stephan-stansfield/cam-mech/CAD/benchtop-prototype/_3d-prints/print 2025-10-21/asm-cams.STEP

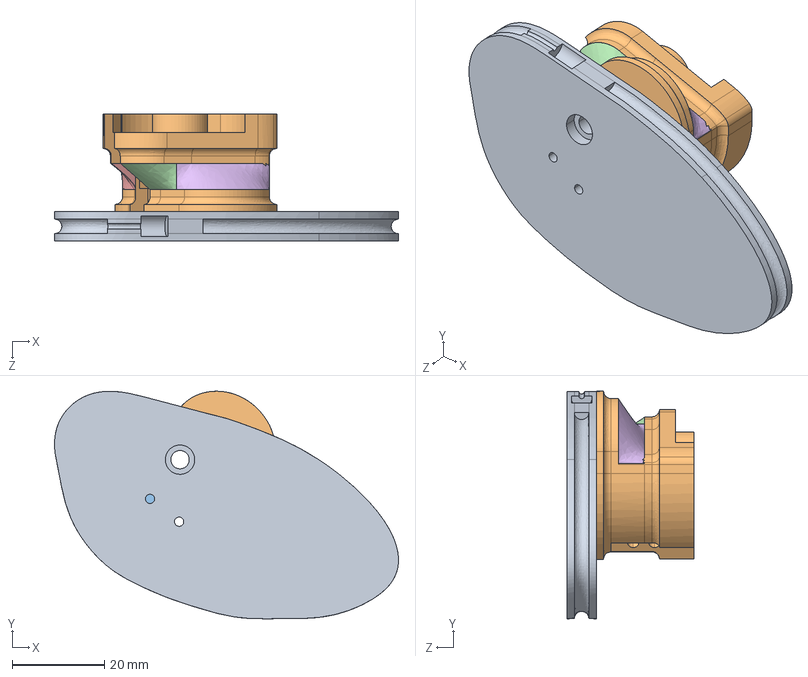
[picture p2: CAD file, 2025-12-18]
CAD/benchtop-prototype/_3d-prints/print 2025-10-21/asm-cams.STEP
74.5 x 49.3 x 27.5 mm
cam-storage
cams-joined^asm-cams
