stephan-stansfield/cam-mech/CAD/benchtop-prototype/_3d-prints/print 2025-10-26/9/cams-joined^asm-cams.STEP

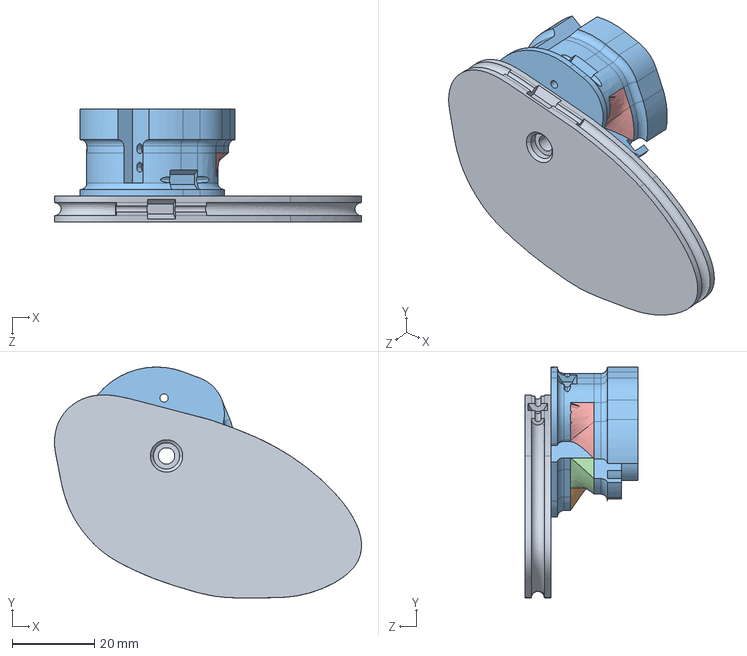
[picture p3: CAD file, 2025-12-18]
CAD/benchtop-prototype/_3d-prints/print 2025-10-26/9/cams-joined^asm-cams.STEP
74.5 x 56.0 x 27.5 mm
