stephan-stansfield/cam-mech/CAD/expanding-pulley/asm_expanding-pulley-asymmetric.SLDASM

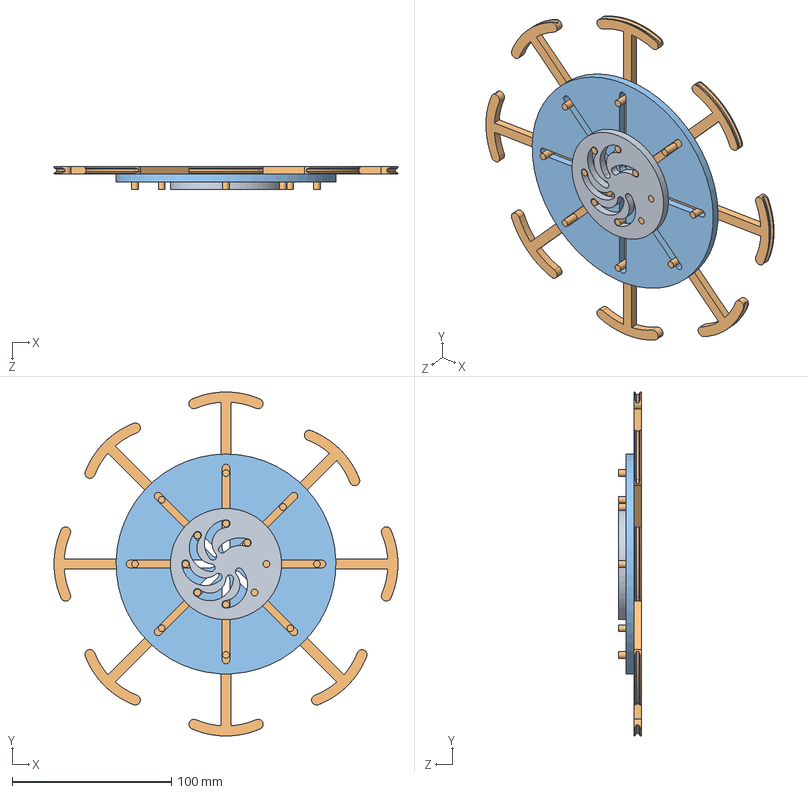
[picture p5: CAD file, 2023-11-07]
CAD/expanding-pulley/asm_expanding-pulley-asymmetric.SLDASM
216.1 x 216.1 x 14.3 mm
pulley-disc-asymmetric
pulley-slider x 8
pulley-slot
