stephan-stansfield/cam-mech/CAD/benchtop-prototype/_3d-prints/print 2024-10-28/NewPart^asm_benchtop_device.STEP

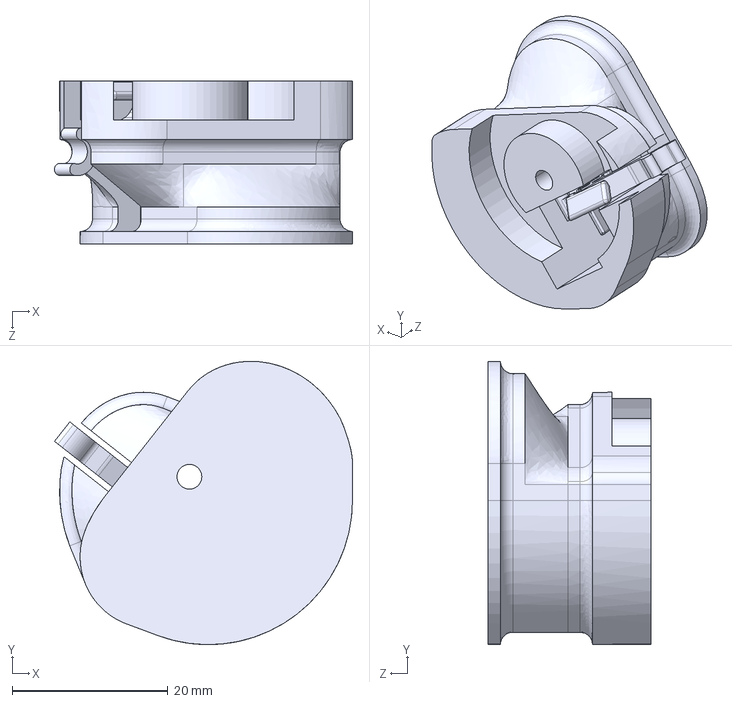
[picture p6: CAD file, 2024-10-28]
CAD/benchtop-prototype/_3d-prints/print 2024-10-28/NewPart^asm_benchtop_device.STEP
38.3 x 36.4 x 20.9 mm
