stephan-stansfield/cam-mech/CAD/benchtop-prototype/_3d-prints/print 2024-11-07/NewPart^asm_benchtop_device.STEP

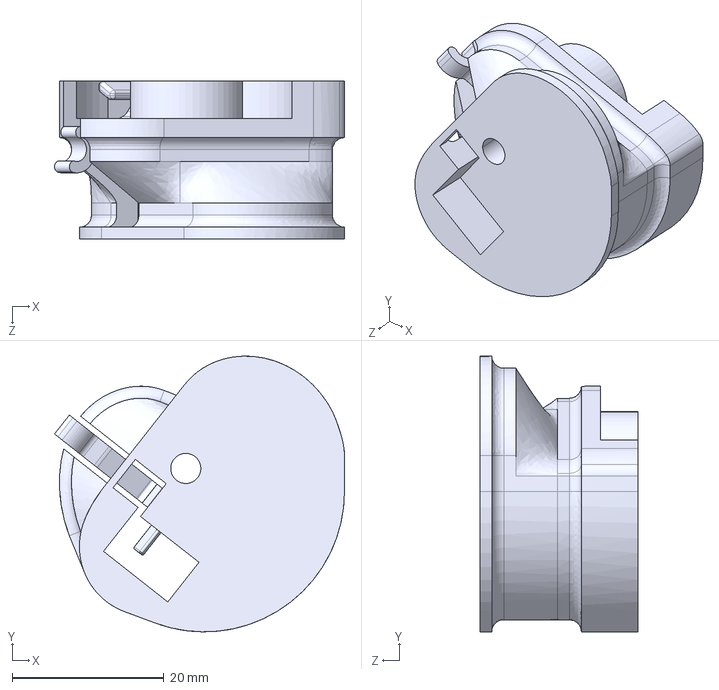
[picture p7: CAD file, 2024-11-07]
CAD/benchtop-prototype/_3d-prints/print 2024-11-07/NewPart^asm_benchtop_device.STEP
38.3 x 36.4 x 20.9 mm
