stephan-stansfield/cam-mech/CAD/benchtop-prototype/_3d-prints/print 2025-10-18/cams-joined^asm-cams.STEP

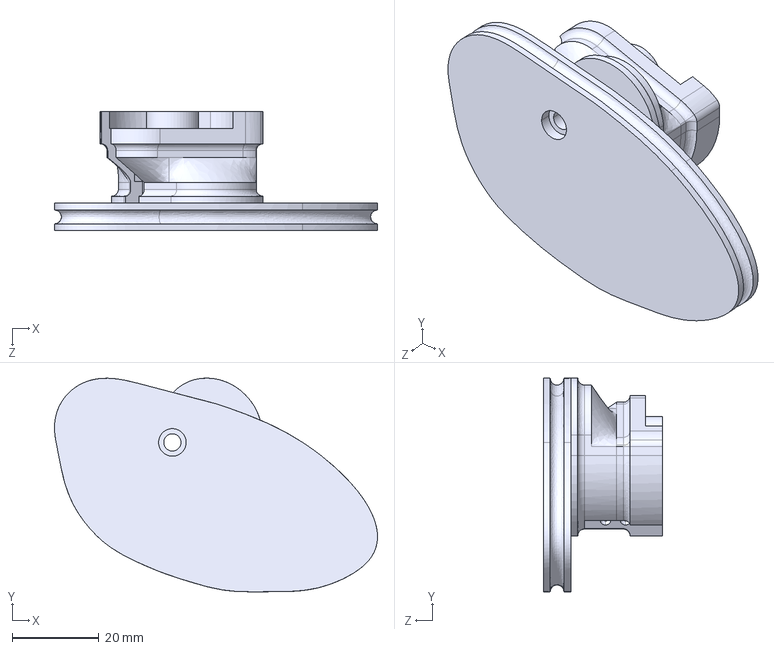
[picture p9: CAD file, 2025-12-18]
CAD/benchtop-prototype/_3d-prints/print 2025-10-18/cams-joined^asm-cams.STEP
74.5 x 49.3 x 27.5 mm
