stephan-stansfield/cam-mech/CAD/benchtop-prototype/_3d-prints/print 2025-11-18/asm-cams.STEP

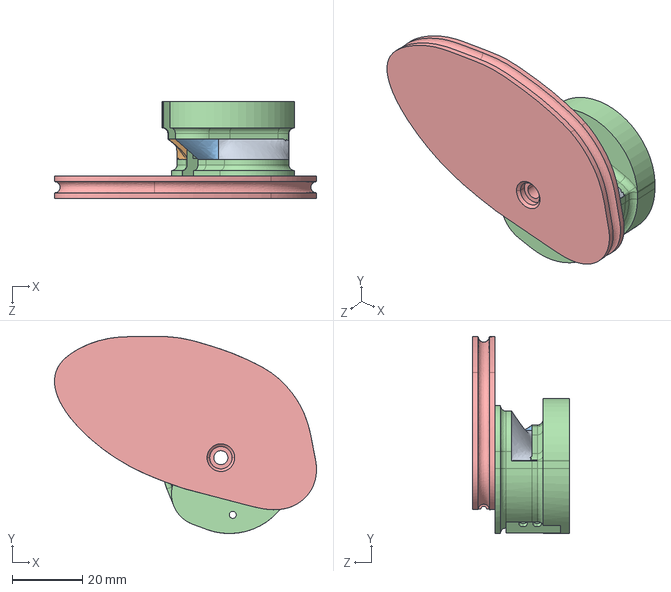
[picture p11: CAD file, 2025-12-18]
CAD/benchtop-prototype/_3d-prints/print 2025-11-18/asm-cams.STEP
74.5 x 56.0 x 27.5 mm
cam-transmission
cam-storage
