stephan-stansfield/cam-mech/CAD/benchtop-prototype/_3d-prints/print 2026-05-18/Part1^asm-cams-no-switching.STEP

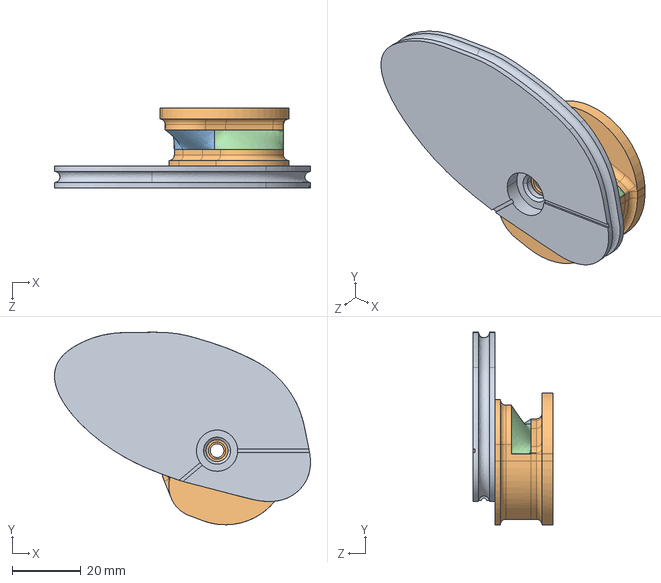
[picture p12: CAD file, 2026-06-06]
CAD/benchtop-prototype/_3d-prints/print 2026-05-18/Part1^asm-cams-no-switching.STEP
74.4 x 56.0 x 23.2 mm
