stephan-stansfield/cam-mech/CAD/benchtop-prototype/_3d-prints/print 2026-07-26/Part1^asm-cams-manual-switching.STEP

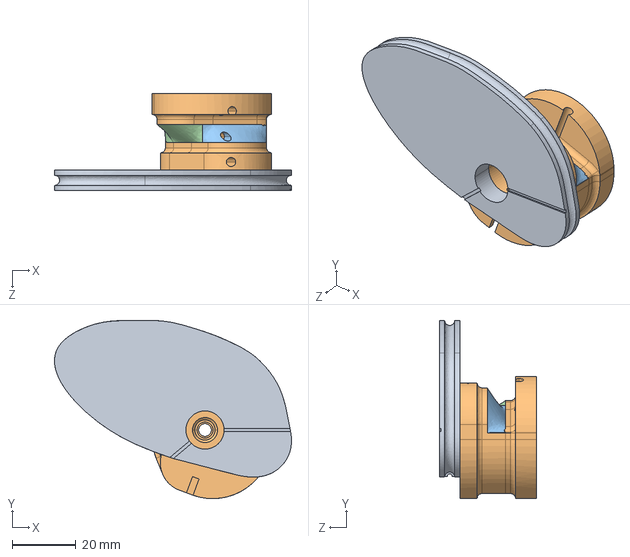
[picture p13: CAD file, 2026-07-26]
CAD/benchtop-prototype/_3d-prints/print 2026-07-26/Part1^asm-cams-manual-switching.STEP
74.5 x 56.0 x 30.4 mm
