stephan-stansfield/cam-mech/CAD/Cam Mechanism CAD 12-2022/prototyping/assembly-check-2023-08-09.SLDASM

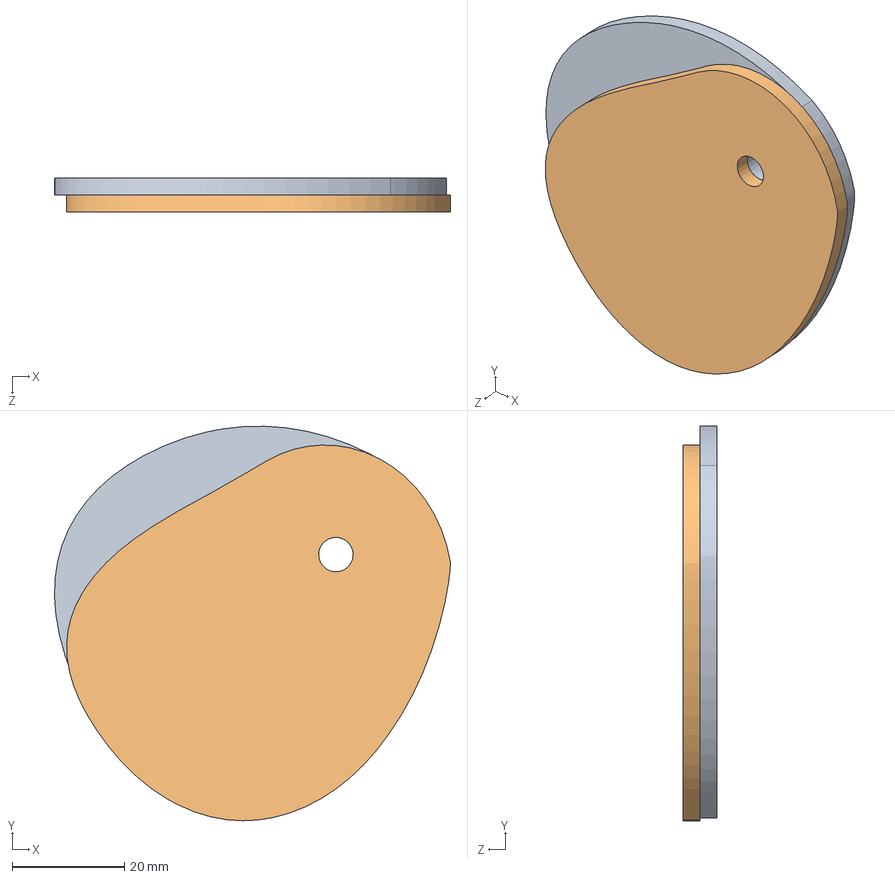
[picture p14: CAD file, 2023-11-07]
CAD/Cam Mechanism CAD 12-2022/prototyping/assembly-check-2023-08-09.SLDASM
70.5 x 70.3 x 6.00 mm
inner_cam_profile_2023-08-09
inner_cam_profile
