stephan-stansfield/cam-mech/CAD/expanding-pulley/asm_expanding-pulley.SLDASM

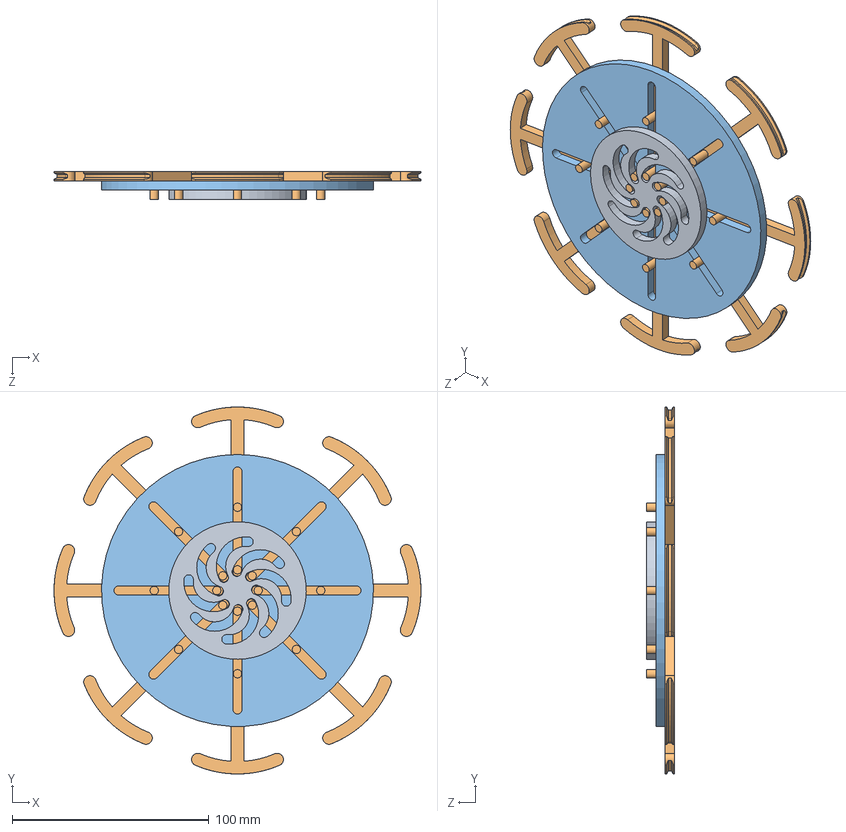
[picture p17: CAD file, 2023-08-03]
CAD/expanding-pulley/asm_expanding-pulley.SLDASM
186.4 x 186.4 x 14.3 mm
pulley-disc
pulley-slider x 8
pulley-slot
