stephan-stansfield/cam-mech/CAD/bistable-switch/asm_2023-11-13/asm_cam_switch.SLDASM

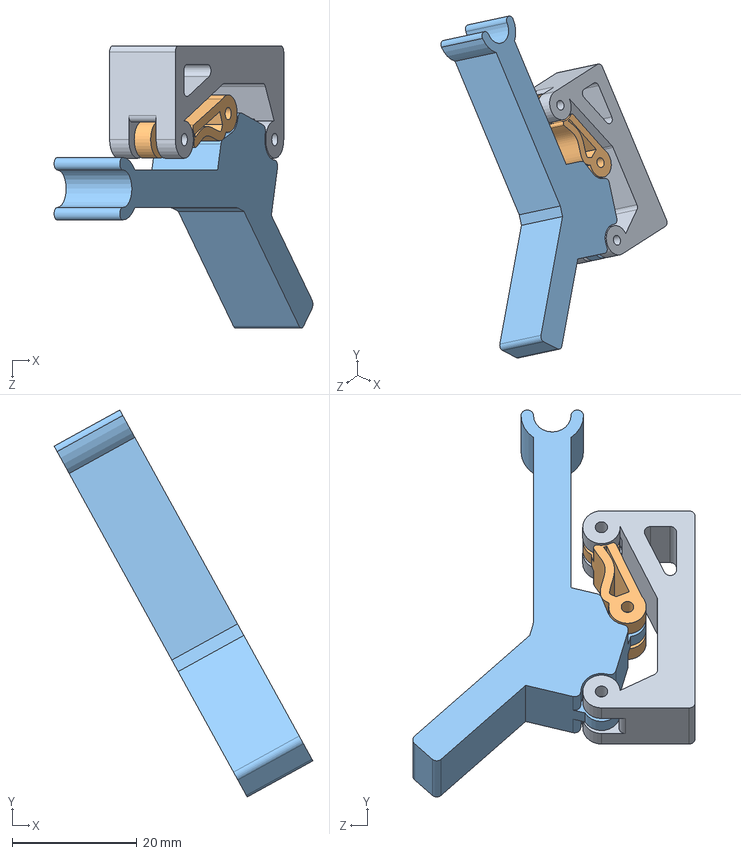
[picture p18: CAD file, 2023-11-07]
CAD/bistable-switch/asm_2023-11-13/asm_cam_switch.SLDASM
41.4 x 61.9 x 45.2 mm
switch-base
switch-hinge
switch-toggle
