stephan-stansfield/cam-mech/CAD/Cam Mechanism CAD 12-2022/cam_assembly_sandbox.SLDASM

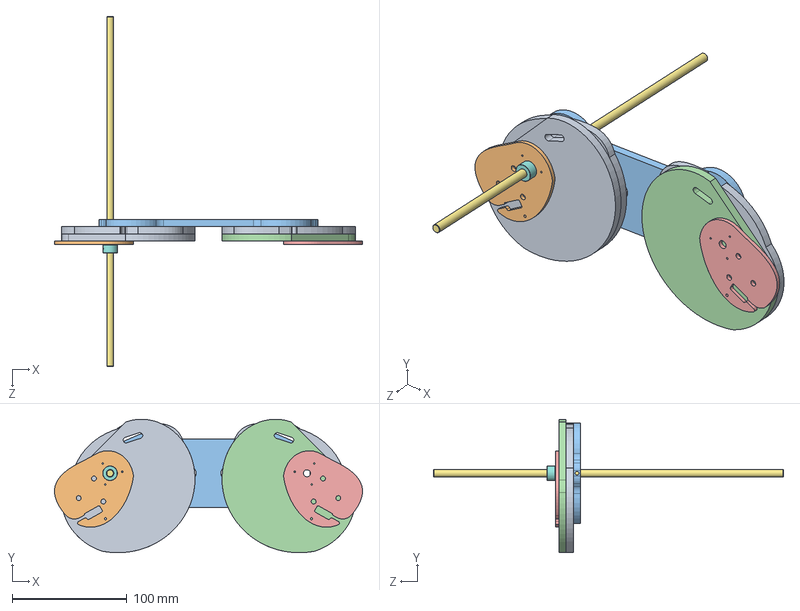
[picture p19: CAD file, 2023-08-03]
CAD/Cam Mechanism CAD 12-2022/cam_assembly_sandbox.SLDASM
268.2 x 116.2 x 304.8 mm
outer_cam_sandbox
inner_cam
cam_backing
Mirrorouter_cam
Mirrorinner_cam
57155K323_Stainless Steel Ball Bearing
8632T139_D-Profile Rotary Shaft
9414T6_Set Screw Shaft Collar
outer_cam_sandbox_profile_2 x 2
