stephan-stansfield/cam-mech/CAD/Cam Mechanism CAD 12-2022/first_prototype/cam_assembly_STS.SLDASM

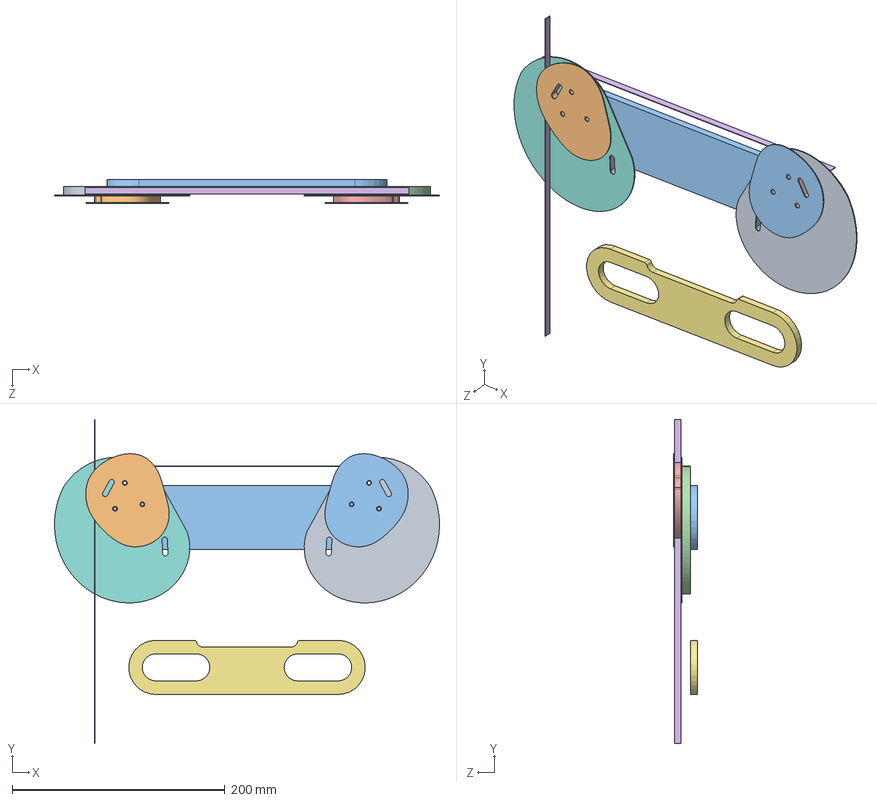
[picture p20: CAD file, 2023-07-26]
CAD/Cam Mechanism CAD 12-2022/first_prototype/cam_assembly_STS.SLDASM
361.7 x 304.8 x 22.3 mm
outer_cam
inner_cam
cam_backing
Mirrorouter_cam
Mirrorinner_cam
elastic_band_between x 2
pull_handle
outer_cam_cover
Mirrorouter_cam_cover
inner_cam_cover
Mirrorinner_cam_cover
