stephan-stansfield/cam-mech/CAD/Cam Mechanism CAD 12-2022/first_prototype/cam_assembly.SLDASM

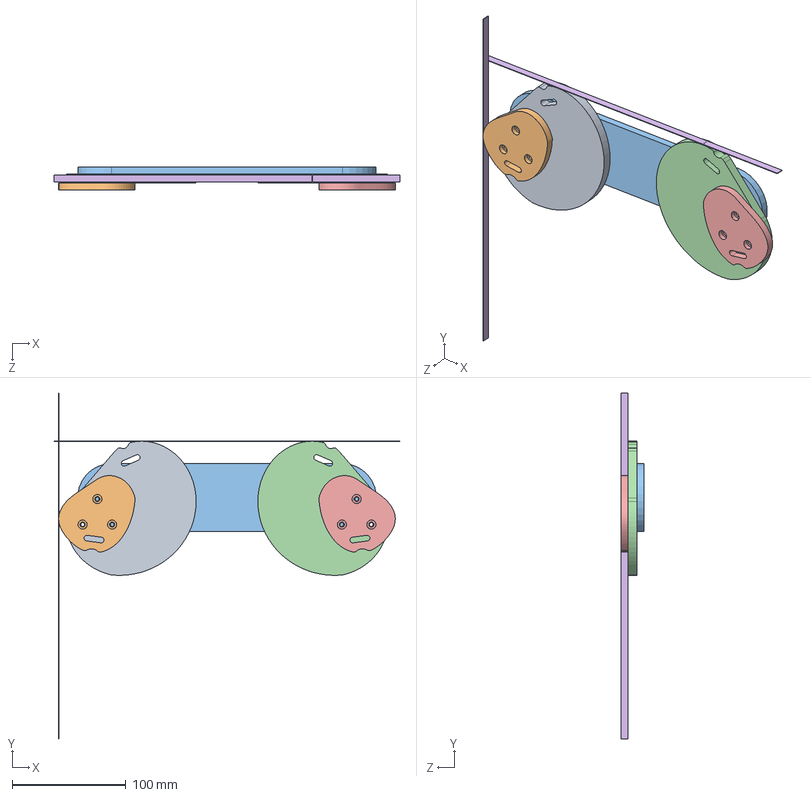
[picture p21: CAD file, 2023-07-26]
CAD/Cam Mechanism CAD 12-2022/first_prototype/cam_assembly.SLDASM
304.8 x 304.8 x 20.7 mm
outer_cam
inner_cam
cam_backing
Mirrorouter_cam
Mirrorinner_cam
elastic_band_between x 2
