stephan-stansfield/cam-mech/CAD/benchtop-prototype/_3d-prints/print 2024-07-30/cam_transmission.STEP

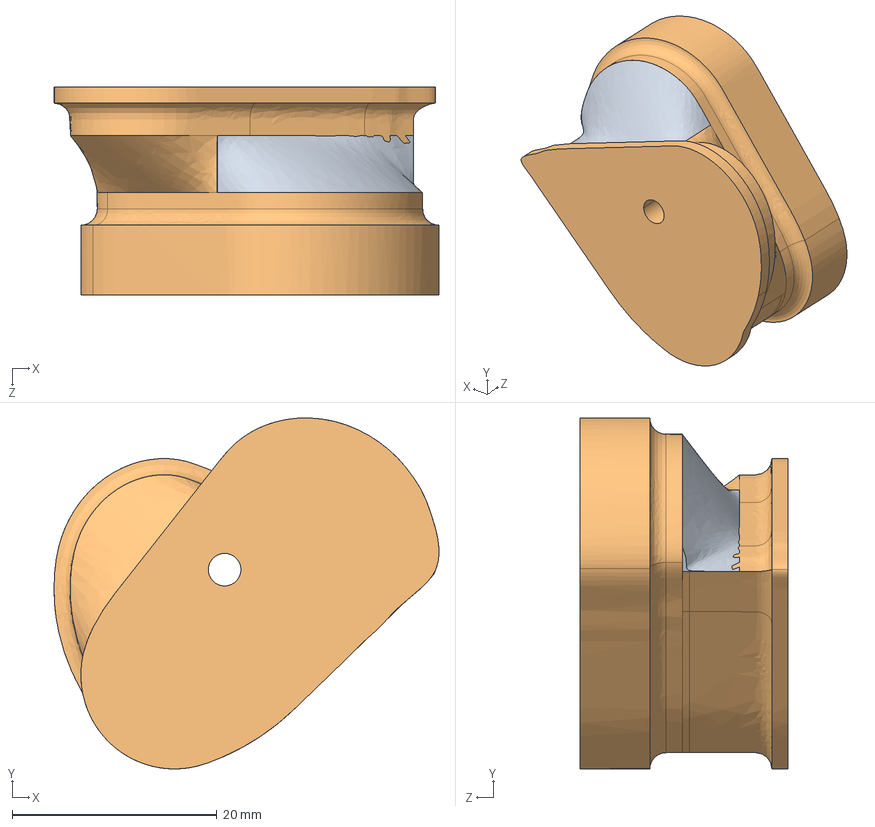
[picture p22: CAD file, 2024-07-30]
CAD/benchtop-prototype/_3d-prints/print 2024-07-30/cam_transmission.STEP
37.6 x 34.3 x 20.3 mm
