stephan-stansfield/cam-mech/CAD/benchtop-prototype/_3d-prints/print 2024-08-01/switch-flexures_rev1.STEP

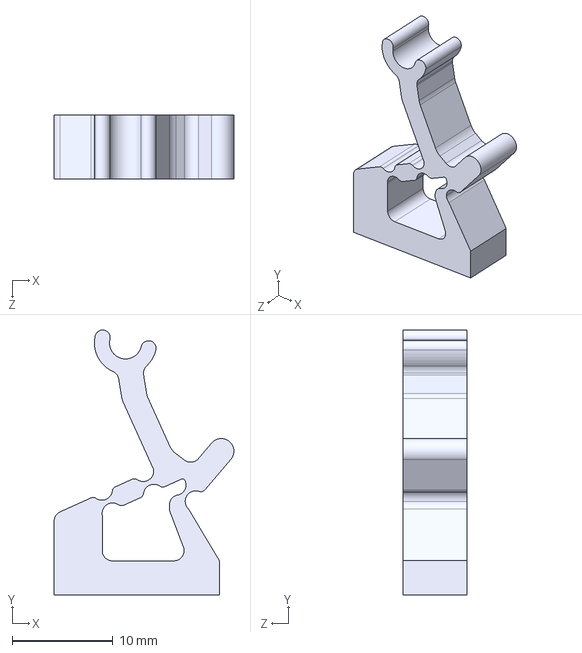
[picture p23: CAD file, 2024-08-21]
CAD/benchtop-prototype/_3d-prints/print 2024-08-01/switch-flexures_rev1.STEP
17.8 x 26.2 x 6.35 mm
