stephan-stansfield/cam-mech/CAD/benchtop-prototype/_3d-prints/print 2024-10-28/derailleur.STEP

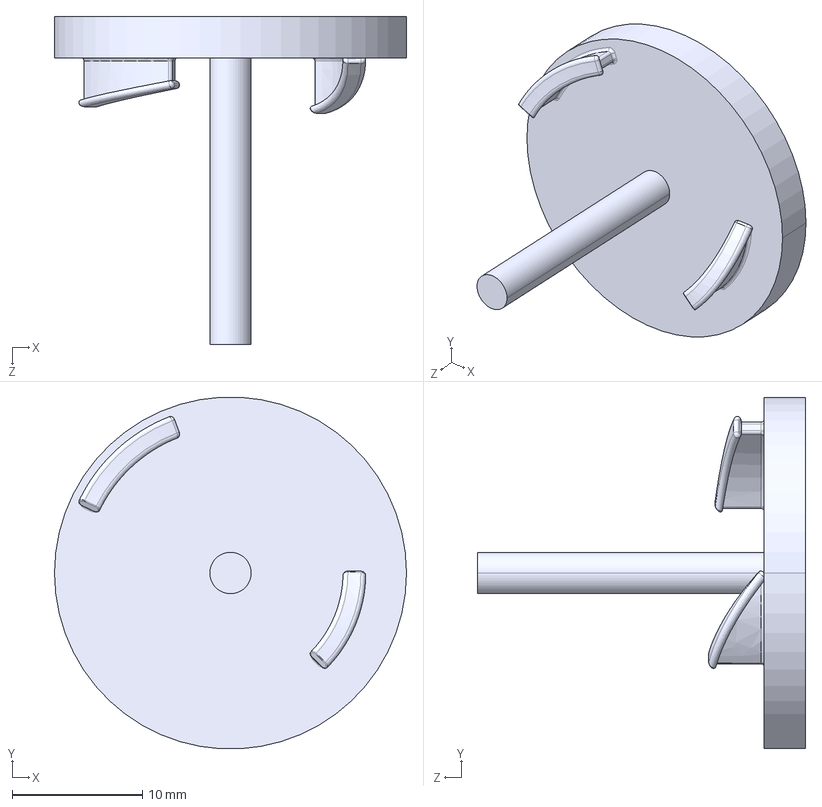
[picture p24: CAD file, 2024-11-01]
CAD/benchtop-prototype/_3d-prints/print 2024-10-28/derailleur.STEP
27.0 x 27.0 x 25.2 mm
