stephan-stansfield/cam-mech/CAD/benchtop-prototype/_3d-prints/print 2024-11-07/derailleur.STEP

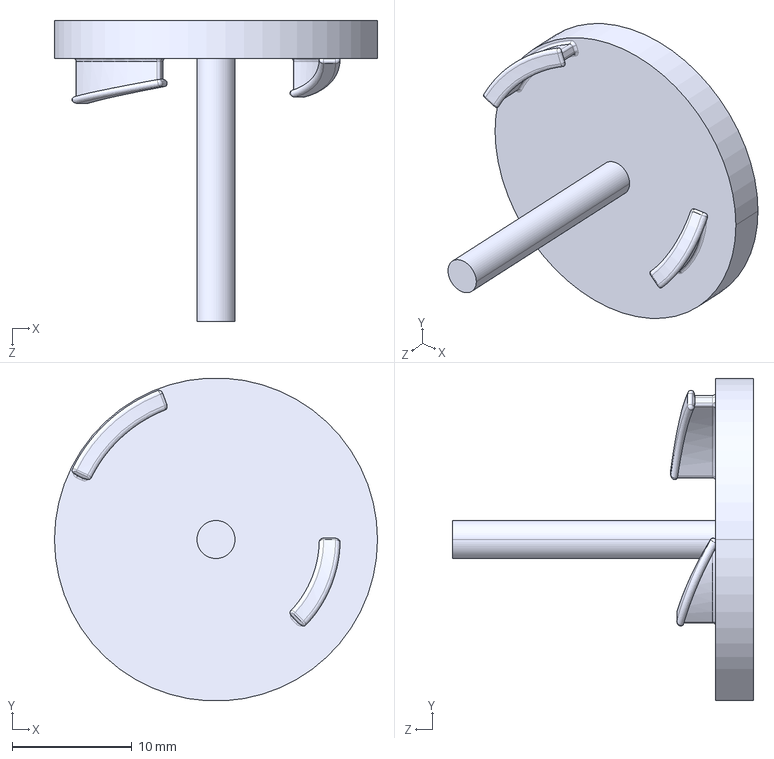
[picture p25: CAD file, 2024-11-07]
CAD/benchtop-prototype/_3d-prints/print 2024-11-07/derailleur.STEP
27.0 x 27.0 x 25.2 mm
