stephan-stansfield/cam-mech/CAD/benchtop-prototype/_3d-prints/print 2024-11-12/switch-flexures.STEP

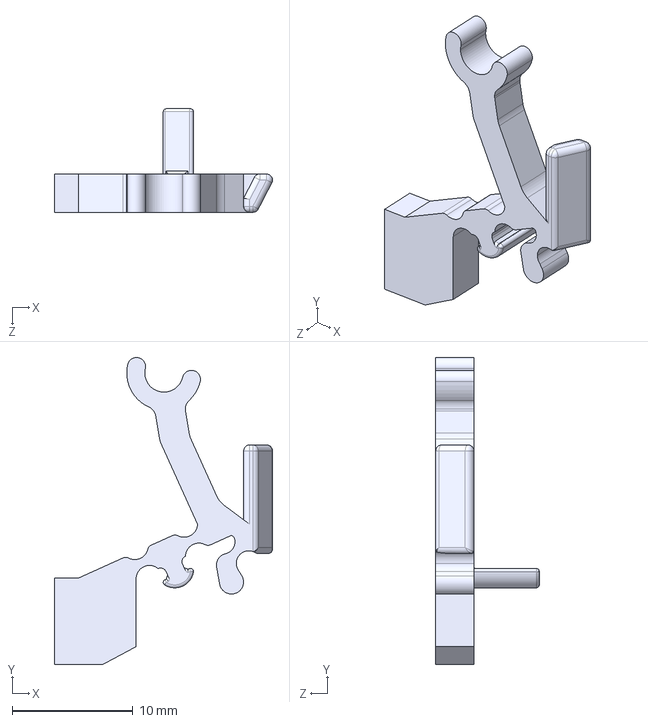
[picture p26: CAD file, 2024-11-12]
CAD/benchtop-prototype/_3d-prints/print 2024-11-12/switch-flexures.STEP
18.1 x 25.5 x 8.59 mm
