stephan-stansfield/cam-mech/CAD/benchtop-prototype/_3d-prints/print 2024-11-15/switch-flexures_0-125in-thick_0-65mm-flex.STEP

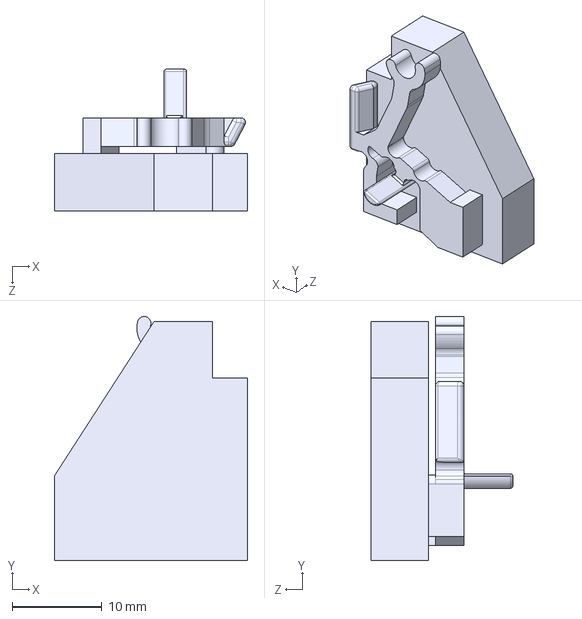
[picture p27: CAD file, 2024-11-15]
CAD/benchtop-prototype/_3d-prints/print 2024-11-15/switch-flexures_0-125in-thick_0-65mm-flex.STEP
21.5 x 27.1 x 15.7 mm
