stephan-stansfield/cam-mech/CAD/benchtop-prototype/_3d-prints/print 2024-11-22/batch 1/switch-flexures_0-1875in-thick_0-65mm-flex.STEP

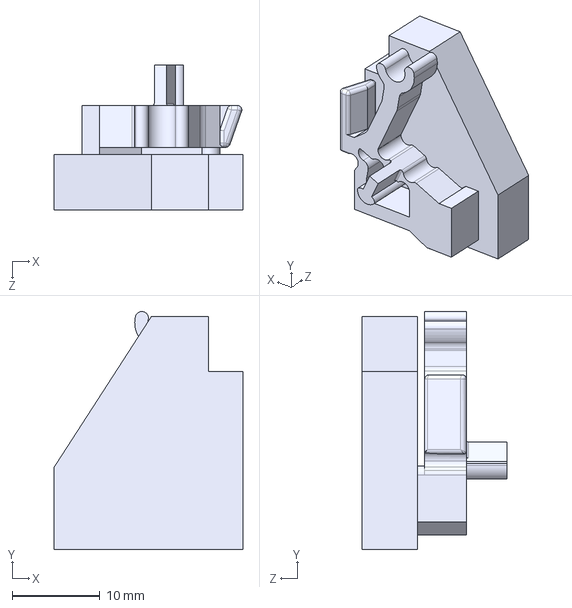
[picture p28: CAD file, 2025-10-06]
CAD/benchtop-prototype/_3d-prints/print 2024-11-22/batch 1/switch-flexures_0-1875in-thick_0-65mm-flex.STEP
21.5 x 27.1 x 16.5 mm
