stephan-stansfield/cam-mech/CAD/benchtop-prototype/_3d-prints/print 2025-09-25/switch-flexures_standalone.STEP

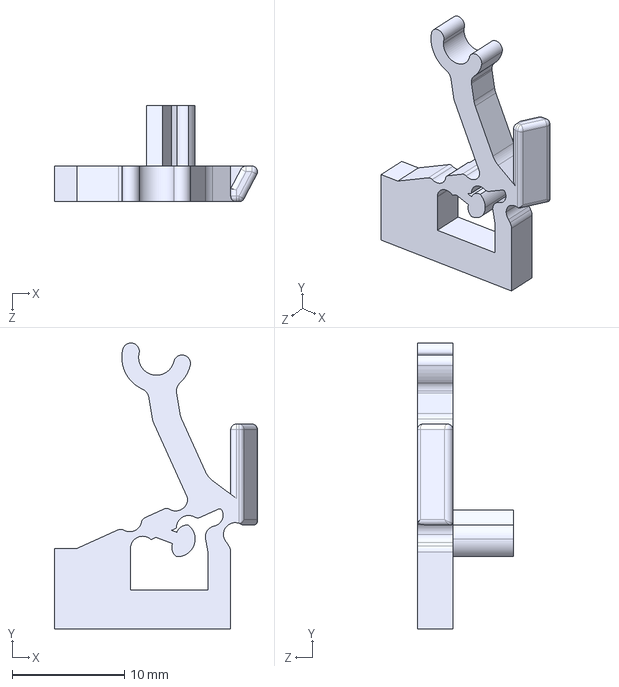
[picture p29: CAD file, 2025-10-06]
CAD/benchtop-prototype/_3d-prints/print 2025-09-25/switch-flexures_standalone.STEP
18.1 x 25.5 x 8.59 mm
