stephan-stansfield/cam-mech/CAD/benchtop-prototype/_3d-prints/print 2025-10-01/switch-flexures-separate.STEP

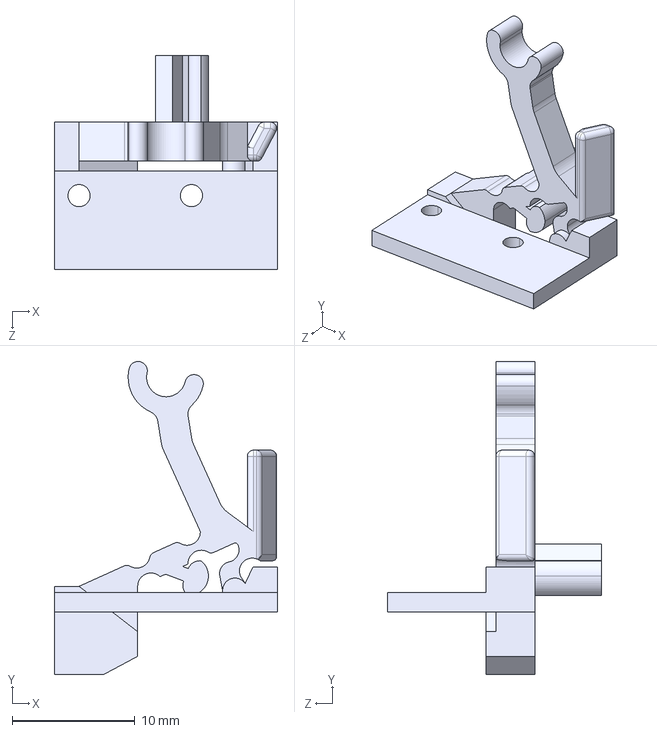
[picture p30: CAD file, 2025-10-06]
CAD/benchtop-prototype/_3d-prints/print 2025-10-01/switch-flexures-separate.STEP
18.1 x 25.5 x 17.4 mm
