stephan-stansfield/cam-mech/CAD/benchtop-prototype/_3d-prints/print 2025-10-07/switch-flexures-separate_v2.STEP

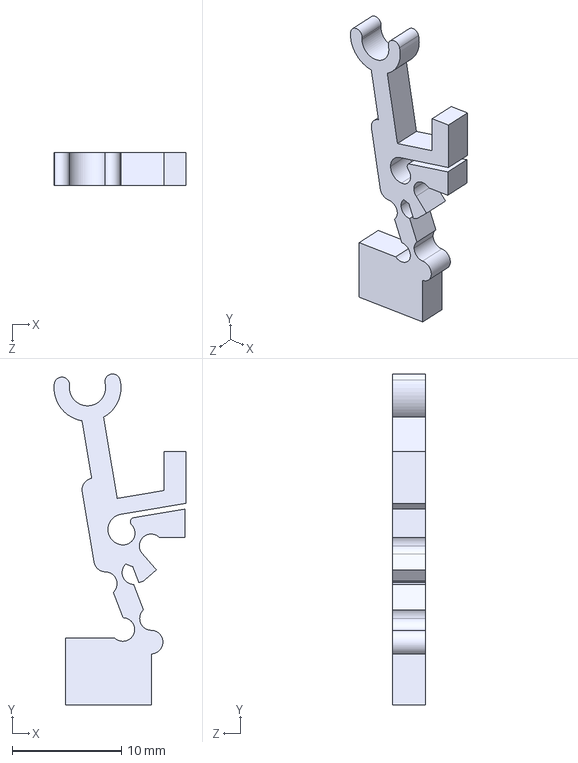
[picture p31: CAD file, 2025-10-17]
CAD/benchtop-prototype/_3d-prints/print 2025-10-07/switch-flexures-separate_v2.STEP
12.1 x 30.3 x 3.00 mm
