stephan-stansfield/cam-mech/CAD/benchtop-prototype/_3d-prints/print 2025-10-08/switch-flexures-separate_v2.STEP

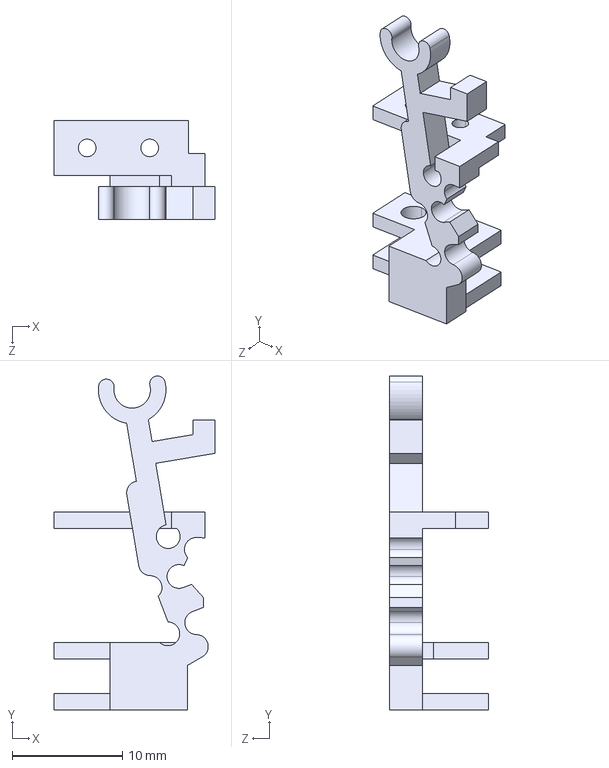
[picture p32: CAD file, 2025-10-17]
CAD/benchtop-prototype/_3d-prints/print 2025-10-08/switch-flexures-separate_v2.STEP
14.6 x 30.3 x 9.00 mm
