stephan-stansfield/cam-mech/CAD/benchtop-prototype/_3d-prints/print 2025-10-10/cam-transmission_v2.STEP

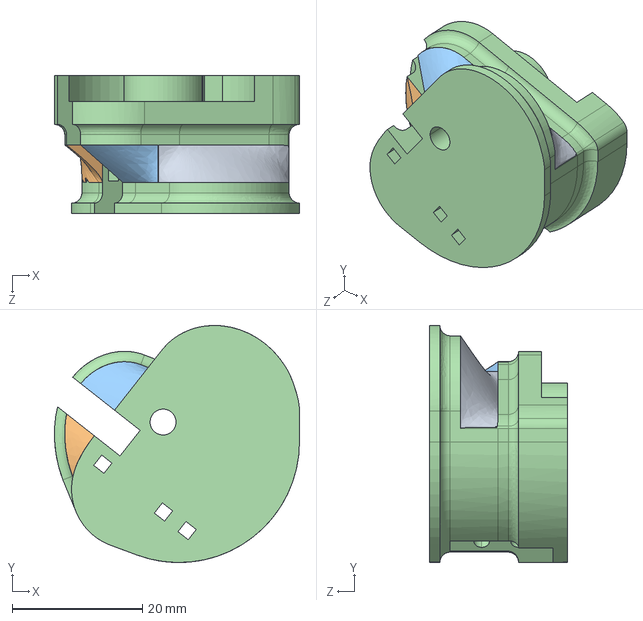
[picture p33: CAD file, 2025-10-17]
CAD/benchtop-prototype/_3d-prints/print 2025-10-10/cam-transmission_v2.STEP
37.6 x 36.4 x 21.2 mm
