stephan-stansfield/cam-mech/CAD/benchtop-prototype/_3d-prints/print 2025-10-13/switch-flexures-separate_v2_one-piece.STEP

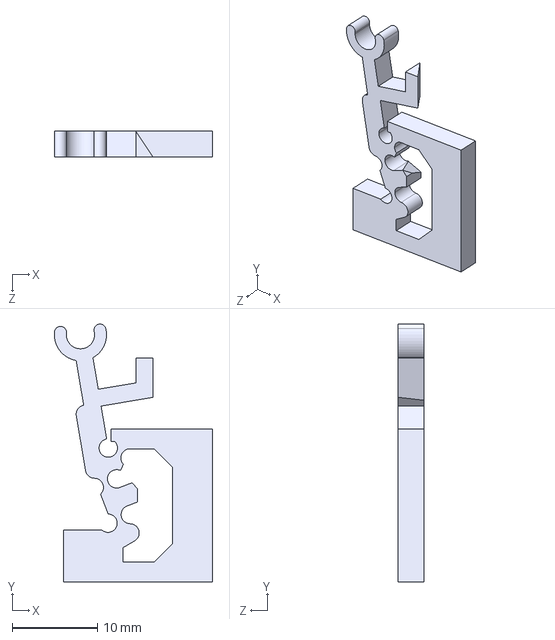
[picture p34: CAD file, 2025-10-17]
CAD/benchtop-prototype/_3d-prints/print 2025-10-13/switch-flexures-separate_v2_one-piece.STEP
18.6 x 30.3 x 3.00 mm
