stephan-stansfield/cam-mech/CAD/benchtop-prototype/_3d-prints/print 2025-10-14/switch-flexures-separate_v2_one-piece-spring-link.STEP

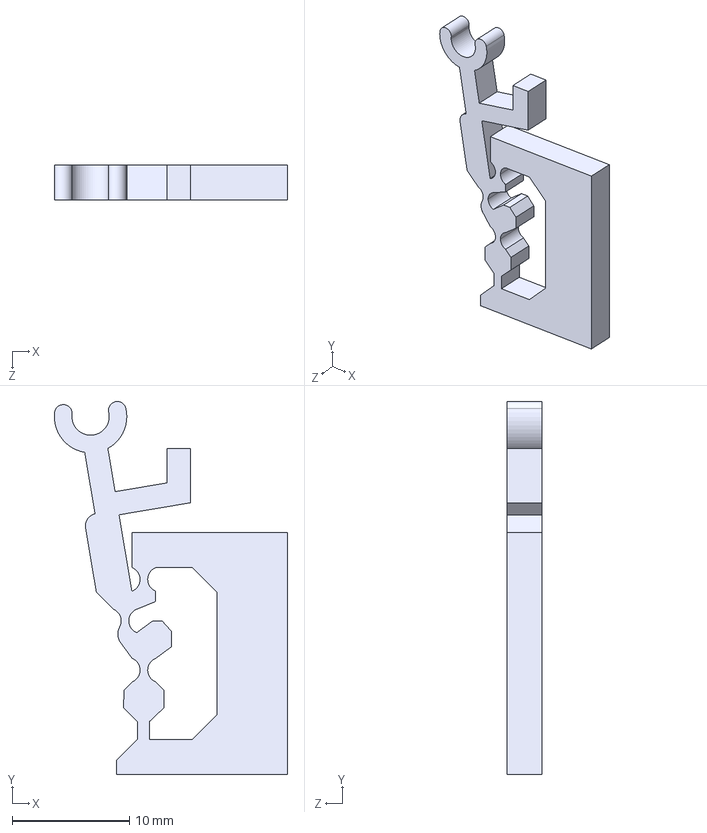
[picture p35: CAD file, 2025-10-17]
CAD/benchtop-prototype/_3d-prints/print 2025-10-14/switch-flexures-separate_v2_one-piece-spring-link.STEP
19.9 x 31.8 x 3.00 mm
