stephan-stansfield/cam-mech/CAD/benchtop-prototype/_3d-prints/print 2025-10-15/2/switch-flexures-separate_v2_one-piece-spring-link.STEP

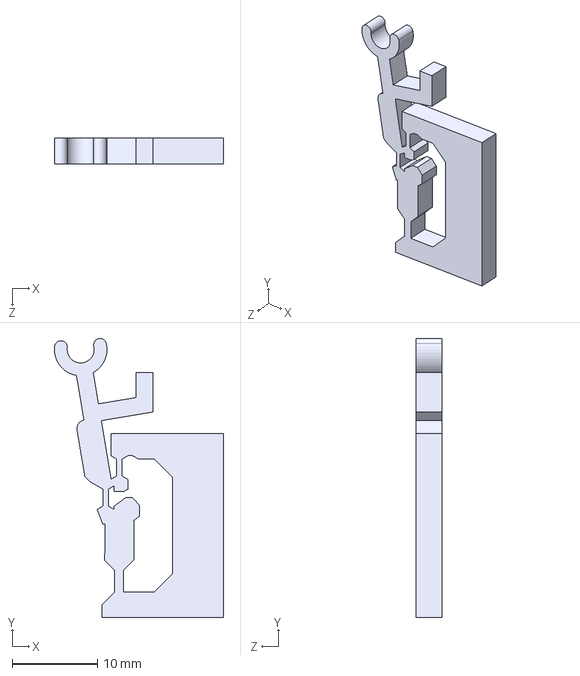
[picture p36: CAD file, 2025-10-17]
CAD/benchtop-prototype/_3d-prints/print 2025-10-15/2/switch-flexures-separate_v2_one-piece-spring-link.STEP
19.9 x 32.8 x 3.00 mm
