stephan-stansfield/cam-mech/CAD/benchtop-prototype/_3d-prints/print 2025-10-17/switch-flexures-separate_v2_one-piece-spring-link.STEP

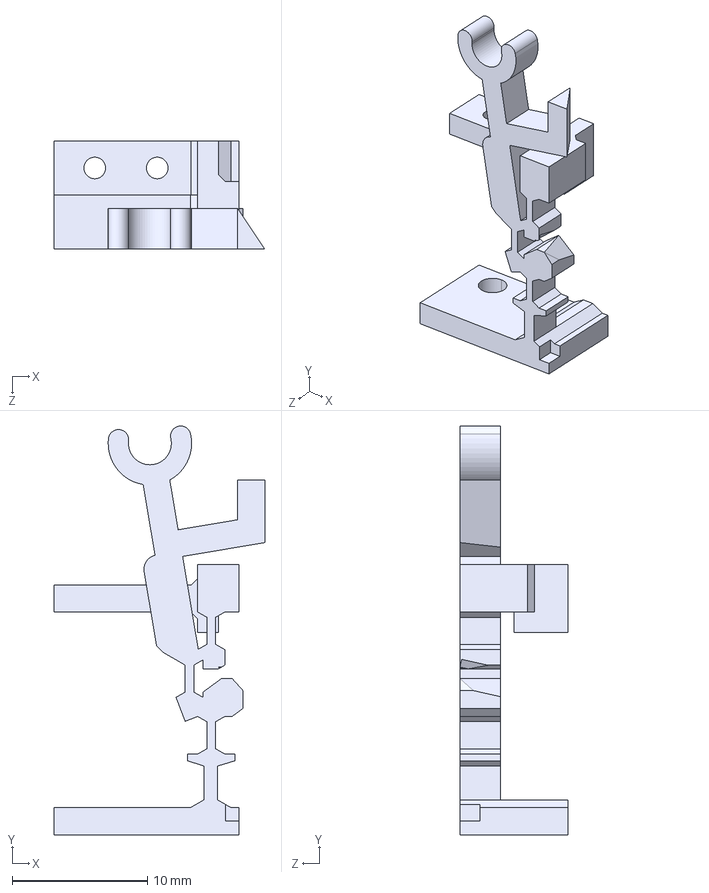
[picture p37: CAD file, 2025-12-18]
CAD/benchtop-prototype/_3d-prints/print 2025-10-17/switch-flexures-separate_v2_one-piece-spring-link.STEP
15.6 x 30.3 x 8.00 mm
