stephan-stansfield/cam-mech/CAD/benchtop-prototype/_3d-prints/print 2025-10-22/switch.STEP

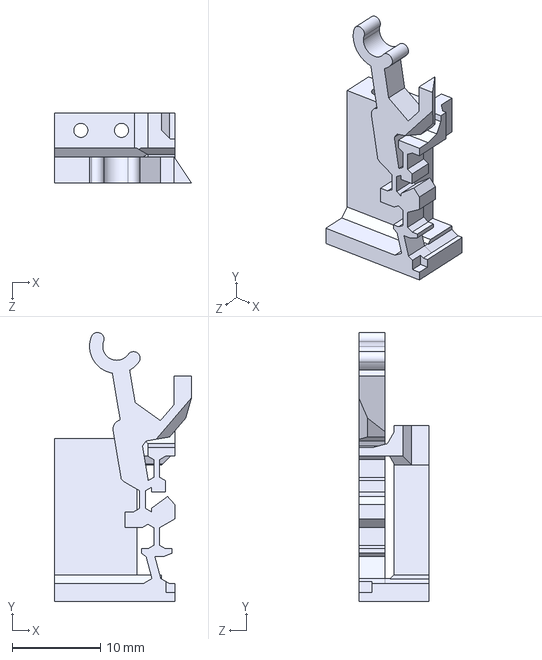
[picture p39: CAD file, 2025-12-18]
CAD/benchtop-prototype/_3d-prints/print 2025-10-22/switch.STEP
15.6 x 30.6 x 8.00 mm
