stephan-stansfield/cam-mech/CAD/benchtop-prototype/_3d-prints/print 2025-10-24/2/cable-sleeve-test.STEP

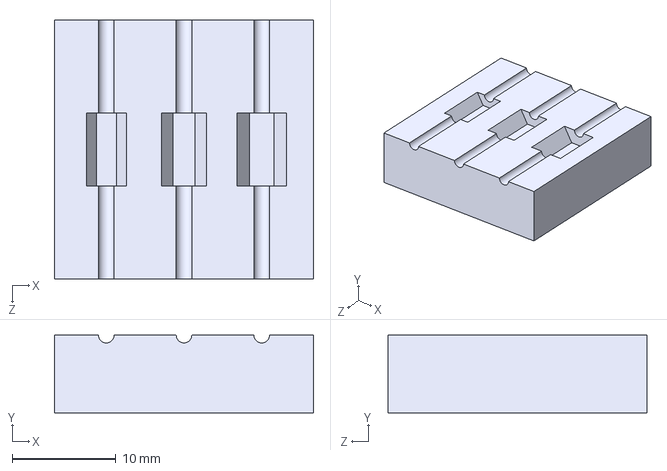
[picture p40: CAD file, 2025-12-18]
CAD/benchtop-prototype/_3d-prints/print 2025-10-24/2/cable-sleeve-test.STEP
25.0 x 7.50 x 25.0 mm
