stephan-stansfield/cam-mech/CAD/benchtop-prototype/_3d-prints/print 2025-10-24/3/storage-cable-jig.STEP

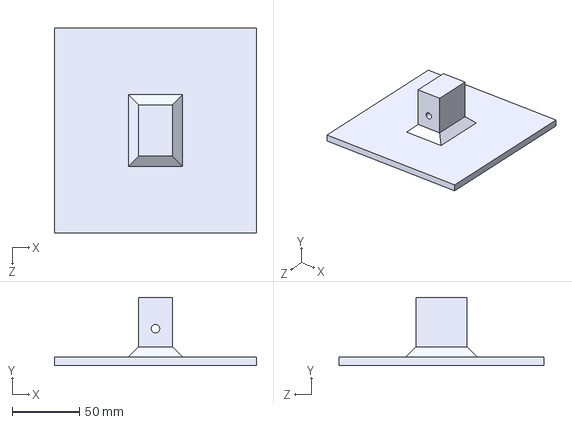
[picture p41: CAD file, 2025-12-18]
CAD/benchtop-prototype/_3d-prints/print 2025-10-24/3/storage-cable-jig.STEP
150.0 x 50.8 x 152.4 mm
