stephan-stansfield/cam-mech/CAD/benchtop-prototype/_3d-prints/print 2025-10-24/kuka-end-effector.STEP

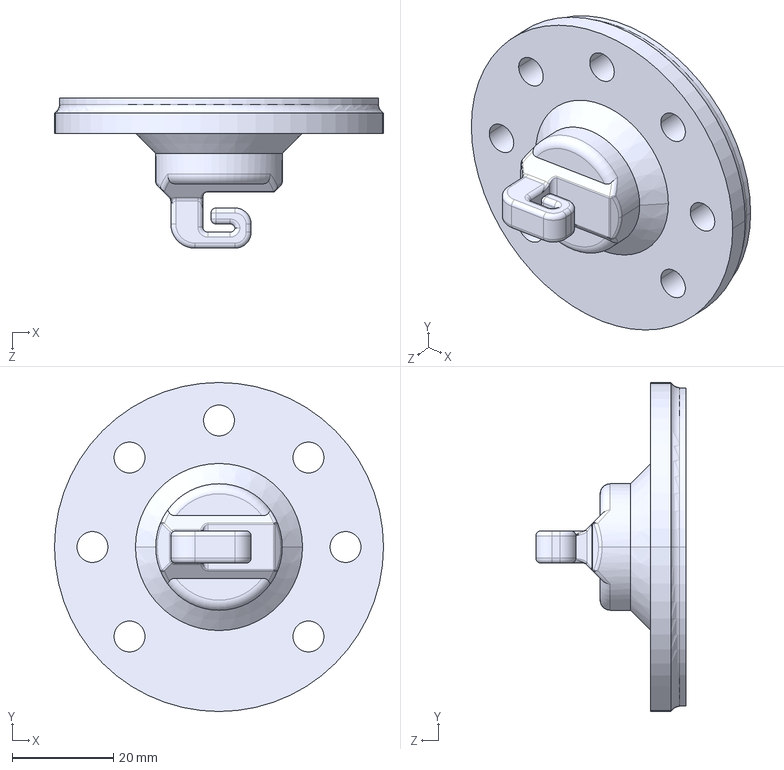
[picture p42: CAD file, 2025-12-18]
CAD/benchtop-prototype/_3d-prints/print 2025-10-24/kuka-end-effector.STEP
65.0 x 65.0 x 29.7 mm
