stephan-stansfield/cam-mech/CAD/benchtop-prototype/_3d-prints/print 2025-10-25/1/derailleur.STEP

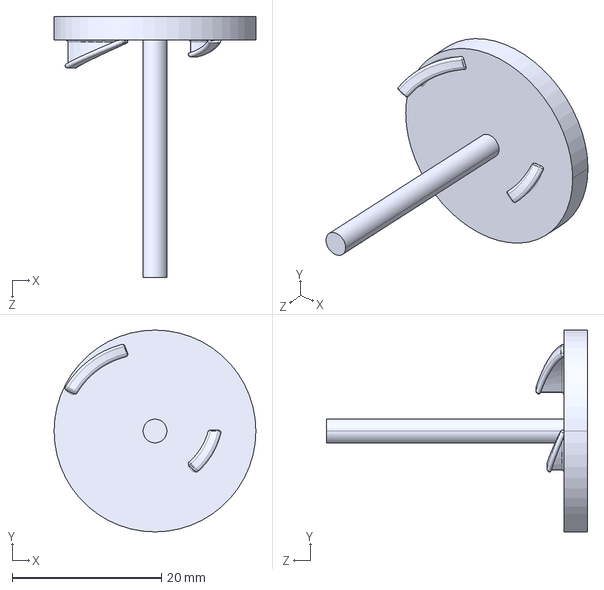
[picture p43: CAD file, 2025-12-18]
CAD/benchtop-prototype/_3d-prints/print 2025-10-25/1/derailleur.STEP
27.0 x 27.0 x 34.9 mm
