stephan-stansfield/cam-mech/CAD/benchtop-prototype/_3d-prints/print 2025-10-26/4/switch-thin-hinges.STEP

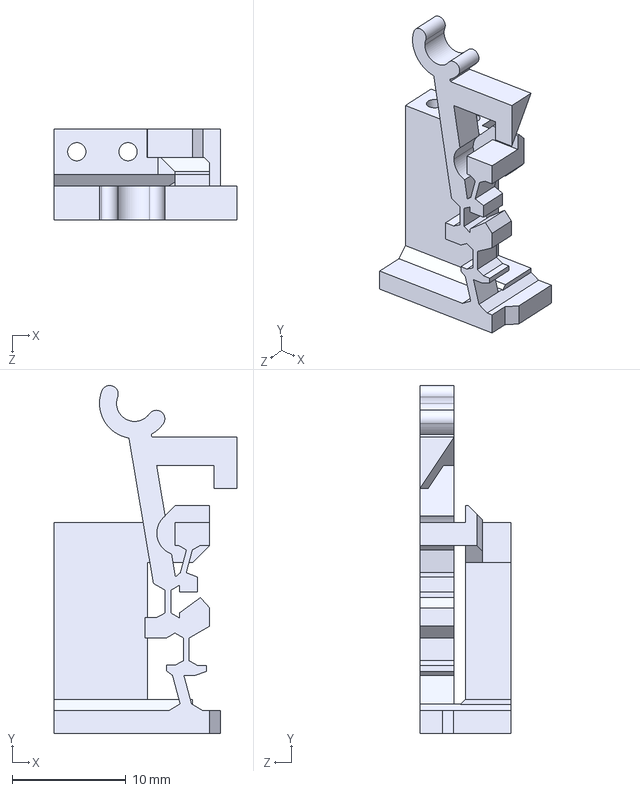
[picture p45: CAD file, 2025-12-18]
CAD/benchtop-prototype/_3d-prints/print 2025-10-26/4/switch-thin-hinges.STEP
16.1 x 30.6 x 8.00 mm
