stephan-stansfield/cam-mech/CAD/benchtop-prototype/_3d-prints/print 2025-10-26/6/switch-low-thin-compliant-link-thin-hinges.STEP

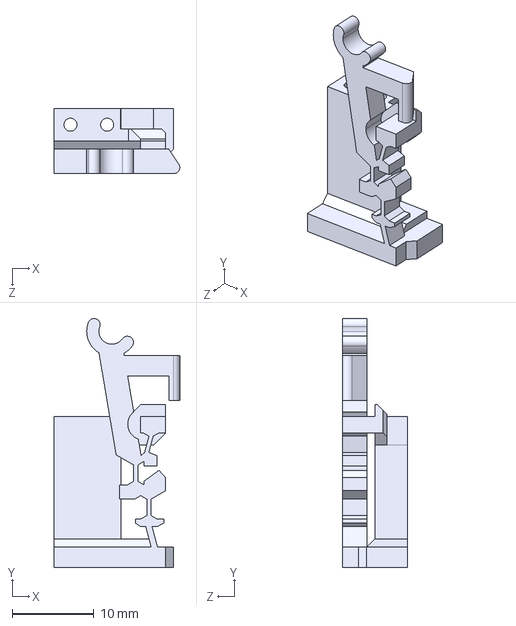
[picture p46: CAD file, 2025-12-18]
CAD/benchtop-prototype/_3d-prints/print 2025-10-26/6/switch-low-thin-compliant-link-thin-hinges.STEP
15.4 x 30.6 x 8.00 mm
