stephan-stansfield/cam-mech/CAD/benchtop-prototype/_3d-prints/print 2025-10-26/8/derailleur-wide.STEP

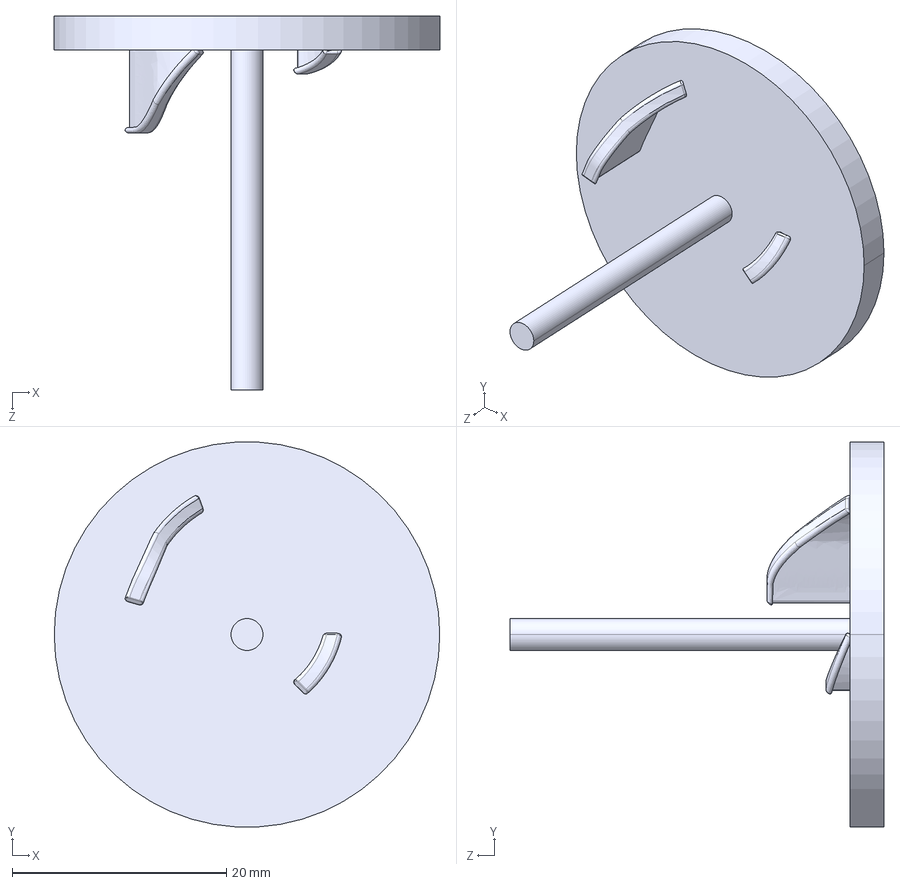
[picture p47: CAD file, 2025-12-18]
CAD/benchtop-prototype/_3d-prints/print 2025-10-26/8/derailleur-wide.STEP
36.0 x 35.9 x 34.9 mm
