stephan-stansfield/cam-mech/CAD/benchtop-prototype/_3d-prints/print 2025-10-28/derailleur-jig-up-to-down-only.STEP

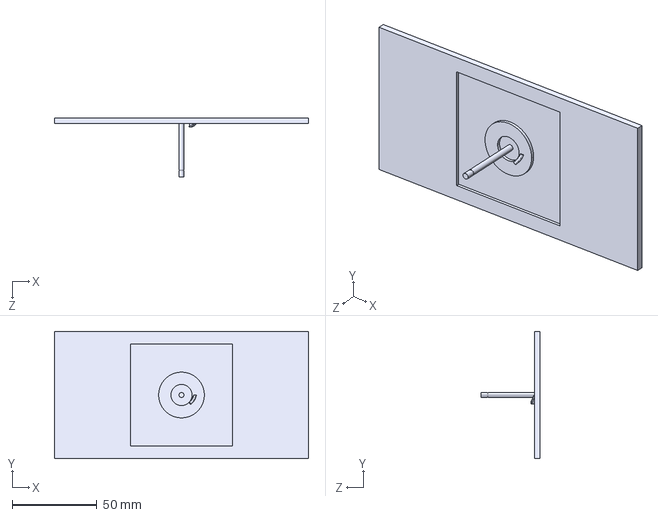
[picture p49: CAD file, 2025-12-18]
CAD/benchtop-prototype/_3d-prints/print 2025-10-28/derailleur-jig-up-to-down-only.STEP
150.0 x 75.0 x 34.9 mm
