stephan-stansfield/cam-mech/CAD/benchtop-prototype/_3d-prints/print 2025-11-05/1/sleeve-hole.STEP

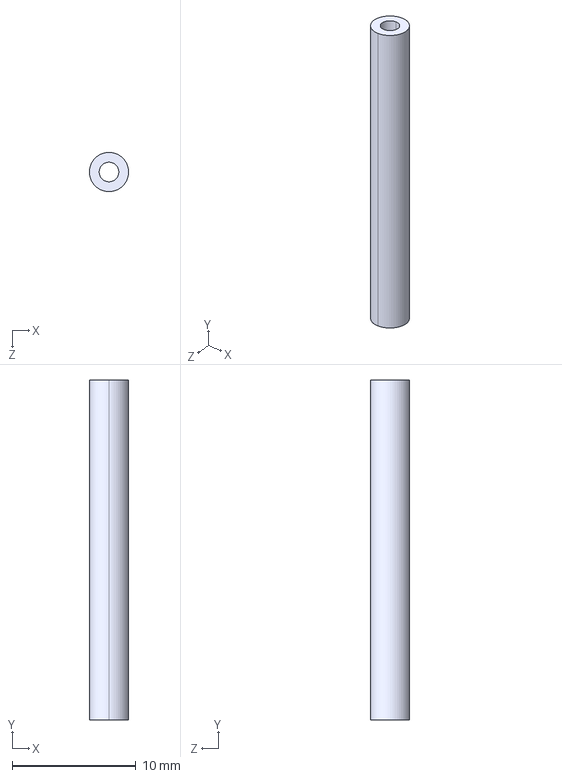
[picture p50: CAD file, 2025-12-18]
CAD/benchtop-prototype/_3d-prints/print 2025-11-05/1/sleeve-hole.STEP
3.17 x 27.5 x 3.17 mm
