stephan-stansfield/cam-mech/CAD/benchtop-prototype/_3d-prints/print 2025-11-10/1/switch-one-hinge-angled-increase-angle.STEP

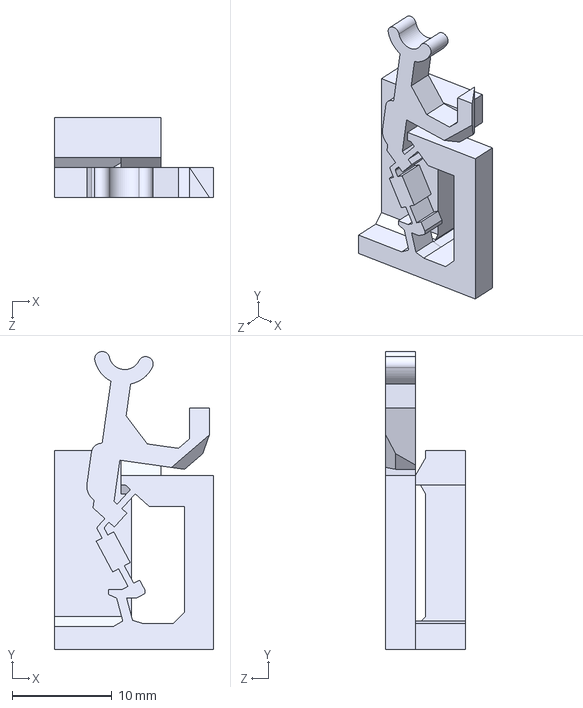
[picture p51: CAD file, 2025-12-18]
CAD/benchtop-prototype/_3d-prints/print 2025-11-10/1/switch-one-hinge-angled-increase-angle.STEP
16.0 x 29.9 x 8.00 mm
