stephan-stansfield/cam-mech/CAD/benchtop-prototype/_3d-prints/print 2025-11-11/2/switch-one-hinge-angled-increase-angle.STEP

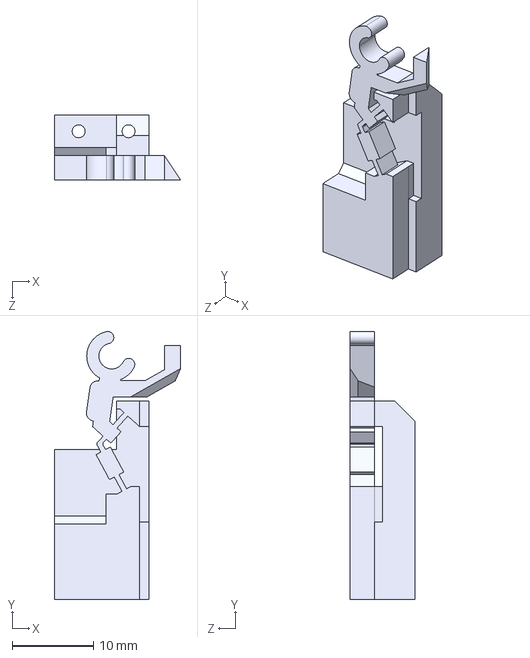
[picture p54: CAD file, 2025-12-18]
CAD/benchtop-prototype/_3d-prints/print 2025-11-11/2/switch-one-hinge-angled-increase-angle.STEP
15.6 x 33.1 x 8.00 mm
