stephan-stansfield/cam-mech/CAD/benchtop-prototype/_3d-prints/print 2025-11-12/switch-one-hinge-angled-increase-angle-support-test.STEP

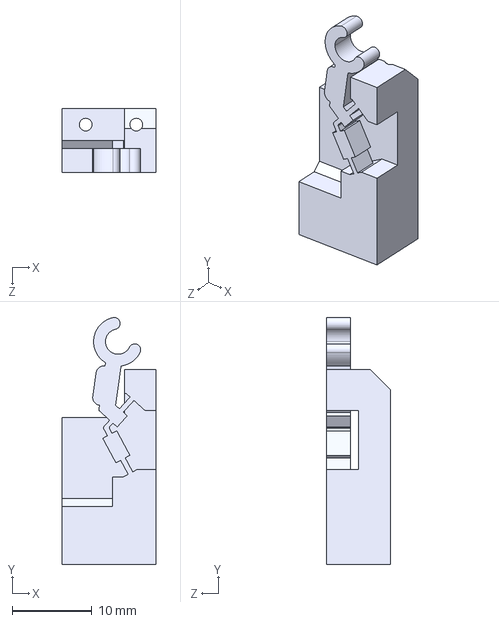
[picture p55: CAD file, 2025-12-18]
CAD/benchtop-prototype/_3d-prints/print 2025-11-12/switch-one-hinge-angled-increase-angle-support-test.STEP
11.9 x 31.1 x 8.00 mm
