stephan-stansfield/cam-mech/CAD/benchtop-prototype/_3d-prints/print 2025-11-14/1/switch-extended-mechanism.STEP

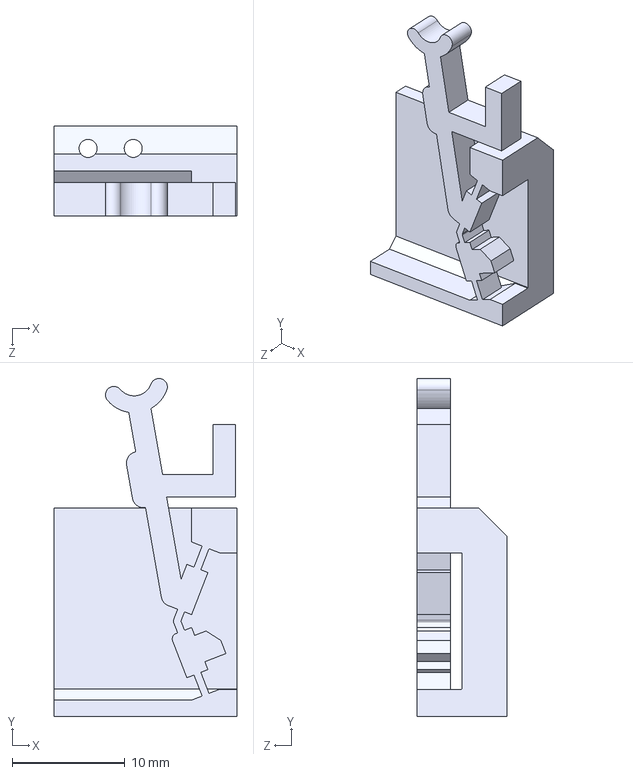
[picture p56: CAD file, 2025-12-18]
CAD/benchtop-prototype/_3d-prints/print 2025-11-14/1/switch-extended-mechanism.STEP
16.2 x 30.0 x 8.00 mm
