stephan-stansfield/cam-mech/CAD/benchtop-prototype/_3d-prints/print 2025-11-17/1/cam-transmission.STEP

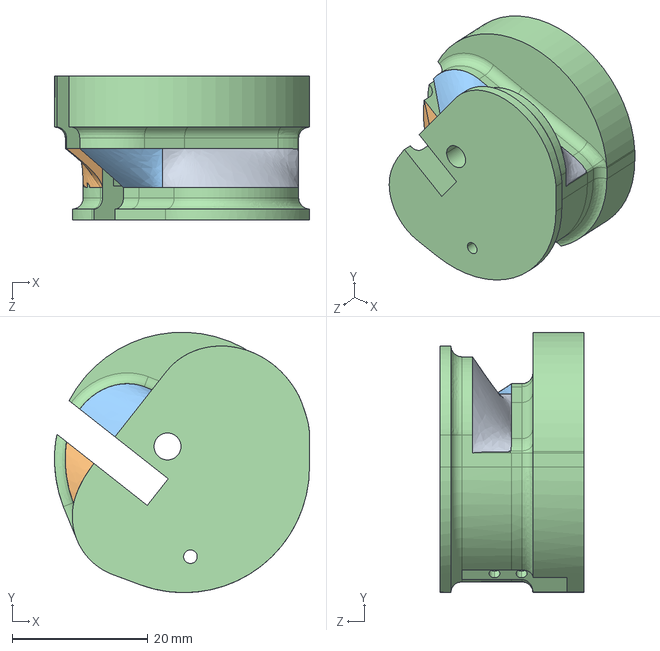
[picture p57: CAD file, 2025-12-18]
CAD/benchtop-prototype/_3d-prints/print 2025-11-17/1/cam-transmission.STEP
37.6 x 38.4 x 21.2 mm
