stephan-stansfield/cam-mech/CAD/benchtop-prototype/_3d-prints/print 2025-11-18/switch-extended-mechanism-1_0mm.STEP

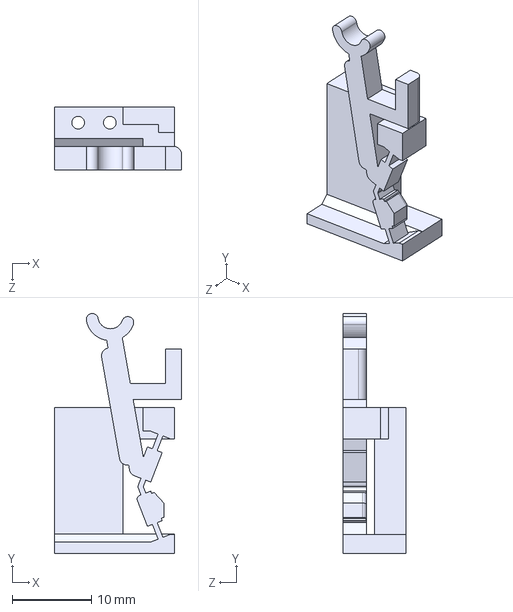
[picture p58: CAD file, 2025-12-18]
CAD/benchtop-prototype/_3d-prints/print 2025-11-18/switch-extended-mechanism-1_0mm.STEP
16.1 x 30.3 x 8.00 mm
