stephan-stansfield/cam-mech/CAD/benchtop-prototype/_3d-prints/print 2025-11-20/derailleur-jig-no-axle.STEP

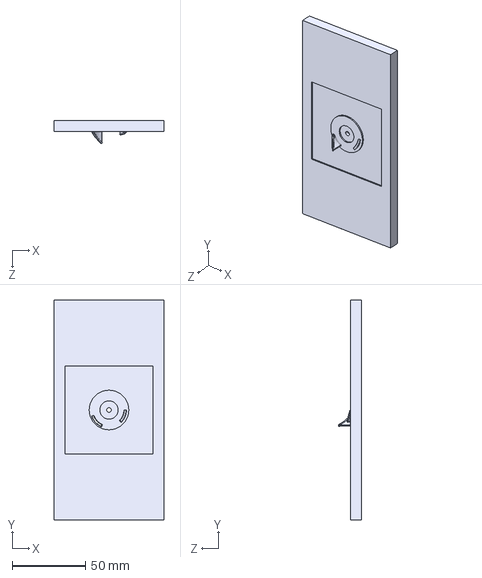
[picture p59: CAD file, 2025-12-18]
CAD/benchtop-prototype/_3d-prints/print 2025-11-20/derailleur-jig-no-axle.STEP
75.0 x 150.0 x 15.7 mm
