stephan-stansfield/cam-mech/CAD/benchtop-prototype/_3d-prints/print 2025-12-04/derailleur-separate.STEP

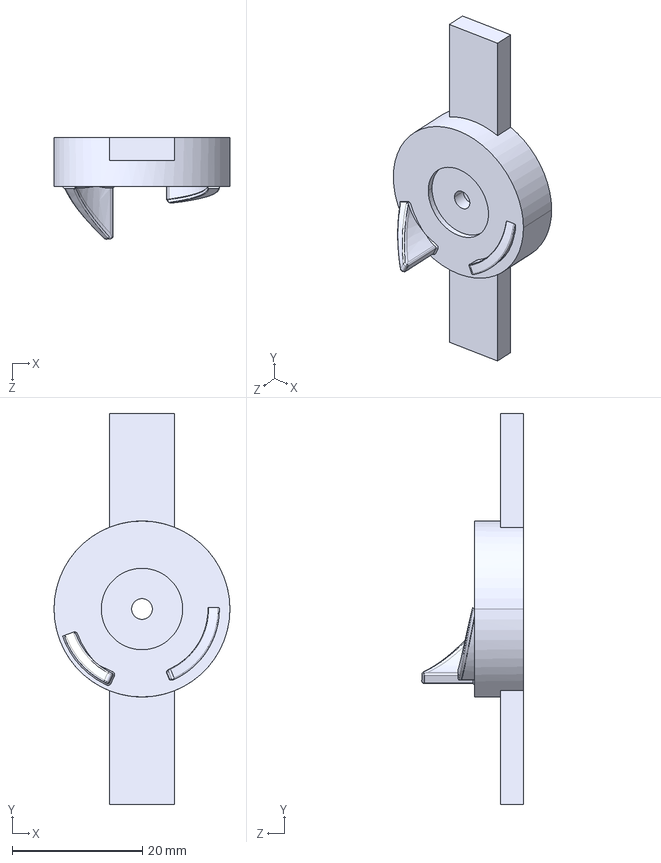
[picture p60: CAD file, 2025-12-18]
CAD/benchtop-prototype/_3d-prints/print 2025-12-04/derailleur-separate.STEP
27.0 x 60.0 x 15.6 mm
