stephan-stansfield/cam-mech/CAD/benchtop-prototype/_3d-prints/print 2025-12-11/derailleur-separate.STEP

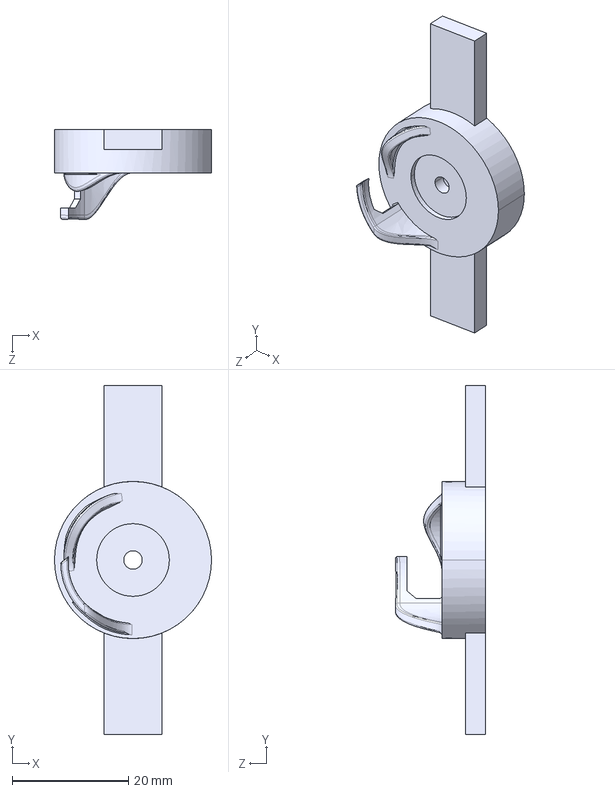
[picture p61: CAD file, 2025-12-18]
CAD/benchtop-prototype/_3d-prints/print 2025-12-11/derailleur-separate.STEP
27.0 x 60.0 x 15.5 mm
