stephan-stansfield/cam-mech/CAD/benchtop-prototype/_3d-prints/print 2025-12-13/2/derailleur-separate.STEP

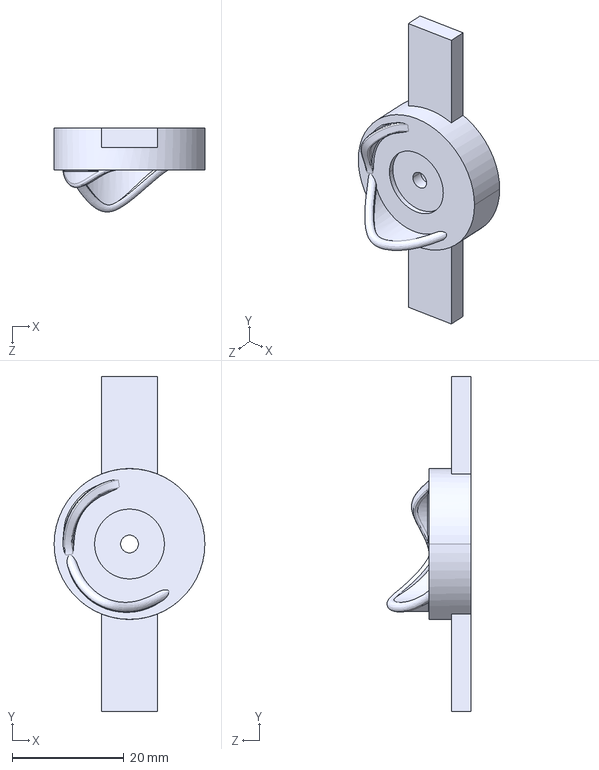
[picture p62: CAD file, 2025-12-18]
CAD/benchtop-prototype/_3d-prints/print 2025-12-13/2/derailleur-separate.STEP
27.0 x 60.0 x 15.0 mm
