stephan-stansfield/cam-mech/CAD/benchtop-prototype/_3d-prints/print 2026-01-08/derailleur-separate-no-ramps.STEP

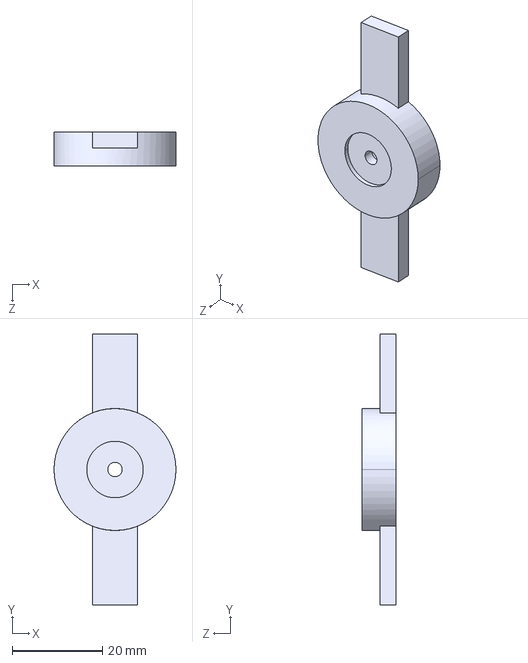
[picture p63: CAD file, 2026-01-13]
CAD/benchtop-prototype/_3d-prints/print 2026-01-08/derailleur-separate-no-ramps.STEP
27.0 x 60.0 x 7.50 mm
