stephan-stansfield/cam-mech/CAD/benchtop-prototype/_3d-prints/print 2026-05-18/derailleur-jig-no-switching.STEP

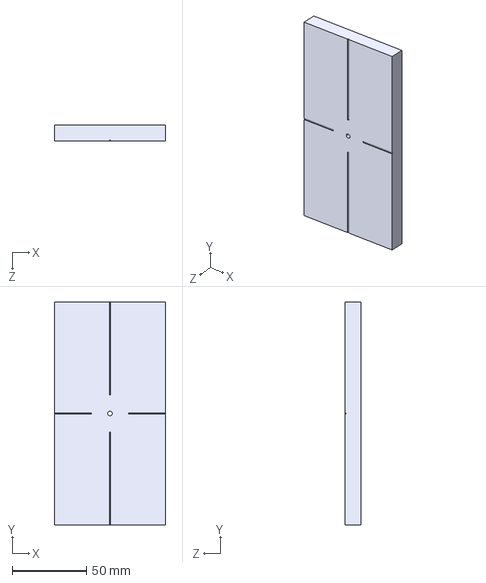
[picture p64: CAD file, 2026-06-06]
CAD/benchtop-prototype/_3d-prints/print 2026-05-18/derailleur-jig-no-switching.STEP
75.0 x 150.0 x 10.5 mm
