stephan-stansfield/cam-mech/CAD/benchtop-prototype/_3d-prints/print 2026-07-26/carriage-cable-adapter.STL

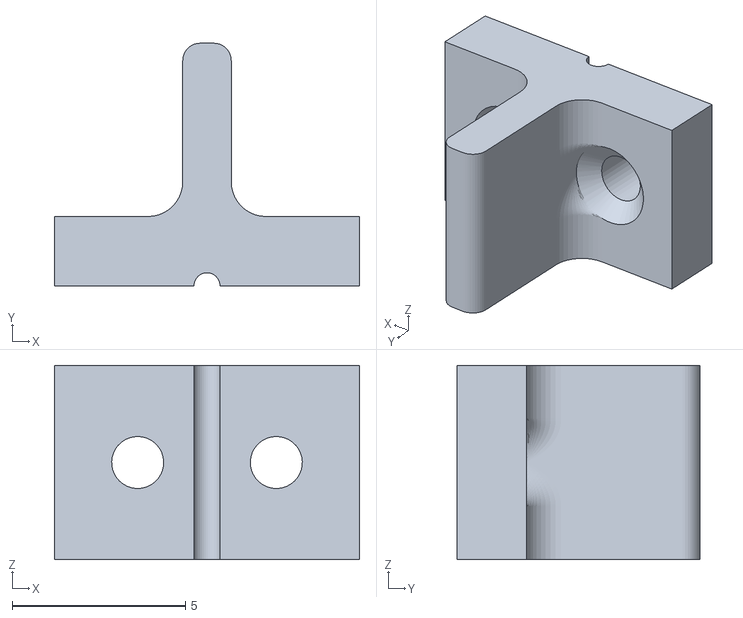
[picture p65: CAD file, 2026-07-26]
CAD/benchtop-prototype/_3d-prints/print 2026-07-26/carriage-cable-adapter.STL
8.80 x 7.00 x 5.60
