stephan-stansfield/cam-mech/CAD/benchtop-prototype/_3d-prints/print 2026-07-27/2/carriage-cable-adapter.STEP

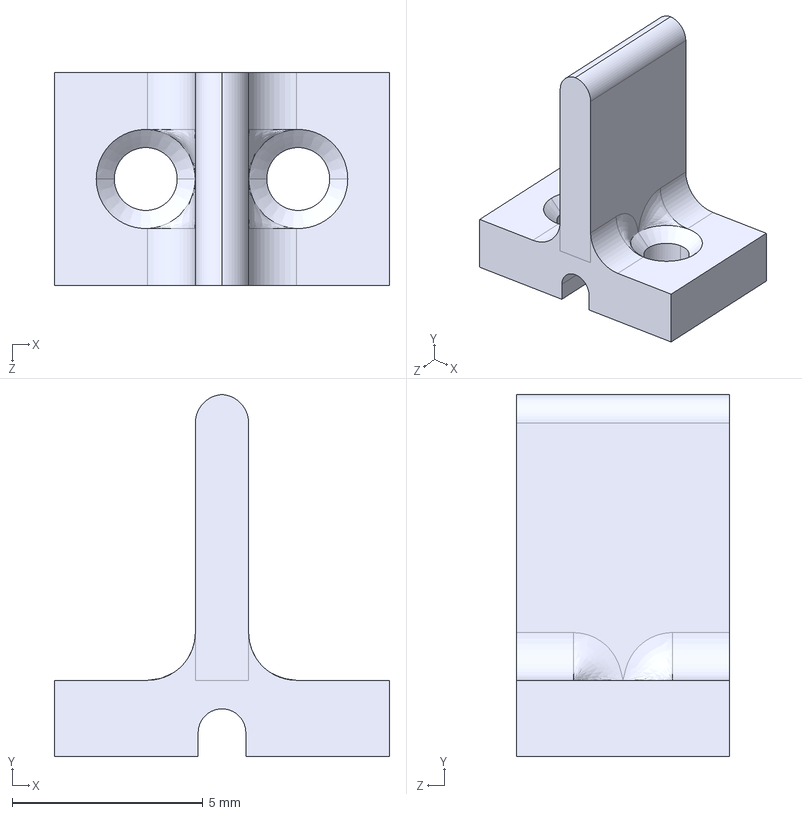
[picture p66: CAD file, 2026-07-27]
CAD/benchtop-prototype/_3d-prints/print 2026-07-27/2/carriage-cable-adapter.STEP
8.80 x 9.50 x 5.60 mm
