stephan-stansfield/cam-mech/CAD/benchtop-prototype/_3d-prints/print 2026-07-28/linear-rail-attachment-block.STEP

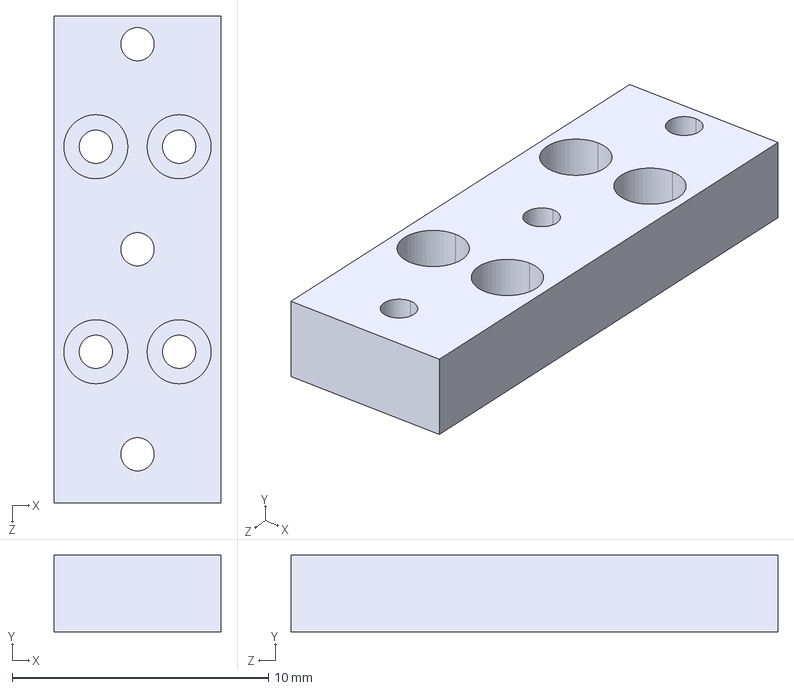
[picture p67: CAD file, 2026-09-21]
CAD/benchtop-prototype/_3d-prints/print 2026-07-28/linear-rail-attachment-block.STEP
6.50 x 3.00 x 19.0 mm
