stephan-stansfield/cam-mech/CAD/benchtop-prototype/_3d-prints/print 2026-10-13/detent-test-jig.STEP

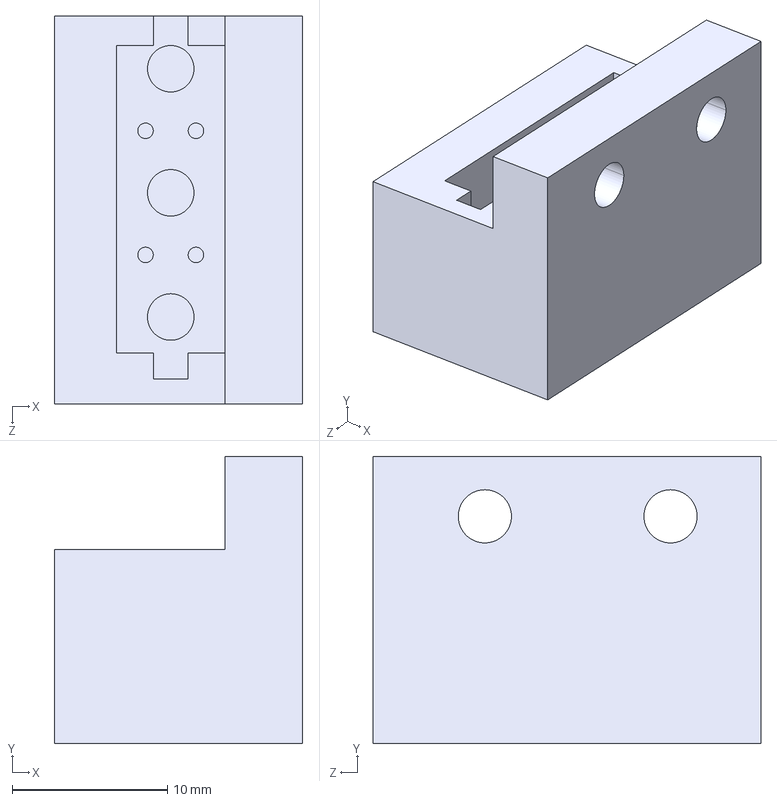
[picture p68: CAD file, 2026-10-13]
CAD/benchtop-prototype/_3d-prints/print 2026-10-13/detent-test-jig.STEP
16.0 x 18.5 x 25.0 mm
