stephan-stansfield/cam-mech/CAD/benchtop-prototype/_3d-prints/print 2026-10-19/detent-test-jig-8-32.STEP

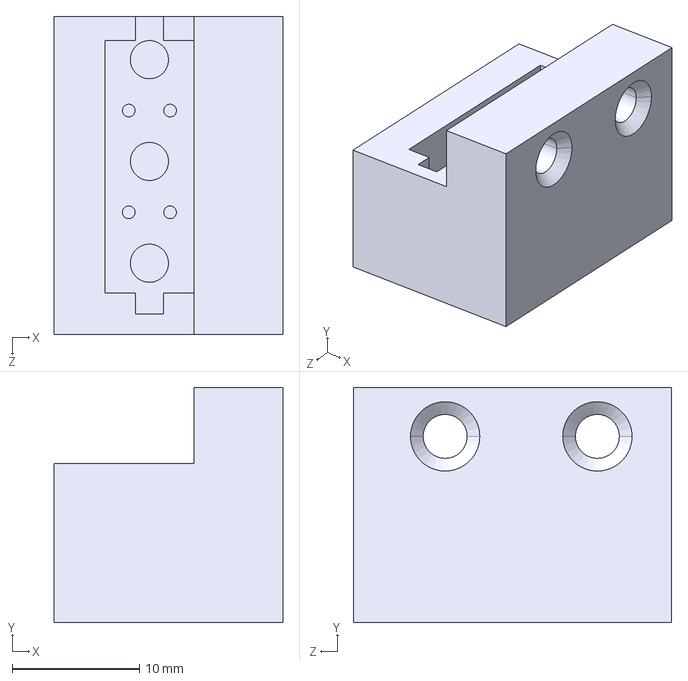
[picture p69: CAD file, 2026-10-19]
CAD/benchtop-prototype/_3d-prints/print 2026-10-19/detent-test-jig-8-32.STEP
18.0 x 18.5 x 25.0 mm
