stephan-stansfield/cam-mech/CAD/bistable-switch-scaled/_3d prints/print 2023-09-07/switch-toggle.STL

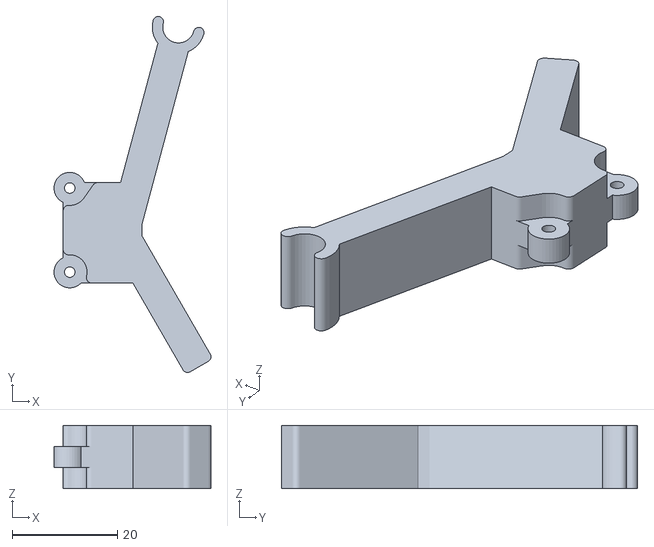
[picture p70: CAD file, 2023-11-07]
CAD/bistable-switch-scaled/_3d prints/print 2023-09-07/switch-toggle.STL
29.9 x 67.8 x 12.0
