stephan-stansfield/cam-mech/CAD/bistable-switch-scaled/_3d prints/print 2023-09-12/switch-base.STL

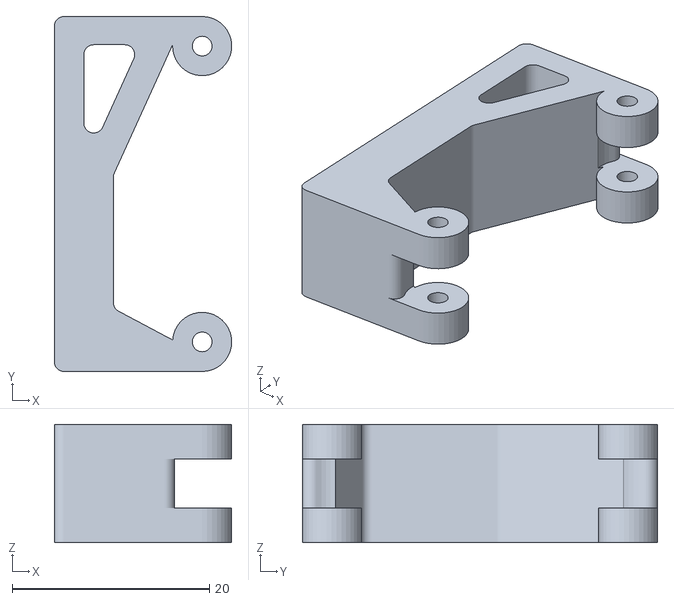
[picture p71: CAD file, 2023-11-07]
CAD/bistable-switch-scaled/_3d prints/print 2023-09-12/switch-base.STL
18.0 x 36.0 x 12.0
