stephan-stansfield/cam-mech/CAD/bistable-switch-scaled/_3d prints/print 2023-11-13/switch-base.STL

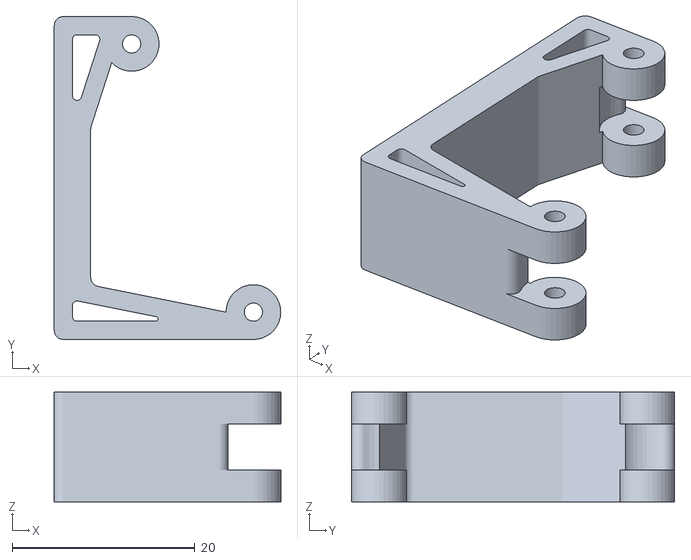
[picture p72: CAD file, 2023-11-13]
CAD/bistable-switch-scaled/_3d prints/print 2023-11-13/switch-base.STL
24.8 x 35.4 x 12.0
