stephan-stansfield/cam-mech/CAD/bistable-switch-scaled/_3d prints/print 2023-11-16/switch-hinge_1.STL

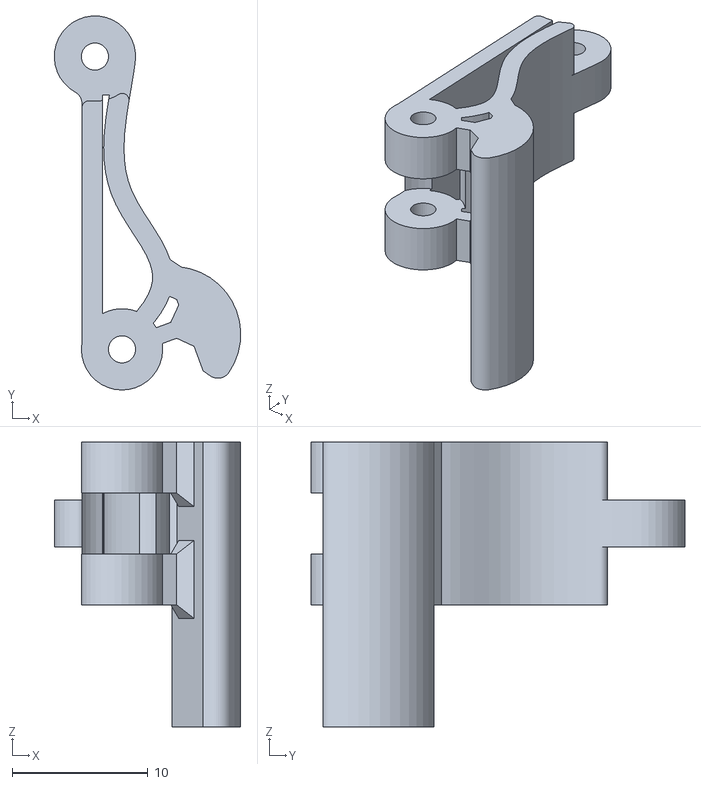
[picture p73: CAD file, 2023-12-01]
CAD/bistable-switch-scaled/_3d prints/print 2023-11-16/switch-hinge_1.STL
13.8 x 27.6 x 21.0
