stephan-stansfield/cam-mech/CAD/bistable-switch-scaled/_3d prints/print 2023-12-05/switch-base.STL

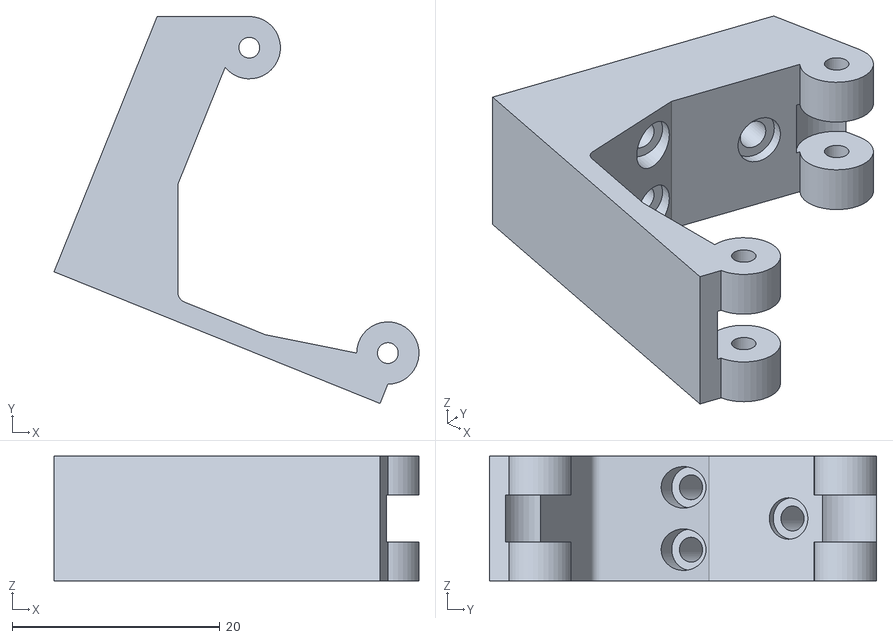
[picture p74: CAD file, 2023-12-05]
CAD/bistable-switch-scaled/_3d prints/print 2023-12-05/switch-base.STL
35.1 x 37.2 x 12.0
