stephan-stansfield/cam-mech/CAD/bistable-switch-scaled/_3d prints/print 2024-01-18/cam_bistable_proto.STL

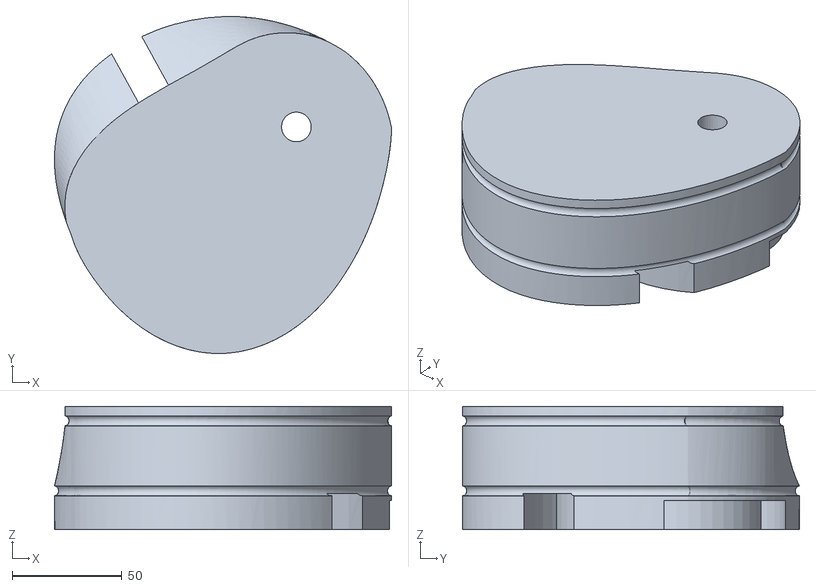
[picture p75: CAD file, 2024-01-18]
CAD/bistable-switch-scaled/_3d prints/print 2024-01-18/cam_bistable_proto.STL
153.7 x 153.6 x 56.1
