stephan-stansfield/cam-mech/CAD/bistable-switch-scaled/_3d prints/print 2024-01-30/derailleur.STL

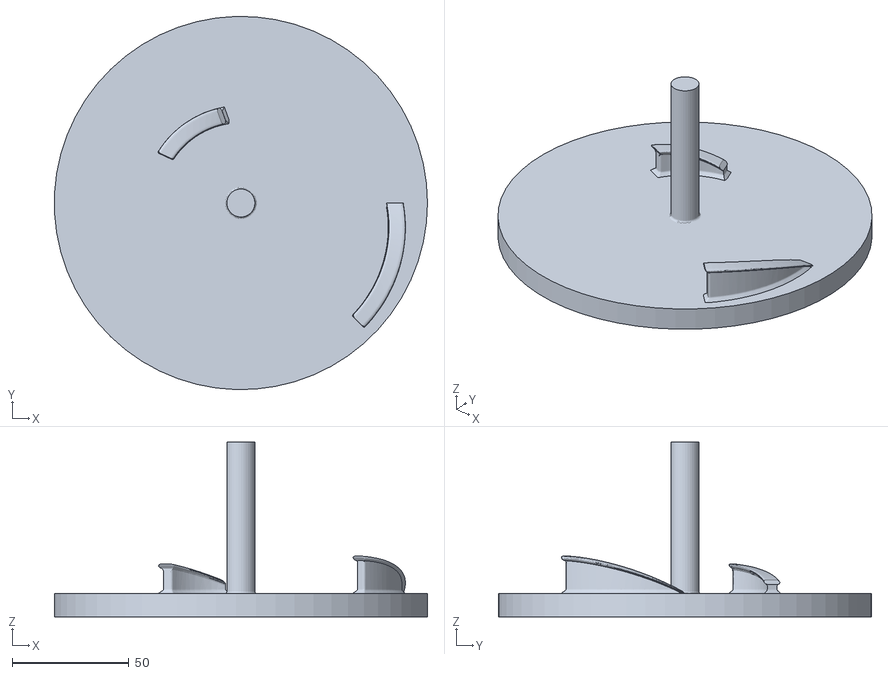
[picture p76: CAD file, 2024-01-31]
CAD/bistable-switch-scaled/_3d prints/print 2024-01-30/derailleur.STL
159.9 x 159.9 x 75.0
