stephan-stansfield/cam-mech/CAD/bistable-switch/_3d prints/print 2024-02-28/switch-flexures.SLDPRT

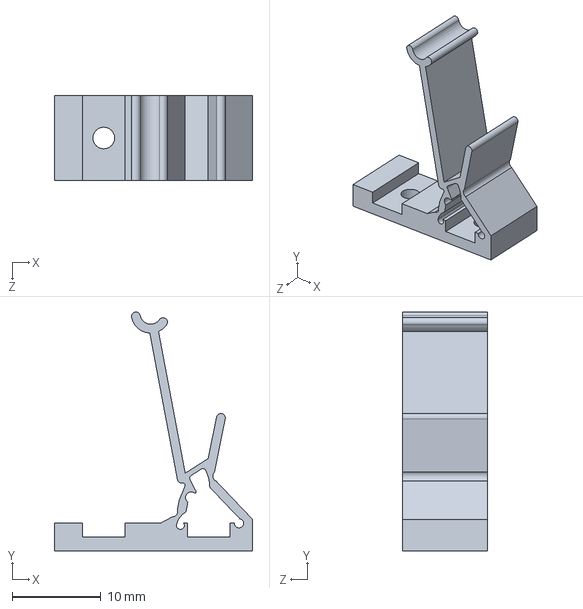
[picture p77: CAD file, 2024-02-29]
CAD/bistable-switch/_3d prints/print 2024-02-28/switch-flexures.SLDPRT
22.3 x 26.9 x 9.53 mm
