stephan-stansfield/cam-mech/CAD/bistable-switch/_3d prints/print 2024-03-01/switch-flexures.STL

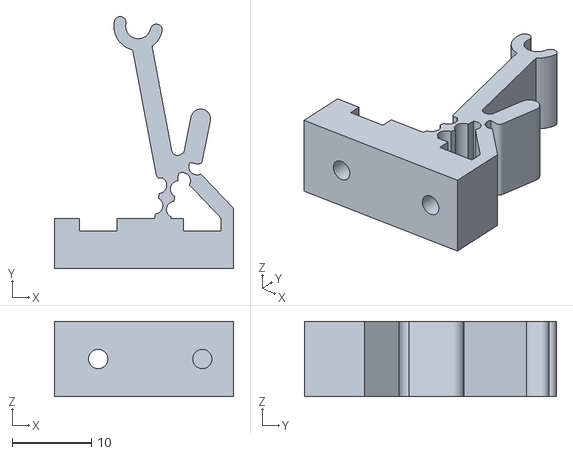
[picture p78: CAD file, 2024-03-01]
CAD/bistable-switch/_3d prints/print 2024-03-01/switch-flexures.STL
22.7 x 31.9 x 9.53
