stephan-stansfield/cam-mech/CAD/Cam Mechanism CAD 12-2022/first_prototype/pull_handle.SLDPRT

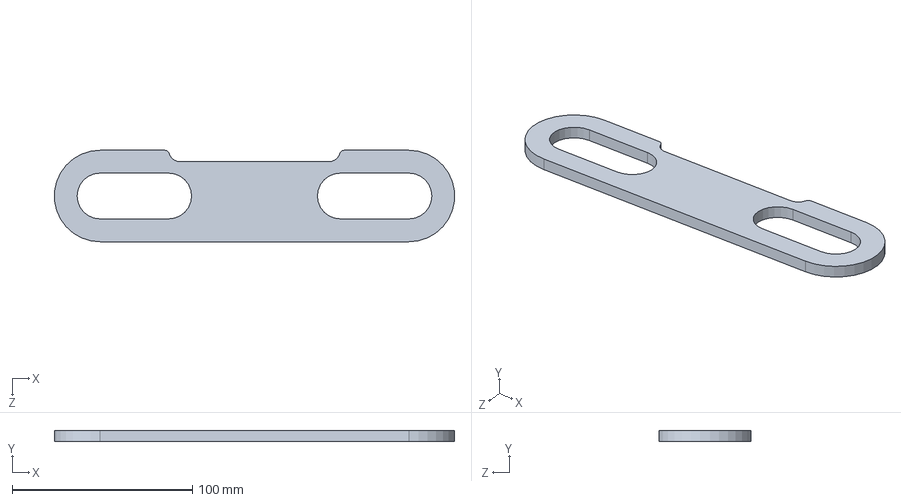
[picture p79: CAD file, 2023-07-26]
CAD/Cam Mechanism CAD 12-2022/first_prototype/pull_handle.SLDPRT
222.0 x 6.35 x 50.8 mm
