stephan-stansfield/cam-mech/CAD/Cam Mechanism CAD 12-2022/inner_cam.SLDPRT

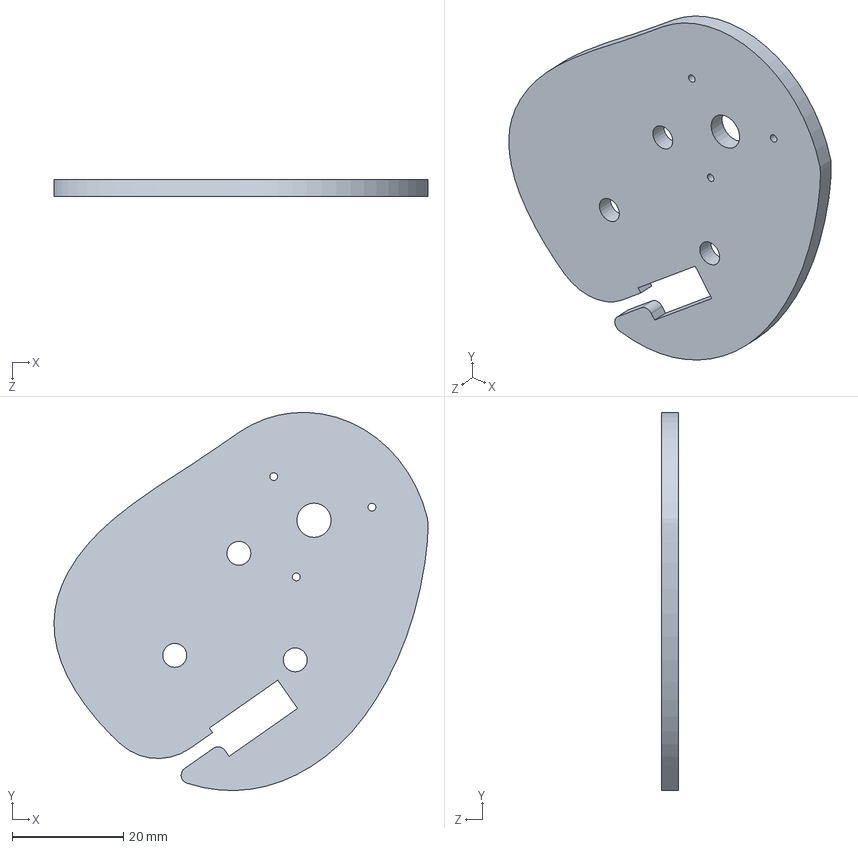
[picture p80: CAD file, 2023-08-03]
CAD/Cam Mechanism CAD 12-2022/inner_cam.SLDPRT
67.2 x 67.9 x 3.00 mm
