stephan-stansfield/cam-mech/CAD/Cam Mechanism CAD 12-2022/prototyping/idler_pulley_blank.SLDPRT

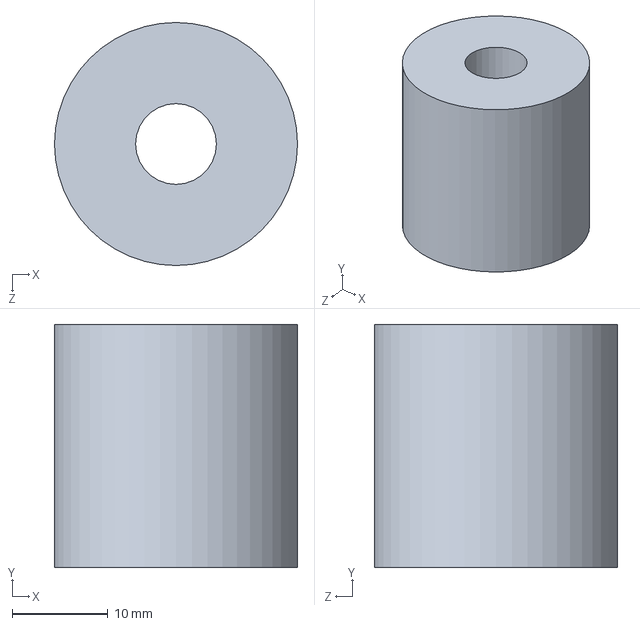
[picture p81: CAD file, 2023-11-07]
CAD/Cam Mechanism CAD 12-2022/prototyping/idler_pulley_blank.SLDPRT
25.4 x 25.4 x 25.4 mm
