stephan-stansfield/cam-mech/CAD/reference CAD/hinged-bistable-axles-instructables/stepv2.stl

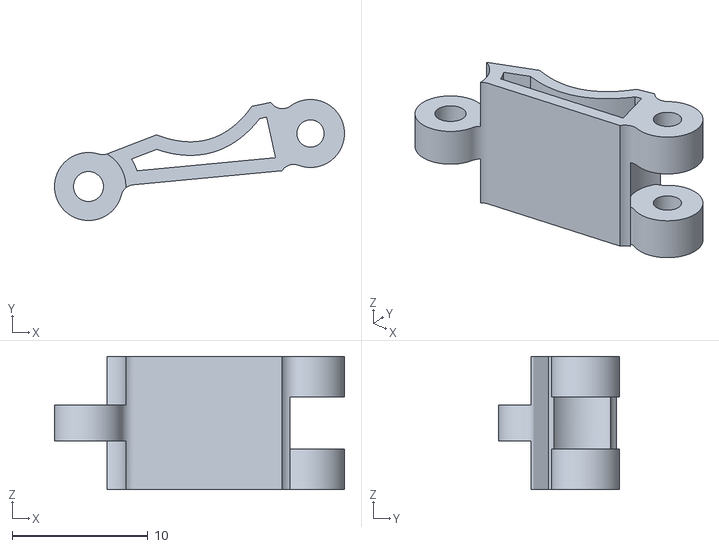
[picture p82: CAD file, 2023-11-07]
CAD/reference CAD/hinged-bistable-axles-instructables/stepv2.stl
21.3 x 8.90 x 9.80
