stephan-stansfield/cam-mech/CAD/reference CAD/hinged-bistable-flexures-instructables/Bistable_Switch.STL

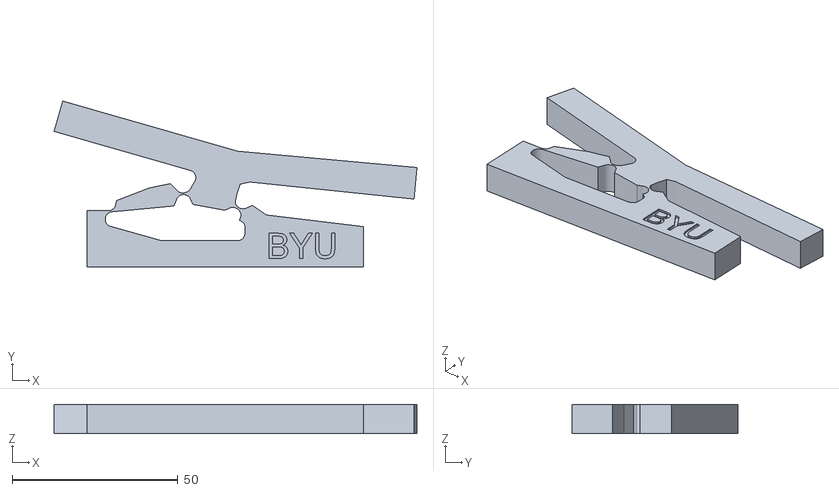
[picture p83: CAD file, 2024-02-22]
CAD/reference CAD/hinged-bistable-flexures-instructables/Bistable_Switch.STL
109.5 x 50.0 x 8.89
