stephan-stansfield/cam-mech/CAD/benchtop-prototype/_3d-prints/print 2024-08-01/switch-flexures.STEP

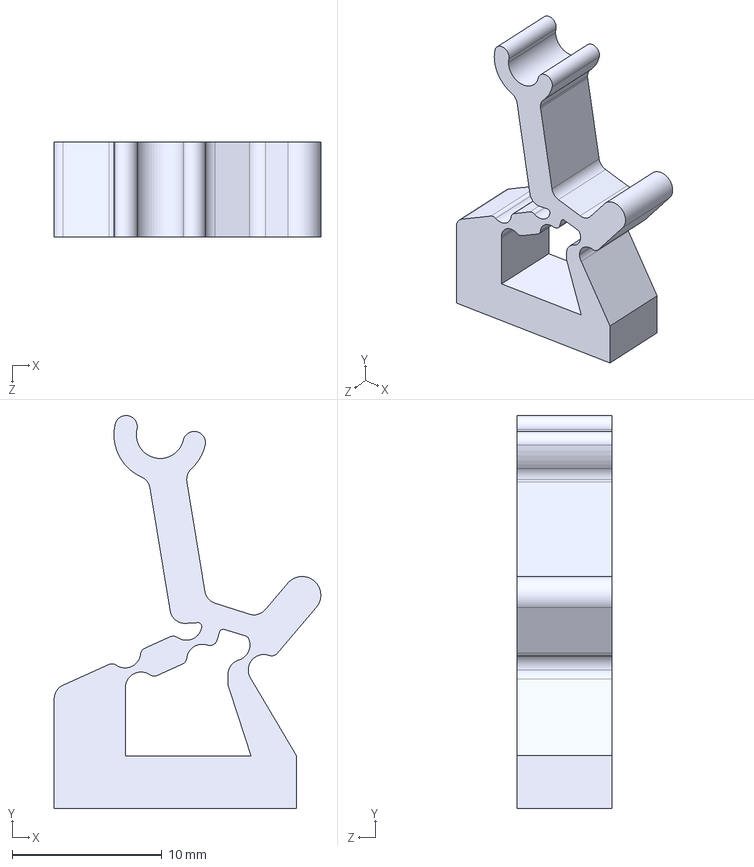
[picture p84: CAD file, 2024-08-21]
CAD/benchtop-prototype/_3d-prints/print 2024-08-01/switch-flexures.STEP
17.8 x 26.2 x 6.35 mm
