stephan-stansfield/cam-mech/CAD/benchtop-prototype/_3d-prints/print 2024-11-22/switch-flexures_0-25in-thick_0-65mm-flex.STEP

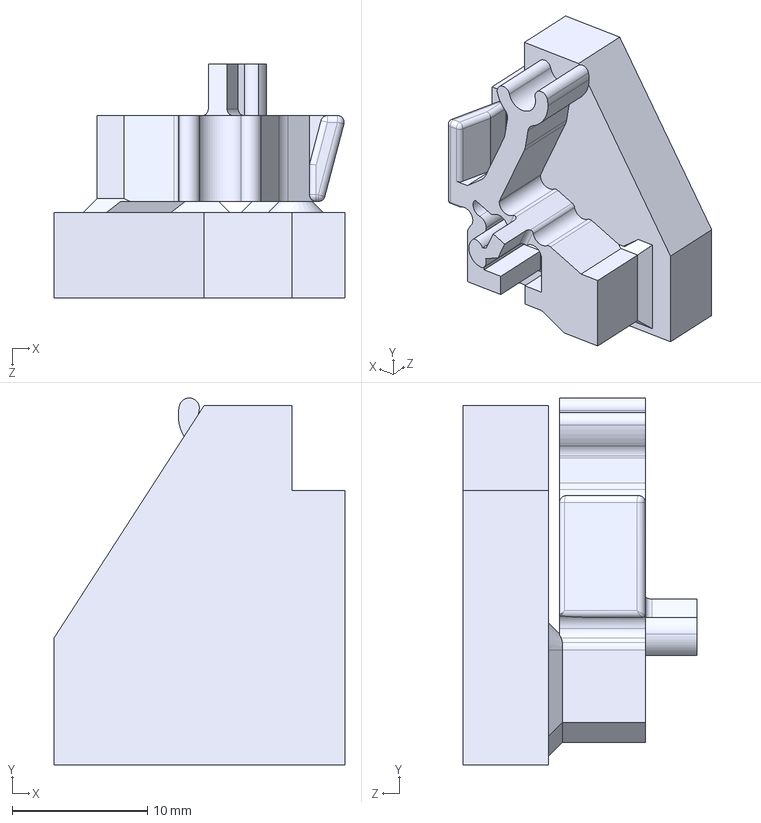
[picture p85: CAD file, 2025-10-06]
CAD/benchtop-prototype/_3d-prints/print 2024-11-22/switch-flexures_0-25in-thick_0-65mm-flex.STEP
21.5 x 27.1 x 17.3 mm
