stephan-stansfield/cam-mech/CAD/benchtop-prototype/_3d-prints/print 2025-10-03/switch-flexures-separate.STEP

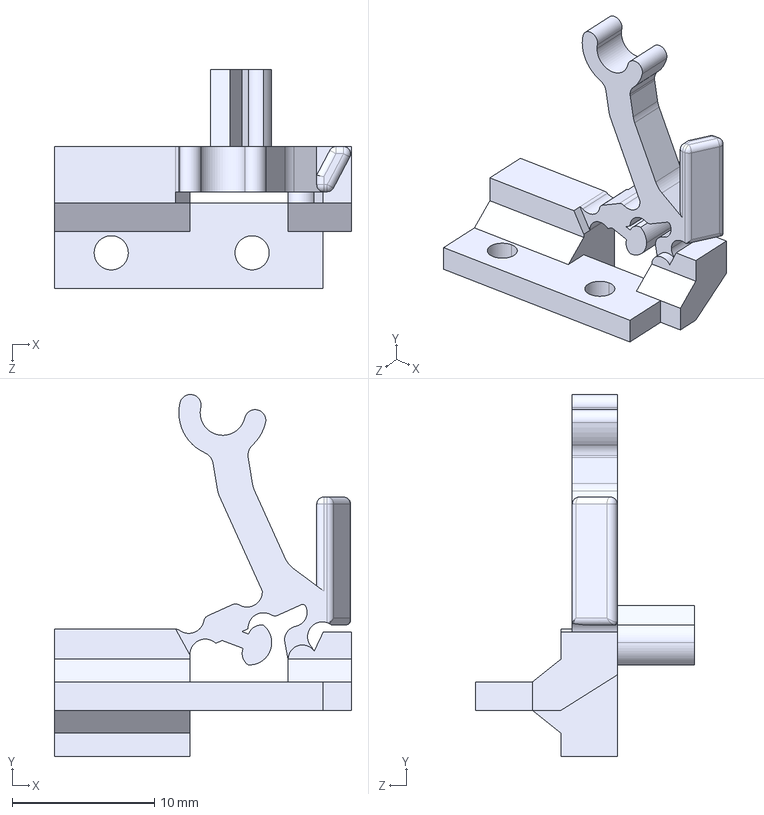
[picture p86: CAD file, 2025-10-06]
CAD/benchtop-prototype/_3d-prints/print 2025-10-03/switch-flexures-separate.STEP
20.9 x 25.5 x 15.4 mm
