stephan-stansfield/cam-mech/CAD/benchtop-prototype/_3d-prints/print 2025-10-14/switch-flexures-separate_v2_one-piece.STEP

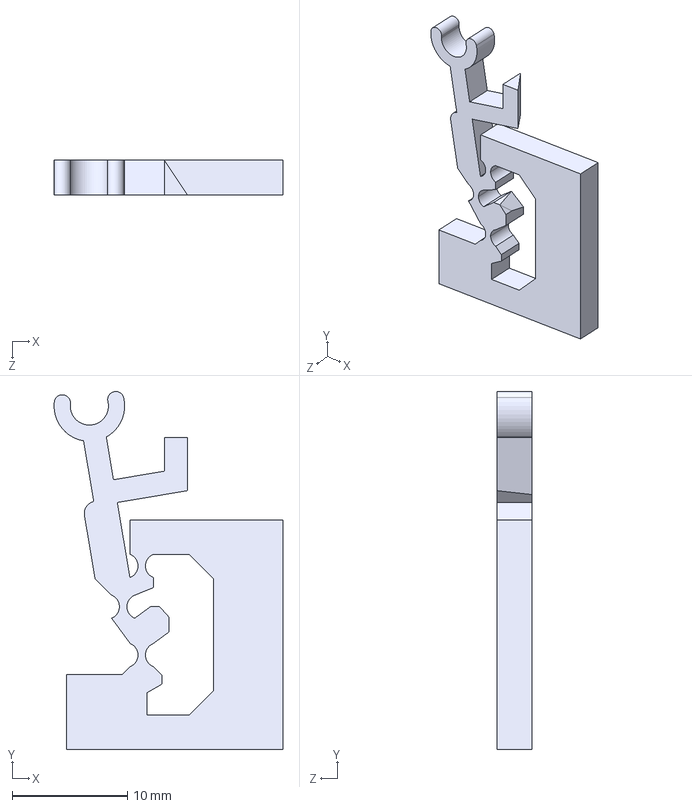
[picture p87: CAD file, 2025-10-17]
CAD/benchtop-prototype/_3d-prints/print 2025-10-14/switch-flexures-separate_v2_one-piece.STEP
19.8 x 31.1 x 3.00 mm
