stephan-stansfield/cam-mech/CAD/benchtop-prototype/asm-detent-test-jig.SLDASM

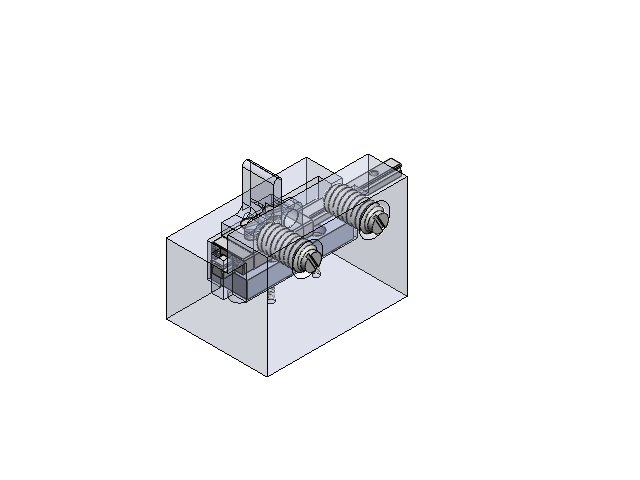
[picture p89: CAD file, 2026-10-28]
CAD/benchtop-prototype/asm-detent-test-jig.SLDASM
detent-test-jig
linear-rail-attachment-block
91800A057_18-8 Stainless Steel Cheese Head Slotted Screw x 7
8381K29_Miniature Ball Bearing Carriage and Guide Rail
carriage-cable-adapter-detent
91430A155_18-8 Stainless Steel Slotted Flat Head Screw x 2
3408A129_Slotted Spring Plunger with 440C Stainless Steel Ball-Nose x 2
