stephan-stansfield/cam-mech/CAD/benchtop-prototype/asm-cams-manual-switching.SLDASM

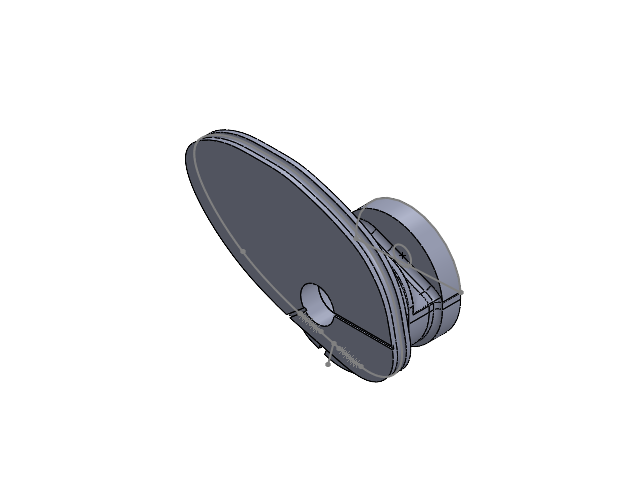
[picture p90: CAD file, 2026-10-19]
CAD/benchtop-prototype/asm-cams-manual-switching.SLDASM
cam-transmission-manual-switching
cam-storage
