stephan-stansfield/cam-mech/CAD/bistable-switch-scaled/asm_switch.SLDASM

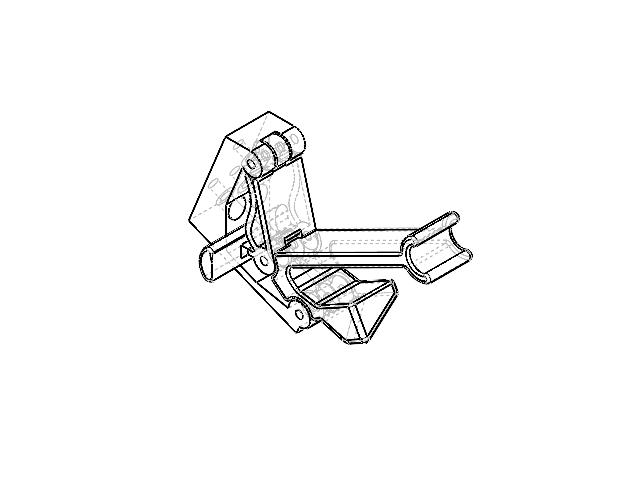
[picture p91: CAD file, 2025-10-06]
CAD/bistable-switch-scaled/asm_switch.SLDASM
switch-base
switch-hinge
switch-toggle
