stephan-stansfield/cam-mech/CAD/bistable-switch/asm_cam-and-derailleur.SLDASM

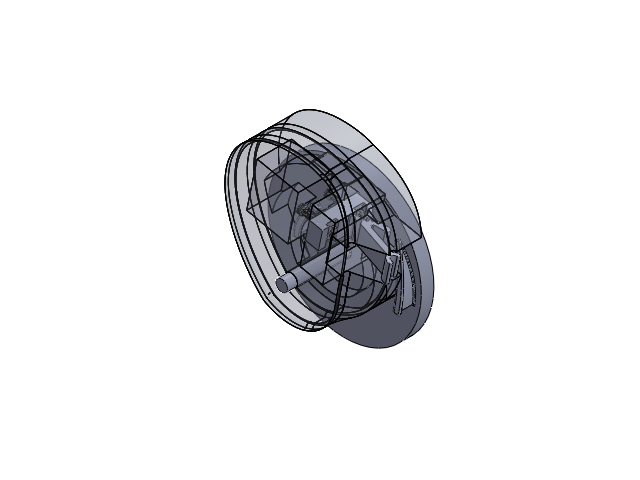
[picture p92: CAD file, 2024-09-27]
CAD/bistable-switch/asm_cam-and-derailleur.SLDASM
derailleur
cam_bistable_proto
switch-flexures
90480A003_Low-Strength Steel Hex Nut x 2
91251A081_Black-Oxide Alloy Steel Socket Head Screw x 2
