stephan-stansfield/cam-mech/CAD/benchtop-prototype/asm-benchtop-device-manual-switching.SLDASM

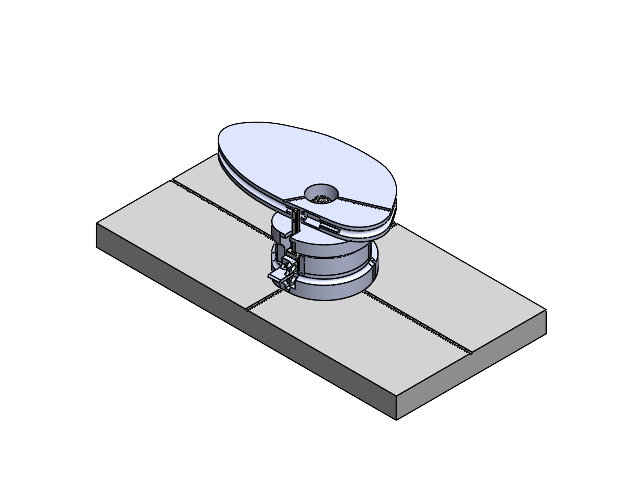
[picture p93: CAD file, 2026-10-19]
CAD/benchtop-prototype/asm-benchtop-device-manual-switching.SLDASM
derailleur-jig-no-switching
57155K346_Stainless Steel Ball Bearing x 2
cam-transmission-manual-switching
cam-storage
Part1^asm-benchtop-device-manual-switching
91831A005_18-8 Stainless Steel Nylon-Insert Locknut
6655K11_Thrust Ball Bearing x 2
97832A190_18-8 Stainless Steel Shoulder Screw
linear-rail-attachment-block
91800A057_18-8 Stainless Steel Cheese Head Slotted Screw x 7
8381K29_Miniature Ball Bearing Carriage and Guide Rail
carriage-cable-adapter-detent
91430A155_18-8 Stainless Steel Slotted Flat Head Screw x 2
