stephan-stansfield/cam-mech/CAD/bistable-switch-scaled/asm_cam-and-derailleur.SLDASM

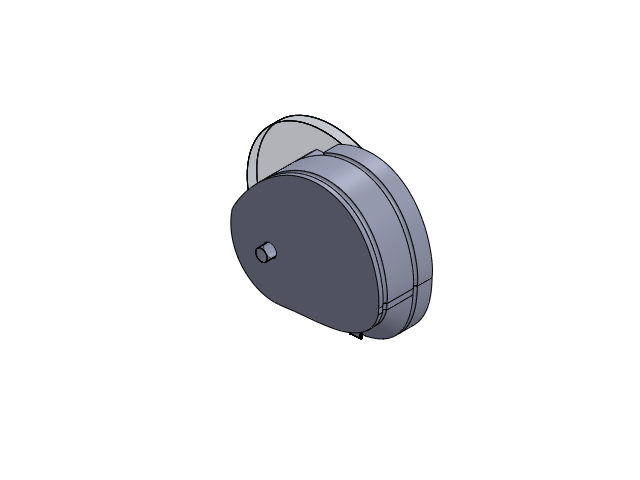
[picture p94: CAD file, 2024-01-30]
CAD/bistable-switch-scaled/asm_cam-and-derailleur.SLDASM
derailleur
cam_bistable_proto
switch-base
switch-hinge
switch-toggle
90480A003_Low-Strength Steel Hex Nut
91251A081_Black-Oxide Alloy Steel Socket Head Screw
