stephan-stansfield/cam-mech/CAD/benchtop-prototype/asm-linear-slider.SLDASM

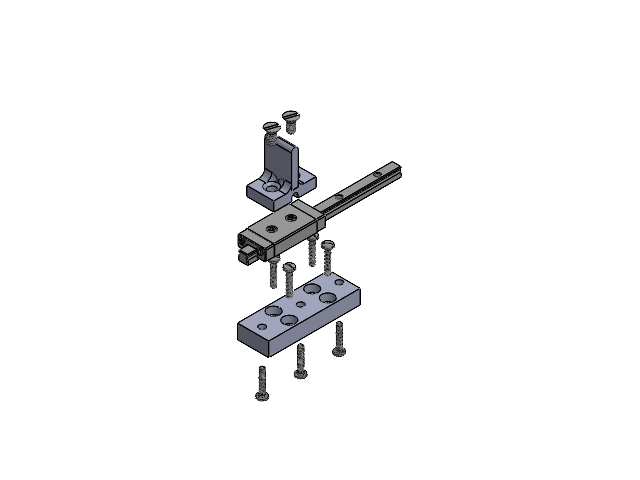
[picture p95: CAD file, 2026-10-13]
CAD/benchtop-prototype/asm-linear-slider.SLDASM
linear-rail-attachment-block
91800A057_18-8 Stainless Steel Cheese Head Slotted Screw x 7
8381K29_Miniature Ball Bearing Carriage and Guide Rail
carriage-cable-adapter-detent
91430A155_18-8 Stainless Steel Slotted Flat Head Screw x 2
