stephan-stansfield/cam-mech/CAD/bistable-switch/asm_switch.SLDASM

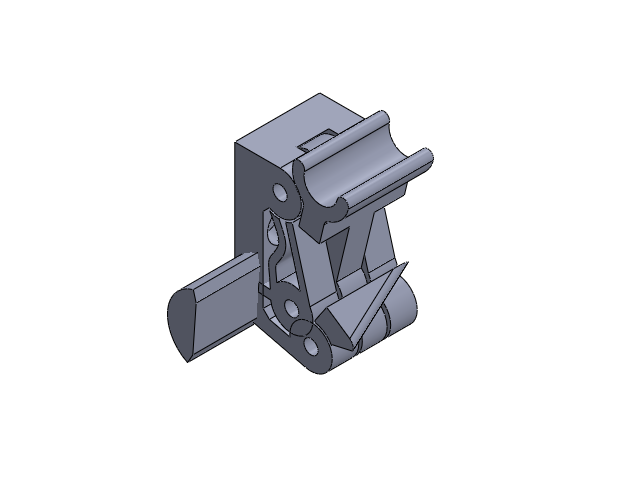
[picture p96: CAD file, 2024-02-22]
CAD/bistable-switch/asm_switch.SLDASM
switch-base
switch-hinge
switch-toggle
