stephan-stansfield/cam-mech/CAD/benchtop-prototype/linear-rail-assembly.SLDASM

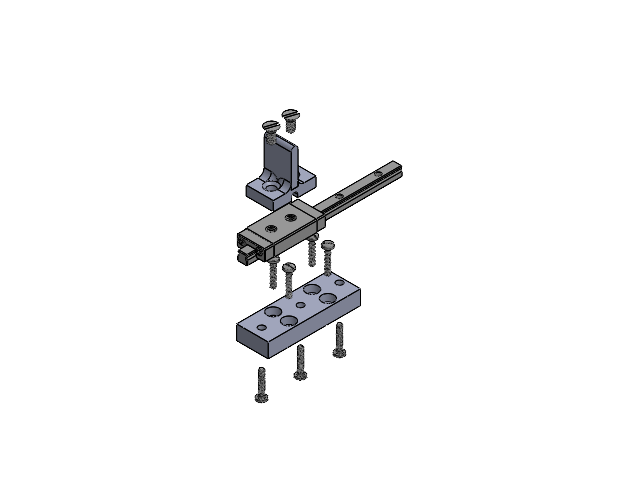
[picture p97: CAD file, 2026-09-21]
CAD/benchtop-prototype/linear-rail-assembly.SLDASM
linear-rail-attachment-block
91800A057_18-8 Stainless Steel Cheese Head Slotted Screw x 7
8381K29_Miniature Ball Bearing Carriage and Guide Rail
carriage-cable-adapter
91430A155_18-8 Stainless Steel Slotted Flat Head Screw x 2
