stephan-stansfield/cam-mech/CAD/bistable-switch/asm_derailleur-prototype.SLDASM

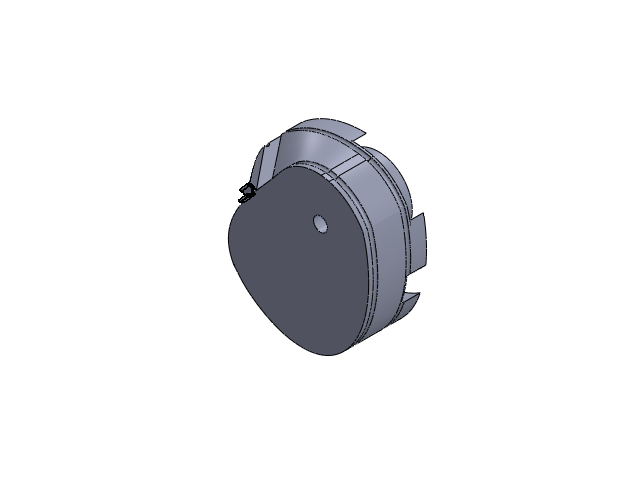
[picture p98: CAD file, 2024-01-17]
CAD/bistable-switch/asm_derailleur-prototype.SLDASM
cam_bistable_proto
switch-hinge
switch-toggle
switch-base
