stephan-stansfield/cam-mech/CAD/benchtop-prototype/asm-cams.SLDASM

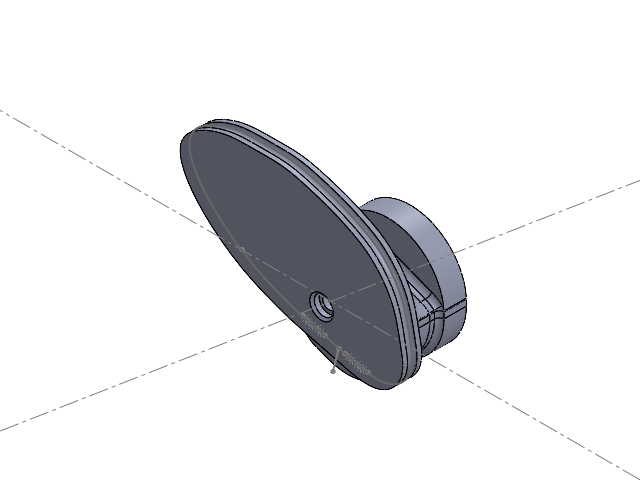
[picture p99: CAD file, 2026-07-26]
CAD/benchtop-prototype/asm-cams.SLDASM
cam-transmission-no-switching
cam-storage
