stephan-stansfield/cam-mech/CAD/bistable-switch/asm_cam_switch.SLDASM

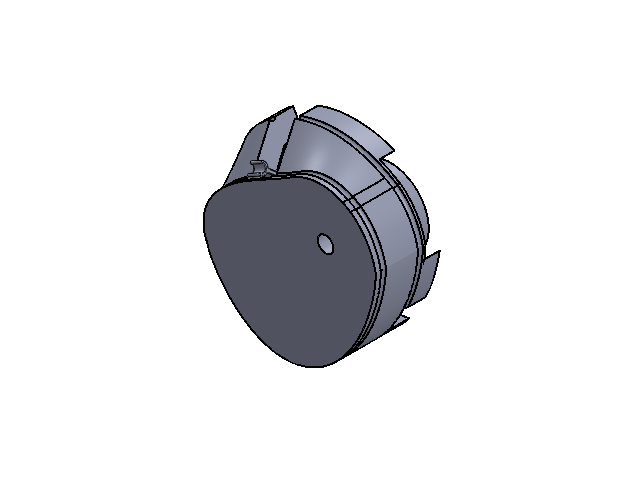
[picture p100: CAD file, 2024-01-17]
CAD/bistable-switch/asm_cam_switch.SLDASM
cam_bistable_proto
switch-base
switch-hinge
switch-toggle
