stephan-stansfield/cam-mech/CAD/benchtop-prototype/asm-benchtop-device.SLDASM

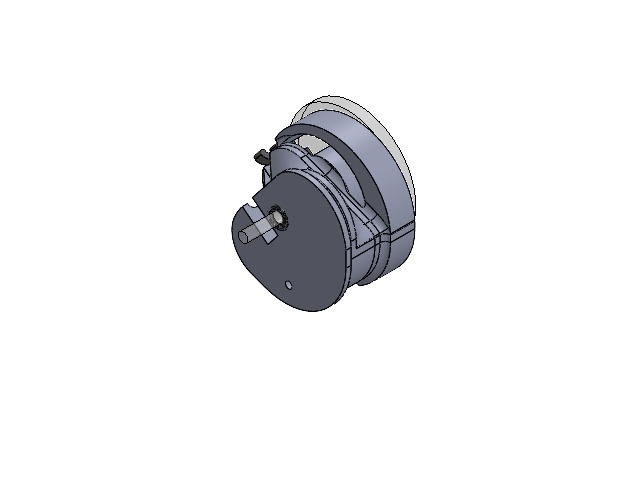
[picture p101: CAD file, 2025-12-18]
CAD/benchtop-prototype/asm-benchtop-device.SLDASM
cam-transmission
derailleur
57155K346_Stainless Steel Ball Bearing x 2
switch-extended-mechanism-1_0mm
socket head cap screw_am x 2
