stephan-stansfield/cam-mech/CAD/benchtop-prototype/asm-derailleur-jig.SLDASM

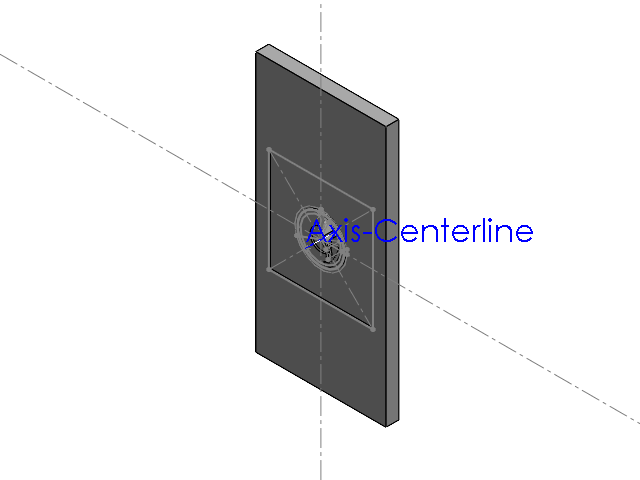
[picture p102: CAD file, 2025-12-18]
CAD/benchtop-prototype/asm-derailleur-jig.SLDASM
derailleur-jig-separate
derailleur-separate
