stephan-stansfield/cam-mech/(list of files, cad)

Other CAD files:
CAD/benchtop-prototype/_3d-prints/print 2025-12-14/asm-cams.STEP
CAD/benchtop-prototype/_3d-prints/print 2026-07-28/Part1^asm-cams-manual-switching.STEP
CAD/benchtop-prototype/_3d-prints/print 2025-10-21/cams-joined^asm-cams.STEP
CAD/benchtop-prototype/cams-joined^asm-cams-no-switching.SLDPRT
CAD/benchtop-prototype/asm-cams-no-switching.SLDASM
CAD/benchtop-prototype/_3d-prints/print 2024-11-22/switch-flexures_0-125in-thick_0-65mm-flex.STEP
CAD/benchtop-prototype/_3d-prints/print 2025-10-03/derailleur.STEP
CAD/benchtop-prototype/_3d-prints/print 2025-10-15/switch-flexures-separate_v2_one-piece-spring-link.STEP
CAD/benchtop-prototype/_3d-prints/print 2025-10-23/switch-one-hinge-angled.STEP
CAD/benchtop-prototype/_3d-prints/print 2025-10-25/2/switch.STEP
CAD/benchtop-prototype/_3d-prints/print 2025-10-25/3/switch-one-hinge-angled.STEP
CAD/benchtop-prototype/_3d-prints/print 2025-10-25/4/switch-one-hinge-up-one-down.STEP
CAD/benchtop-prototype/_3d-prints/print 2025-10-26/1/switch-wide-cantilever-long-hinge.STEP
CAD/benchtop-prototype/_3d-prints/print 2025-10-26/2/derailleur-wide.STEP
CAD/benchtop-prototype/_3d-prints/print 2025-10-26/3/switch-compliant-link-lowered.STEP
CAD/benchtop-prototype/_3d-prints/print 2025-10-26/5/switch-thin-hinges.STEP
CAD/benchtop-prototype/_3d-prints/print 2025-10-26/7/switch-low-thin-compliant-link.STEP
CAD/benchtop-prototype/_3d-prints/print 2025-11-05/2/switch-one-hinge-angled.STEP
CAD/benchtop-prototype/_3d-prints/print 2025-11-06/switch-one-hinge-angled-increase-angle.STEP
CAD/benchtop-prototype/_3d-prints/print 2025-11-14/2/switch-extended-mechanism.STEP
CAD/benchtop-prototype/_3d-prints/print 2025-11-16/switch-extended-mechanism-1_4mm.STEP
CAD/benchtop-prototype/_3d-prints/print 2025-11-17/2/derailleur.STEP
CAD/benchtop-prototype/_3d-prints/print 2025-11-19/1/derailleur.STEP
CAD/benchtop-prototype/_3d-prints/print 2025-11-19/3/switch-extended-mechanism-1_0mm.STEP
CAD/benchtop-prototype/_3d-prints/print 2025-12-10/switch-extended-mechanism-1_0mm.STEP
CAD/benchtop-prototype/_3d-prints/print 2025-12-13/1/derailleur-separate.STEP
CAD/benchtop-prototype/_reference/cam_transmission_curve_si2st_augmented.SLDPRT
CAD/benchtop-prototype/drawings/derailleur-jig.STEP
CAD/bistable-switch-scaled/_3d prints/print 2023-11-17/switch-hinge.STL
CAD/bistable-switch-scaled/switch-hinge.SLDPRT
CAD/bistable-switch/_3d prints/print 2024-02-29/switch-flexures.STL
CAD/bistable-switch/switch-flexures.SLDPRT
CAD/benchtop-prototype/_3d-prints/print 2024-11-15/switch-flexures_0-125in-thick_0-85mm-flex.STEP
CAD/benchtop-prototype/_3d-prints/print 2024-11-22/batch 1/switch-flexures_0-125in-thick_0-65mm-flex.STEP
CAD/benchtop-prototype/_3d-prints/print 2025-10-01/cam_transmission.STEP
CAD/benchtop-prototype/_3d-prints/print 2025-10-08/derailleur_v2.STEP
CAD/benchtop-prototype/_3d-prints/print 2025-10-10/derailleur_v2.STEP
CAD/benchtop-prototype/_3d-prints/print 2025-10-20/switch.STEP
CAD/benchtop-prototype/_3d-prints/print 2025-10-21/switch.STEP
CAD/benchtop-prototype/_3d-prints/print 2025-10-23/switch-three-hinges-angled.STEP
CAD/benchtop-prototype/_3d-prints/print 2025-10-24/1/derailleur-jig.STEP
CAD/benchtop-prototype/_3d-prints/print 2025-10-25/1/switch.STEP
CAD/benchtop-prototype/_3d-prints/print 2025-10-25/2/derailleur.STEP
CAD/benchtop-prototype/_3d-prints/print 2025-10-25/3/switch.STEP
CAD/benchtop-prototype/_3d-prints/print 2025-10-25/5/switch-wide-cantilever.STEP
CAD/Cam Mechanism CAD 12-2022/57155K323_Stainless Steel Ball Bearing.SLDPRT
CAD/Cam Mechanism CAD 12-2022/8632T139_D-Profile Rotary Shaft.SLDPRT
CAD/Cam Mechanism CAD 12-2022/9414T6_Set Screw Shaft Collar.SLDPRT
CAD/Cam Mechanism CAD 12-2022/Mirrorinner_cam.SLDPRT
CAD/Cam Mechanism CAD 12-2022/Mirrorouter_cam.SLDPRT
CAD/Cam Mechanism CAD 12-2022/cam gear.SLDPRT
CAD/Cam Mechanism CAD 12-2022/cam_backing.SLDPRT
CAD/Cam Mechanism CAD 12-2022/first_prototype/Mirrorinner_cam.SLDPRT
CAD/Cam Mechanism CAD 12-2022/first_prototype/Mirrorinner_cam_cover.SLDPRT
CAD/Cam Mechanism CAD 12-2022/first_prototype/Mirrorouter_cam.SLDPRT
CAD/Cam Mechanism CAD 12-2022/first_prototype/Mirrorouter_cam_cover.SLDPRT
CAD/Cam Mechanism CAD 12-2022/first_prototype/cam_backing.SLDPRT
CAD/Cam Mechanism CAD 12-2022/first_prototype/elastic_band_between.SLDPRT
CAD/Cam Mechanism CAD 12-2022/first_prototype/inner_cam.SLDPRT
CAD/Cam Mechanism CAD 12-2022/first_prototype/inner_cam_cover.SLDPRT
CAD/Cam Mechanism CAD 12-2022/first_prototype/outer_cam.SLDPRT
CAD/Cam Mechanism CAD 12-2022/first_prototype/outer_cam_cover.SLDPRT
CAD/Cam Mechanism CAD 12-2022/first_prototype/outer_cam_cover_tapped.SLDPRT
CAD/Cam Mechanism CAD 12-2022/first_prototype/outer_cam_holes.SLDPRT
CAD/Cam Mechanism CAD 12-2022/inner_cam_cover.SLDPRT
CAD/Cam Mechanism CAD 12-2022/middle gear.SLDPRT
CAD/Cam Mechanism CAD 12-2022/nylon_spacer.SLDPRT
CAD/Cam Mechanism CAD 12-2022/nylon_spacer_back.SLDPRT
CAD/Cam Mechanism CAD 12-2022/nylon_spacer_front.SLDPRT
CAD/Cam Mechanism CAD 12-2022/outer_cam.SLDPRT
CAD/Cam Mechanism CAD 12-2022/outer_cam_back_cover.SLDPRT
CAD/Cam Mechanism CAD 12-2022/outer_cam_back_cover.STEP
CAD/Cam Mechanism CAD 12-2022/outer_cam_cover_clearance.SLDPRT
CAD/Cam Mechanism CAD 12-2022/outer_cam_front_cover.SLDPRT
CAD/Cam Mechanism CAD 12-2022/outer_cam_sandbox.SLDPRT
CAD/Cam Mechanism CAD 12-2022/outer_cam_sandbox_profile_2.SLDPRT
CAD/Cam Mechanism CAD 12-2022/prototyping/idler_pulley_blank.DXF
CAD/Cam Mechanism CAD 12-2022/prototyping/inner_cam_profile.DXF
CAD/Cam Mechanism CAD 12-2022/prototyping/inner_cam_profile.SLDPRT
CAD/Cam Mechanism CAD 12-2022/prototyping/inner_cam_profile_2.DXF
CAD/Cam Mechanism CAD 12-2022/prototyping/inner_cam_profile_2.SLDPRT
CAD/Cam Mechanism CAD 12-2022/prototyping/inner_cam_profile_2023-08-09.DXF
CAD/Cam Mechanism CAD 12-2022/prototyping/inner_cam_profile_2023-08-09.SLDPRT
CAD/_superseded/Cam Mechanism CAD 12-2022/57155K323_Stainless Steel Ball Bearing.SLDPRT
CAD/_superseded/Cam Mechanism CAD 12-2022/8632T139_D-Profile Rotary Shaft.SLDPRT
CAD/_superseded/Cam Mechanism CAD 12-2022/9414T6_Set Screw Shaft Collar.SLDPRT
CAD/_superseded/Cam Mechanism CAD 12-2022/Mirrorinner_cam.SLDPRT
CAD/_superseded/Cam Mechanism CAD 12-2022/Mirrorouter_cam.SLDPRT
CAD/_superseded/Cam Mechanism CAD 12-2022/cam gear.SLDPRT
CAD/_superseded/Cam Mechanism CAD 12-2022/cam_backing.SLDPRT
CAD/_superseded/Cam Mechanism CAD 12-2022/first_prototype/Mirrorinner_cam.SLDPRT
CAD/_superseded/Cam Mechanism CAD 12-2022/first_prototype/Mirrorinner_cam_cover.SLDPRT
CAD/_superseded/Cam Mechanism CAD 12-2022/first_prototype/Mirrorouter_cam.SLDPRT
CAD/_superseded/Cam Mechanism CAD 12-2022/first_prototype/Mirrorouter_cam_cover.SLDPRT
CAD/_superseded/Cam Mechanism CAD 12-2022/first_prototype/cam_backing.SLDPRT
CAD/_superseded/Cam Mechanism CAD 12-2022/first_prototype/elastic_band_between.SLDPRT
CAD/_superseded/Cam Mechanism CAD 12-2022/first_prototype/inner_cam.SLDPRT
CAD/_superseded/Cam Mechanism CAD 12-2022/first_prototype/inner_cam_cover.SLDPRT
CAD/_superseded/Cam Mechanism CAD 12-2022/first_prototype/outer_cam.SLDPRT
CAD/_superseded/Cam Mechanism CAD 12-2022/first_prototype/outer_cam_cover.SLDPRT
CAD/_superseded/Cam Mechanism CAD 12-2022/first_prototype/outer_cam_cover_tapped.SLDPRT
CAD/_superseded/Cam Mechanism CAD 12-2022/first_prototype/outer_cam_holes.SLDPRT
CAD/_superseded/Cam Mechanism CAD 12-2022/inner_cam_cover.SLDPRT
CAD/_superseded/Cam Mechanism CAD 12-2022/inner_cam_profile.SLDPRT
CAD/_superseded/Cam Mechanism CAD 12-2022/middle gear.SLDPRT
CAD/_superseded/Cam Mechanism CAD 12-2022/nylon_spacer.SLDPRT
CAD/_superseded/Cam Mechanism CAD 12-2022/nylon_spacer_back.SLDPRT
CAD/_superseded/Cam Mechanism CAD 12-2022/nylon_spacer_front.SLDPRT
CAD/_superseded/Cam Mechanism CAD 12-2022/older_versions/57155K323_Stainless Steel Ball Bearing.SLDPRT
CAD/_superseded/Cam Mechanism CAD 12-2022/older_versions/8632T139_D-Profile Rotary Shaft.SLDPRT
CAD/_superseded/Cam Mechanism CAD 12-2022/older_versions/9414T6_Set Screw Shaft Collar.SLDPRT
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
