stephan-stansfield/cam-mech/results/cams/cams_2026-09-03/_force_output63.csv

# Angles (rad) | Stance Percentage (%) | Transmission Cable Displacement (m) | Transmission Cable Force (N) | Storage Cable Force (N) | Scaled Transmission Cable Displacement (cm) | Scaled Transmission Cable Force (N) | Scaled Storage Cable Force (N)
0.000000000000000000e+00 | 1.000000000000000000e+02 | 4.999592370155310495e-02 | 5.962517159336723493e-02 | 4.664710827677630289e-02 | 5.031329341317365006e-02 | -3.805694319861908623e-06 | -2.976062950976195138e-06
1.745329251994329547e-02 | 9.954337899543378398e+01 | 4.968198694458948045e-02 | 1.189700745898326362e-01 | 9.316009466213083512e-02 | 5.030424979726789980e-02 | 1.690048365677571975e-03 | 1.321626482506570730e-03
3.490658503988659095e-02 | 9.908675799086756797e+01 | 4.937162040622667530e-02 | 1.780110405234422433e-01 | 1.395514494837998831e-01 | 5.027098456719000102e-02 | 7.923351387956700104e-03 | 6.196205514027945845e-03
5.235987755982988295e-02 | 9.863013698630136616e+01 | 4.906496261219692179e-02 | 2.367581821144910670e-01 | 1.858337982727846505e-01 | 5.021526277489678225e-02 | 1.837425304074282589e-02 | 1.436965323914617121e-02
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
