stephan-stansfield/cam-mech/results/force_plots/force_plots_2024-06-13_K=100/_force_output.xlsx

# angles(rad) | pulling distance(m) | elastic band force(n) | cable force(n)
0.000000000000000000e+00 3.663033324352524549e-04 9.578743236393924554e-02 1.252409053703878727e-01
1.745329251994329547e-02 7.328901031820193911e-04 1.916994595094205223e-01 2.507766950616804325e-01
3.490658503988659095e-02 1.099710171667404738e-03 2.877650855572823074e-01 3.768105329258756853e-01
5.235987755982988295e-02 1.466713397318511990e-03 3.840141686889488315e-01 5.035515911380237242e-01
6.981317007977318190e-02 1.833821245881564910e-03 4.804768506317623200e-01 6.312598028725586730e-01
8.726646259971647390e-02 2.200996793839085381e-03 5.771836048771494809e-01 7.600935484649814500e-01
1.047197551196597659e-01 2.568200294214932015e-03 6.741652861698806953e-01 8.902649737138894626e-01
1.221730476396030718e-01 2.935389176574303410e-03 7.714531814677350052e-01 1.021995217605397244e+00
1.396263401595463638e-01 3.302518047023734245e-03 8.690790625832011118e-01 1.155515352685605013e+00
1.570796326794896558e-01 3.669538688211097018e-03 9.670752407352447566e-01 1.291067407965509339e+00
1.745329251994329478e-01 4.036400059325604209e-03 1.065474354832005810e+00 1.428901226228634469e+00
1.919862177193762398e-01 4.403048314204807689e-03 1.164290235477824620e+00 1.568947395971839187e+00
2.094395102393195318e-01 4.769428619085885022e-03 1.263526327722398701e+00 1.711164786164030449e+00
2.268928027592628516e-01 5.135488498156736900e-03 1.363186759198811826e+00 1.855649695201796900e+00
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
6.230825429619756051e+00 9.145124323535497313e-02 3.477314806596606189e+01 4.756786260982588033e+01
6.248278722139700037e+00 9.180466754690375097e-02 3.486847497960397391e+01 4.702427074838713139e+01
6.265732014659642246e+00 9.216439609180814008e-02 3.496404108861325000e+01 4.644303891657168037e+01
6.283185307179586232e+00 9.252924117091261558e-02 3.505982913864345818e+01 4.602381750394147986e+01
