stephan-stansfield/cam-mech/results/force_plots/force_plots_2024-06-13_K=100/_results_array.csv

# Index | Max Radius (cm) | Peak Force Stance % | Peak Force (N) | Sitting Force (N) | Total Error
0 | 4.18 | 35.91 | 175.41 | 23.17 | 51.21
1 | 6.34 | 31.82 | 176.9 | 15.05 | 38.9
2 | 4.57 | 37.27 | 202.2 | 22.75 | 29.76
3 | 4.76 | 32.27 | 199.96 | 24.95 | 25.26
4 | 4.7 | 35.91 | 175 | 19.97 | 48.42
5 | 5.44 | 36.36 | 200 | 19.43 | 23.35
6 | 6.33 | 31.82 | 175.63 | 14.98 | 40.1
7 | 5.77 | 33.18 | 189.69 | 17.3 | 28.34
8 | 4.31 | 36.82 | 179.94 | 22.11 | 46.53
9 | 5.03 | 34.55 | 179.87 | 19.22 | 41.45
10 | 4.6 | 34.09 | 178.83 | 21.23 | 44.04
11 | 4.91 | 36.82 | 183.11 | 20.58 | 41.83
12 | 4.51 | 37.27 | 187.39 | 21.47 | 38.9
13 | 4.72 | 35.45 | 201.82 | 24.62 | 29.44
14 | 6.04 | 30.91 | 177.69 | 15.86 | 39.82
15 | 4.96 | 35 | 188.11 | 19.91 | 34.36
16 | 4.26 | 36.36 | 184.06 | 24.62 | 44.47
17 | 4.75 | 35 | 191.66 | 20.98 | 31.87
18 | 5.91 | 32.27 | 192.03 | 17.02 | 25.27
19 | 6.12 | 31.82 | 198.97 | 17.25 | 19.02
20 | 4.33 | 35.91 | 188.47 | 23.15 | 38.14
21 | 4.99 | 34.55 | 197.99 | 20.72 | 24.82
22 | 5.34 | 31.36 | 188.48 | 18.93 | 31.64
23 | 4.39 | 35.45 | 186.58 | 23.24 | 39.65
24 | 4.95 | 33.64 | 200.01 | 22.72 | 23.91
25 | 6.06 | 31.36 | 189.27 | 16.62 | 28.55
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
