stephan-stansfield/cam-mech/results/force_plots/force_plots_2024-06-13_K=200/_input_array.csv

# Index | Gear Ratio 1 | Gear Ratio 2 | Gear Ratio 3 | Gear Ratio 4 | Gear Ratio 5 | Gear Ratio 6 | Gear Ratio 7 | Gear Ratio 8 | Percentage 1 | Percentage 2 | Percentage 3 | Percentage 4 | Percentage 5 | Percentage 6 | Percentage 7 | Percentage 8 | Initial Gear Ratio
0.00 | 0.81 | 1.44 | 0.33 | 0.06 | 1.06 | 1.50 | 0.90 | 1.11 | 0.02 | 1.00 | 1.84 | 2.45 | 3.14 | 4.69 | 5.10 | 6.28 | 1.81
1.00 | 0.40 | 1.42 | 0.36 | 0.12 | 0.54 | 1.50 | 1.18 | 1.27 | 0.04 | 1.27 | 1.86 | 2.50 | 3.25 | 3.94 | 5.07 | 5.91 | 0.64
2.00 | 0.80 | 1.38 | 0.39 | 0.05 | 1.13 | 1.50 | 0.89 | 0.64 | 0.04 | 0.99 | 2.09 | 2.48 | 3.19 | 4.71 | 4.92 | 6.19 | 1.74
3.00 | 0.82 | 1.50 | 0.33 | 0.05 | 1.30 | 1.50 | 0.90 | 0.77 | 0.01 | 0.98 | 2.01 | 2.45 | 3.15 | 4.70 | 5.04 | 6.26 | 1.82
4.00 | 0.38 | 1.41 | 0.46 | 0.12 | 0.51 | 1.50 | 1.18 | 1.31 | 0.23 | 1.27 | 1.86 | 2.49 | 3.25 | 3.93 | 5.05 | 5.90 | 0.67
5.00 | 0.56 | 1.39 | 0.25 | 0.07 | 1.06 | 1.49 | 0.90 | 0.99 | 0.27 | 0.99 | 2.00 | 2.45 | 3.22 | 4.68 | 5.06 | 6.05 | 1.84
6.00 | 0.81 | 1.44 | 0.33 | 0.06 | 1.13 | 1.50 | 0.87 | 1.10 | 0.00 | 1.00 | 1.84 | 2.45 | 3.14 | 4.71 | 5.10 | 6.28 | 1.81
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
