stephan-stansfield/cam-mech/results/force_plots/force_plots_2024-06-13_K=200/_results_array.csv

# Index | Max Radius (cm) | Peak Force Stance % | Peak Force (N) | Sitting Force (N) | Total Error
0.00 | 5.41 | 37.27 | 192.07 | 19.38 | 32.14
1.00 | 3.83 | 33.64 | 176.46 | 24.88 | 49.60
2.00 | 6.10 | 33.64 | 199.88 | 24.37 | 25.69
3.00 | 5.64 | 35.45 | 177.20 | 17.62 | 43.43
4.00 | 3.93 | 32.73 | 179.65 | 24.99 | 45.61
5.00 | 5.13 | 35.45 | 200.00 | 21.94 | 24.95
6.00 | 5.16 | 37.27 | 175.01 | 17.92 | 47.74
7.00 | 4.32 | 32.73 | 185.05 | 23.41 | 38.63
8.00 | 5.72 | 34.09 | 190.28 | 19.12 | 30.49
9.00 | 3.91 | 33.18 | 176.69 | 24.45 | 48.48
10.00 | 5.43 | 35.00 | 189.85 | 19.67 | 32.38
11.00 | 5.93 | 34.55 | 199.94 | 21.03 | 23.19
12.00 | 4.71 | 35.91 | 175.80 | 20.68 | 48.34
13.00 | 5.35 | 36.82 | 186.40 | 19.04 | 37.01
14.00 | 5.32 | 35.00 | 177.91 | 18.42 | 43.06
15.00 | 4.37 | 31.82 | 194.56 | 24.17 | 30.33
16.00 | 5.05 | 34.55 | 177.52 | 20.09 | 44.66
17.00 | 4.89 | 36.36 | 199.24 | 22.62 | 27.29
18.00 | 4.88 | 35.91 | 192.18 | 22.88 | 34.17
19.00 | 5.42 | 33.64 | 177.32 | 19.72 | 43.60
20.00 | 5.78 | 34.09 | 198.21 | 20.22 | 23.66
21.00 | 4.90 | 36.36 | 178.40 | 19.78 | 45.29
22.00 | 4.47 | 32.27 | 185.95 | 23.23 | 37.55
23.00 | 5.18 | 36.82 | 195.42 | 20.31 | 29.26
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
