stephan-stansfield/cam-mech/results/cams/cams_2024-06-13_K=100/cam_plot_66.png

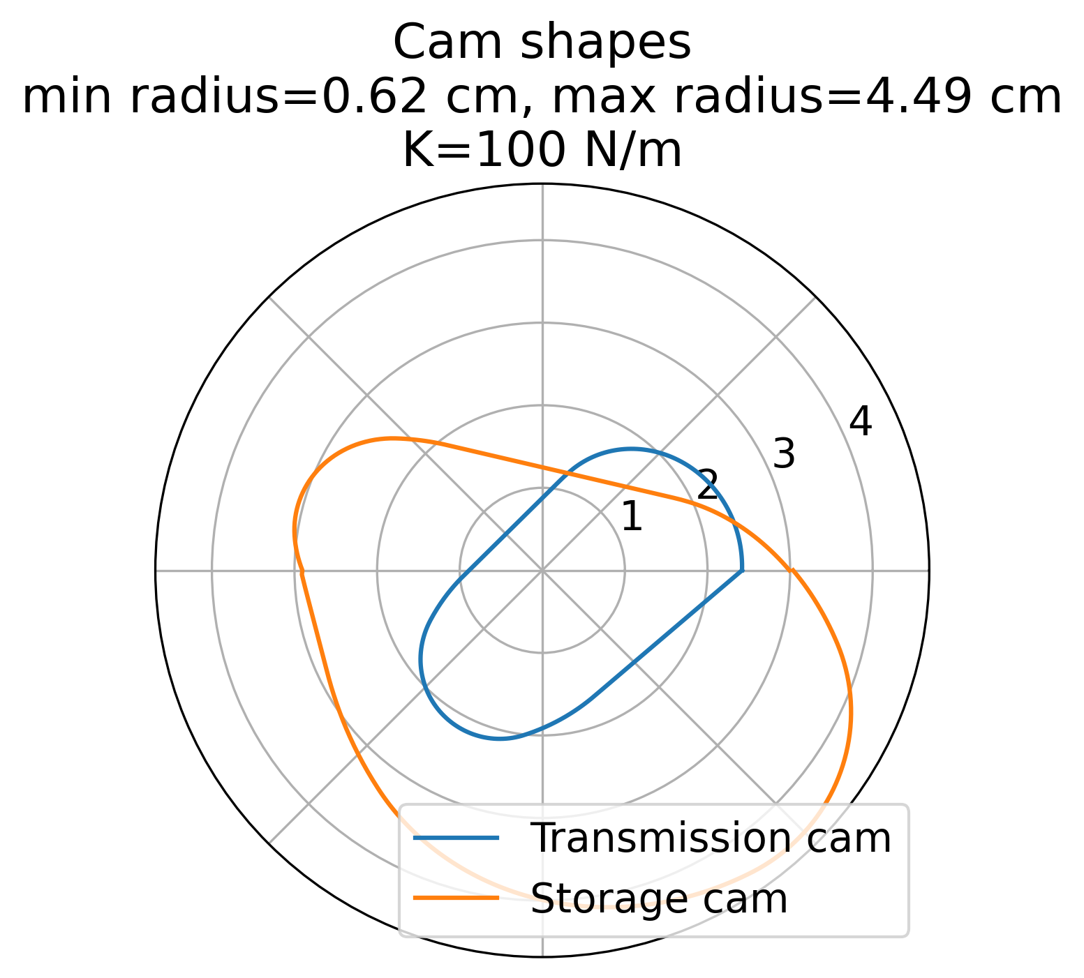
results/cams/cams_2024-06-13_K=100/cam_plot_66.png
