stephan-stansfield/cam-mech/results/cams/cams_2024-06-13_K=200/cam_plot_186.png

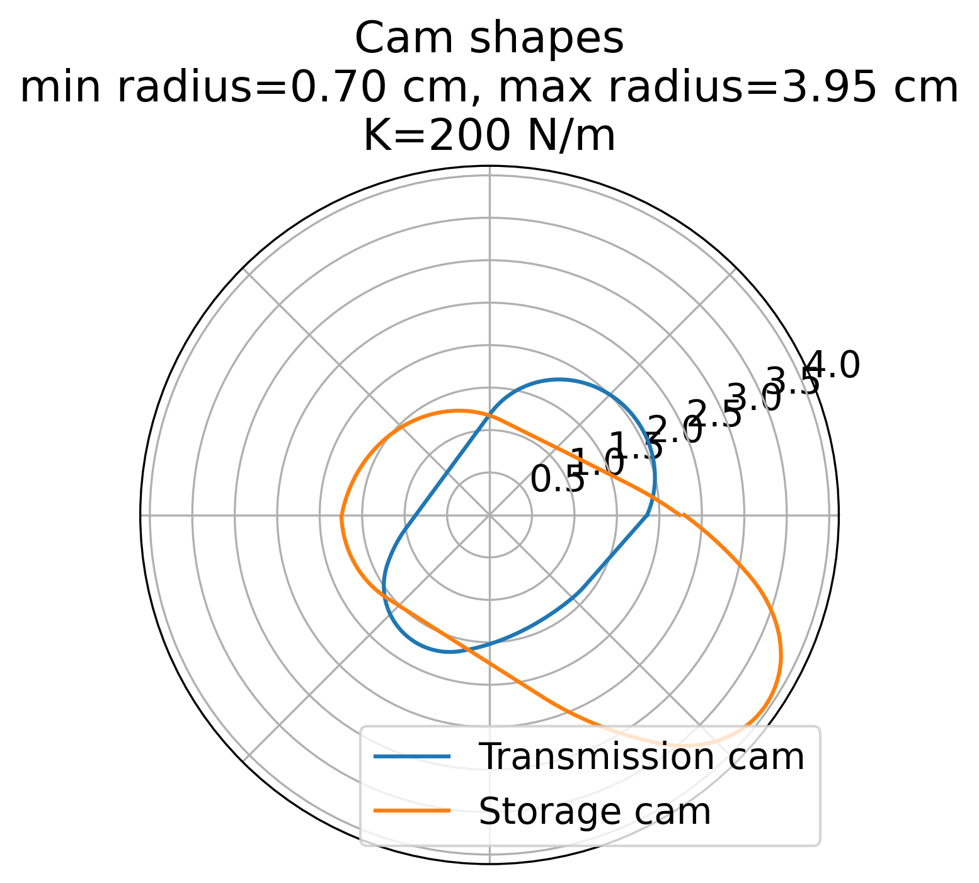
results/cams/cams_2024-06-13_K=200/cam_plot_186.png
