stephan-stansfield/cam-mech/results/cams/cams_2026-02-06/plots/cam_plot_84.png

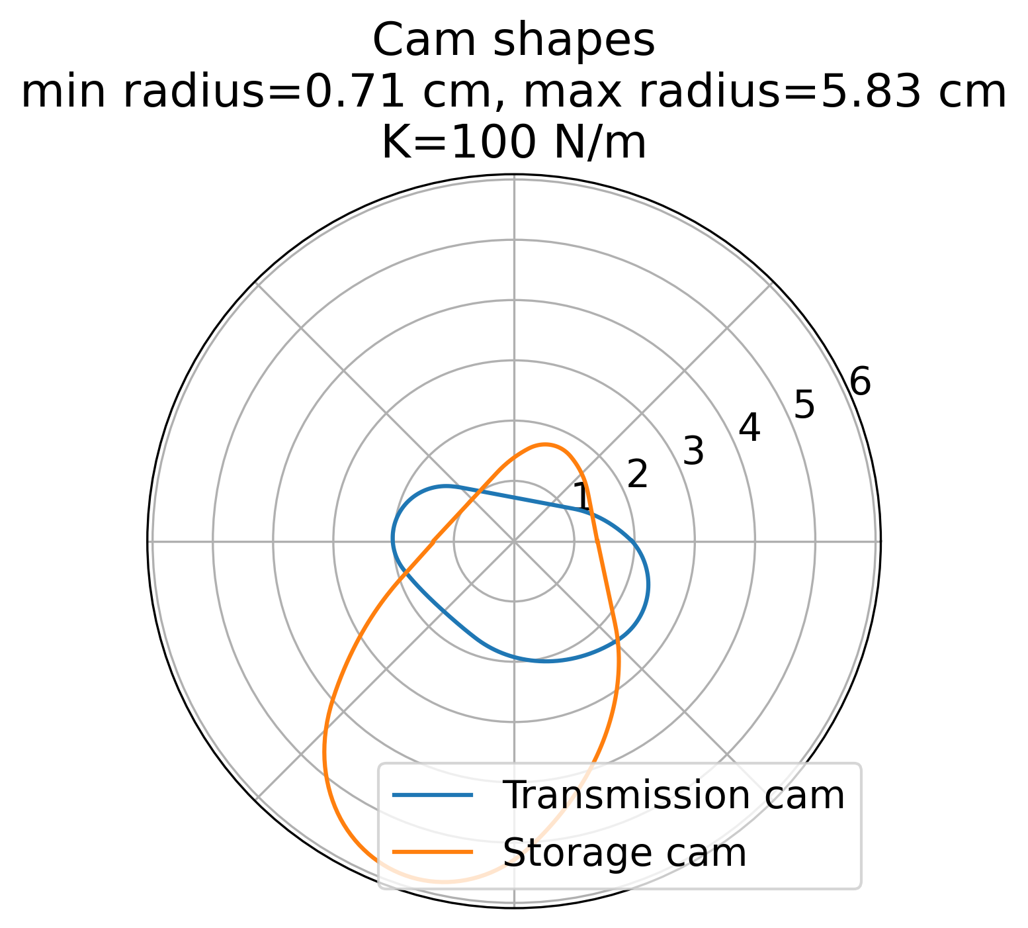
results/cams/cams_2026-02-06/plots/cam_plot_84.png
