stephan-stansfield/cam-mech/results/cams/cams_2026-02-18/plots/cam_plot_26.png

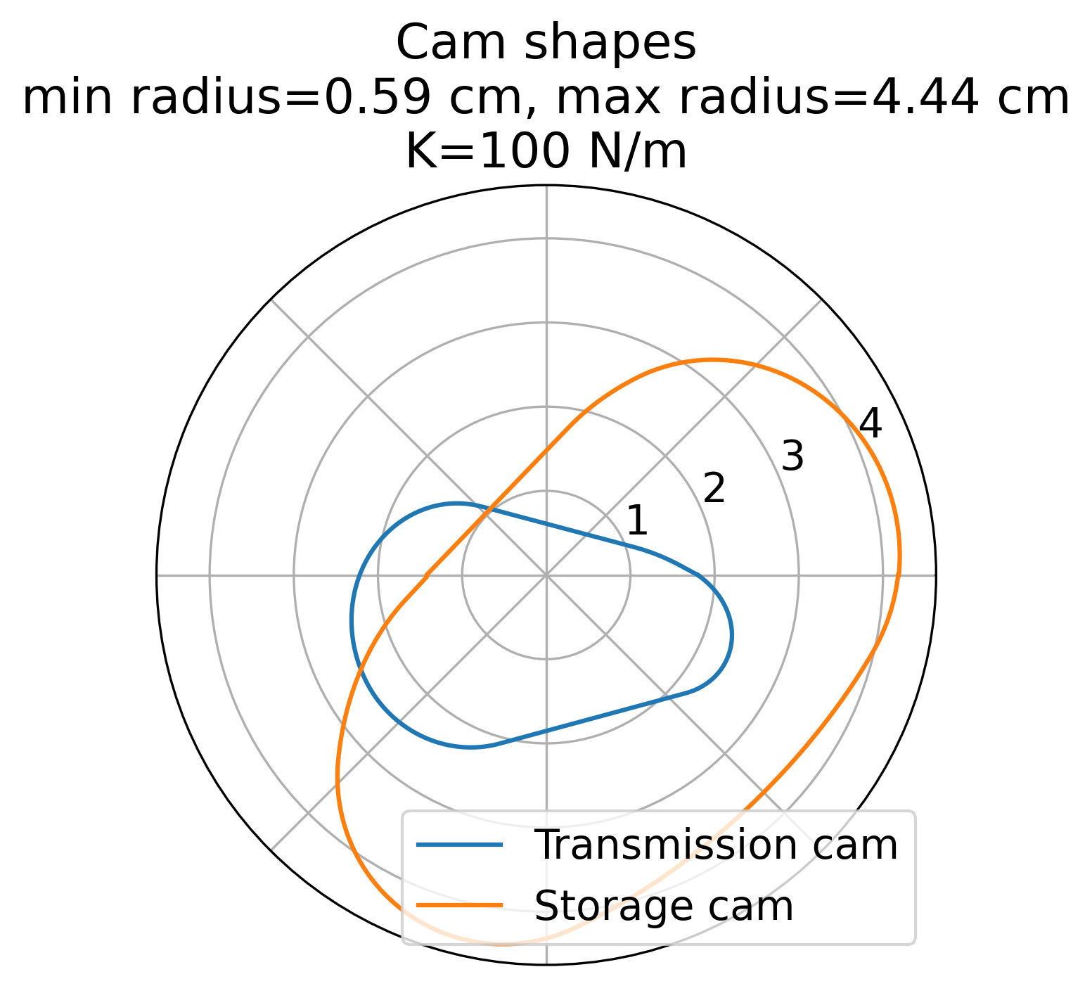
results/cams/cams_2026-02-18/plots/cam_plot_26.png
