stephan-stansfield/cam-mech/results/cams/cams_2026-09-17/cam_plots/cam_plot_50.png

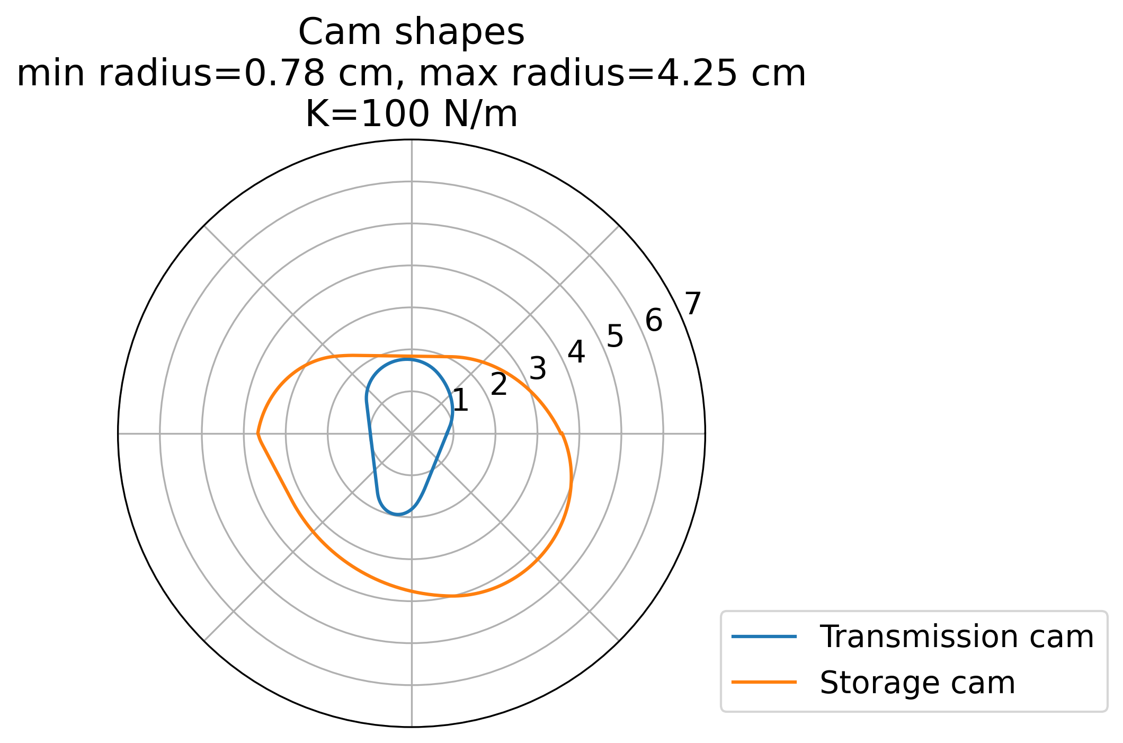
results/cams/cams_2026-09-17/cam_plots/cam_plot_50.png
