stephan-stansfield/cam-mech/results/cams/cams_2026-09-17_perc=40, max F=60N/cam_plots/cam_plot_109.png

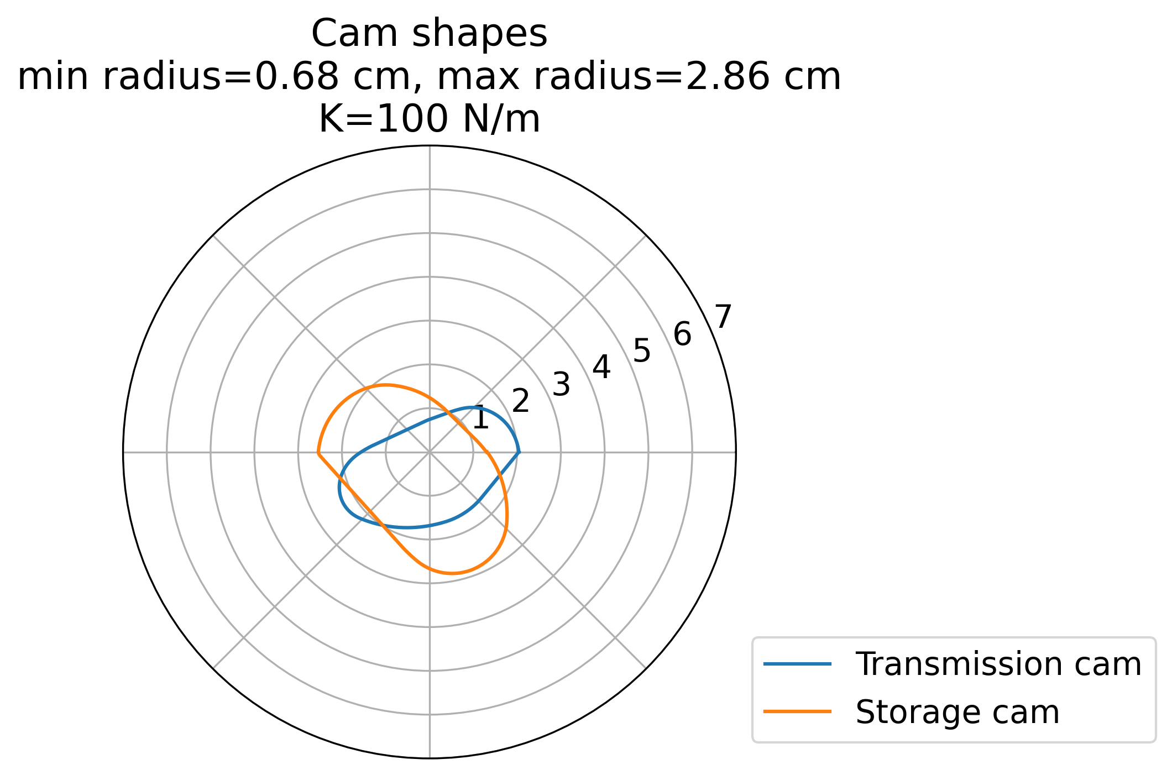
results/cams/cams_2026-09-17_perc=40, max F=60N/cam_plots/cam_plot_109.png
