stephan-stansfield/cam-mech/results/force_plots/force_plots_2024-06-13_K=100/force_plot_18.png

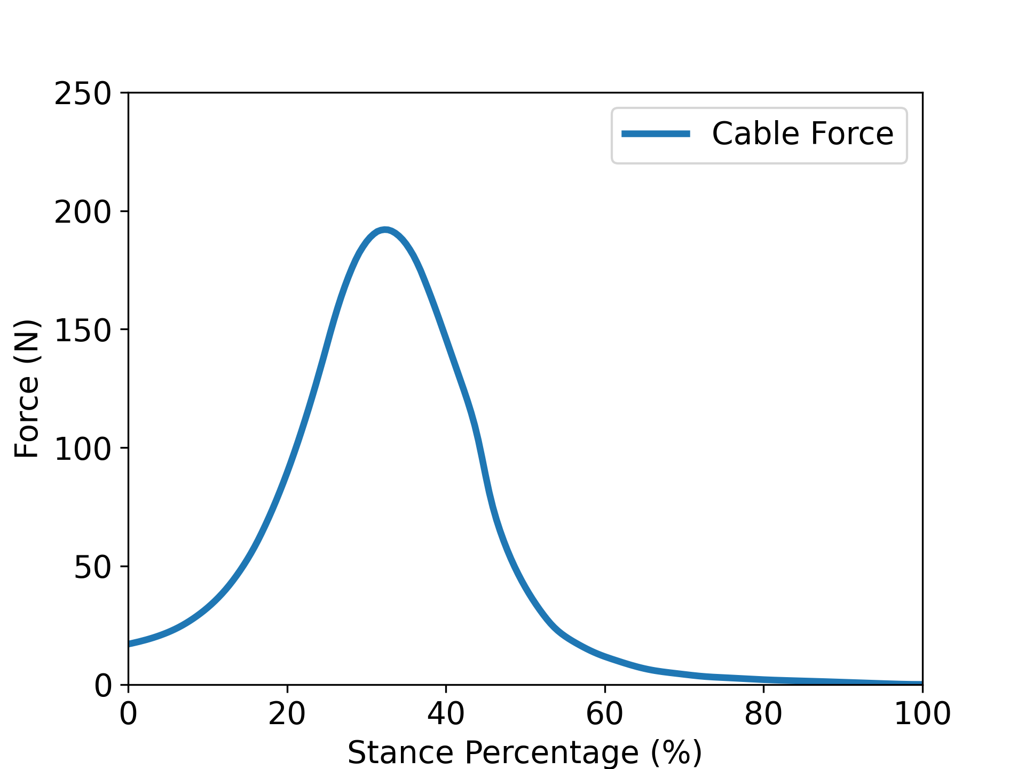
results/force_plots/force_plots_2024-06-13_K=100/force_plot_18.png
