stephan-stansfield/cam-mech/results/force_plots/force_plots_2024-07-22/force_plot_26.png

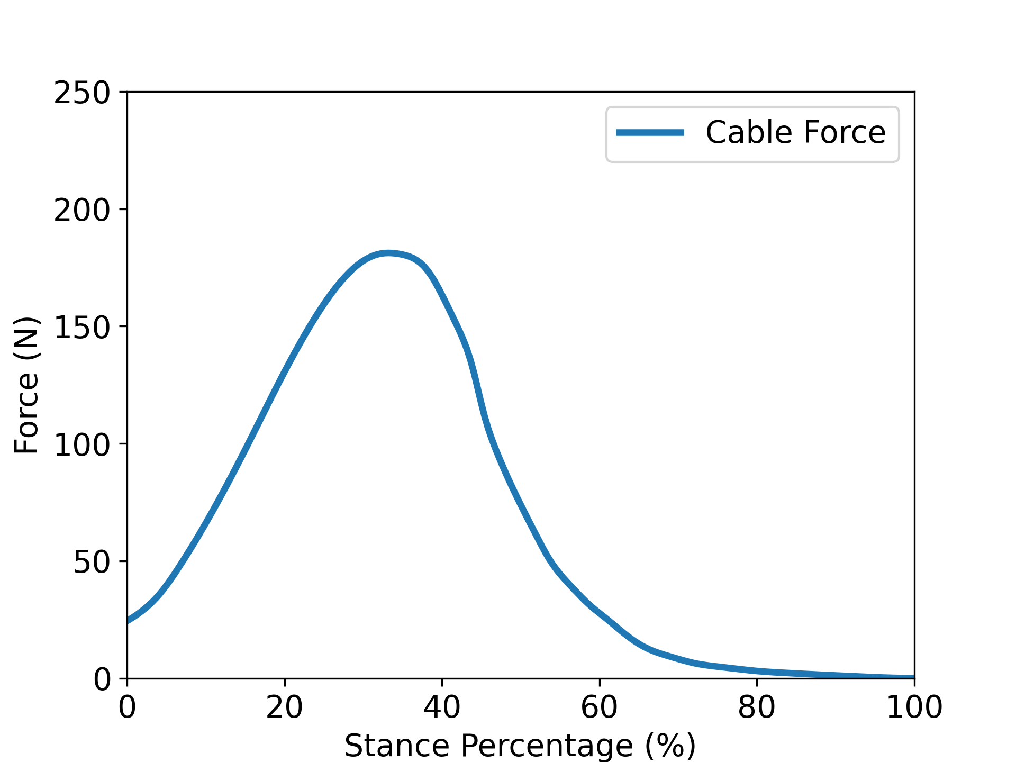
results/force_plots/force_plots_2024-07-22/force_plot_26.png
