stephan-stansfield/cam-mech/results/force_plots/force_plots_2025-12-11_K=100, max F=100N/force_plot_100.png

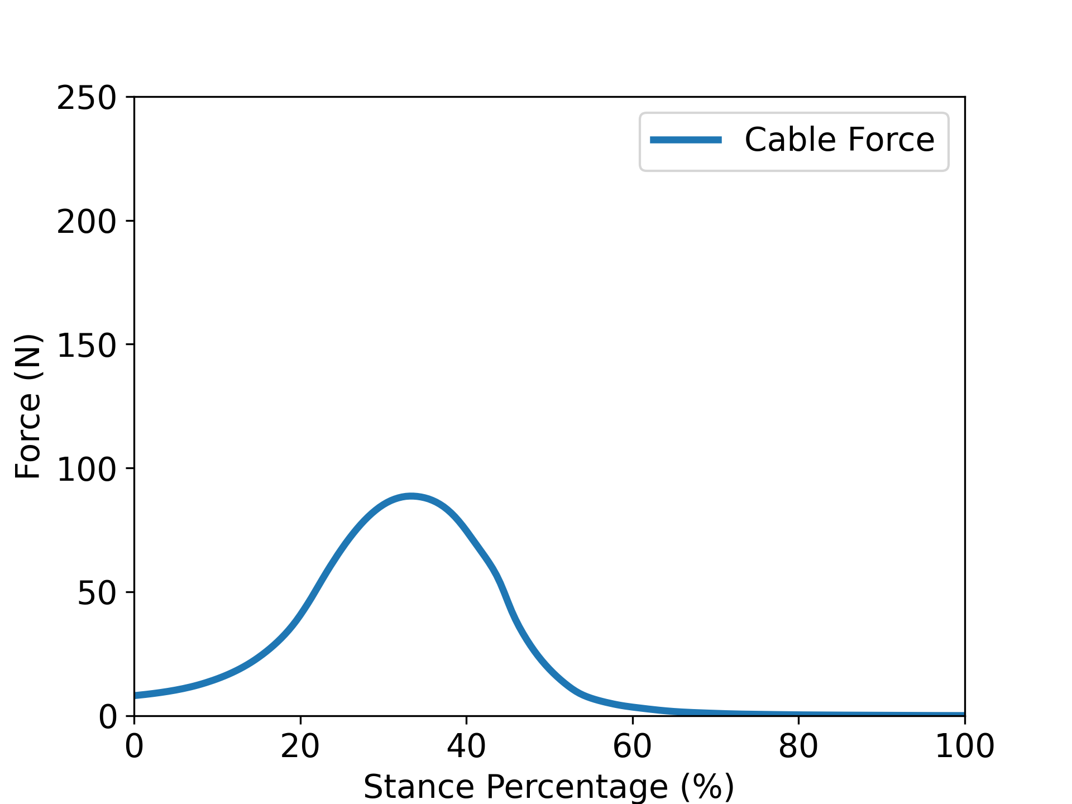
results/force_plots/force_plots_2025-12-11_K=100, max F=100N/force_plot_100.png
