stephan-stansfield/cam-mech/results/force_plots/force_plots_2026-02-06/force_plot_unscaled_17.png

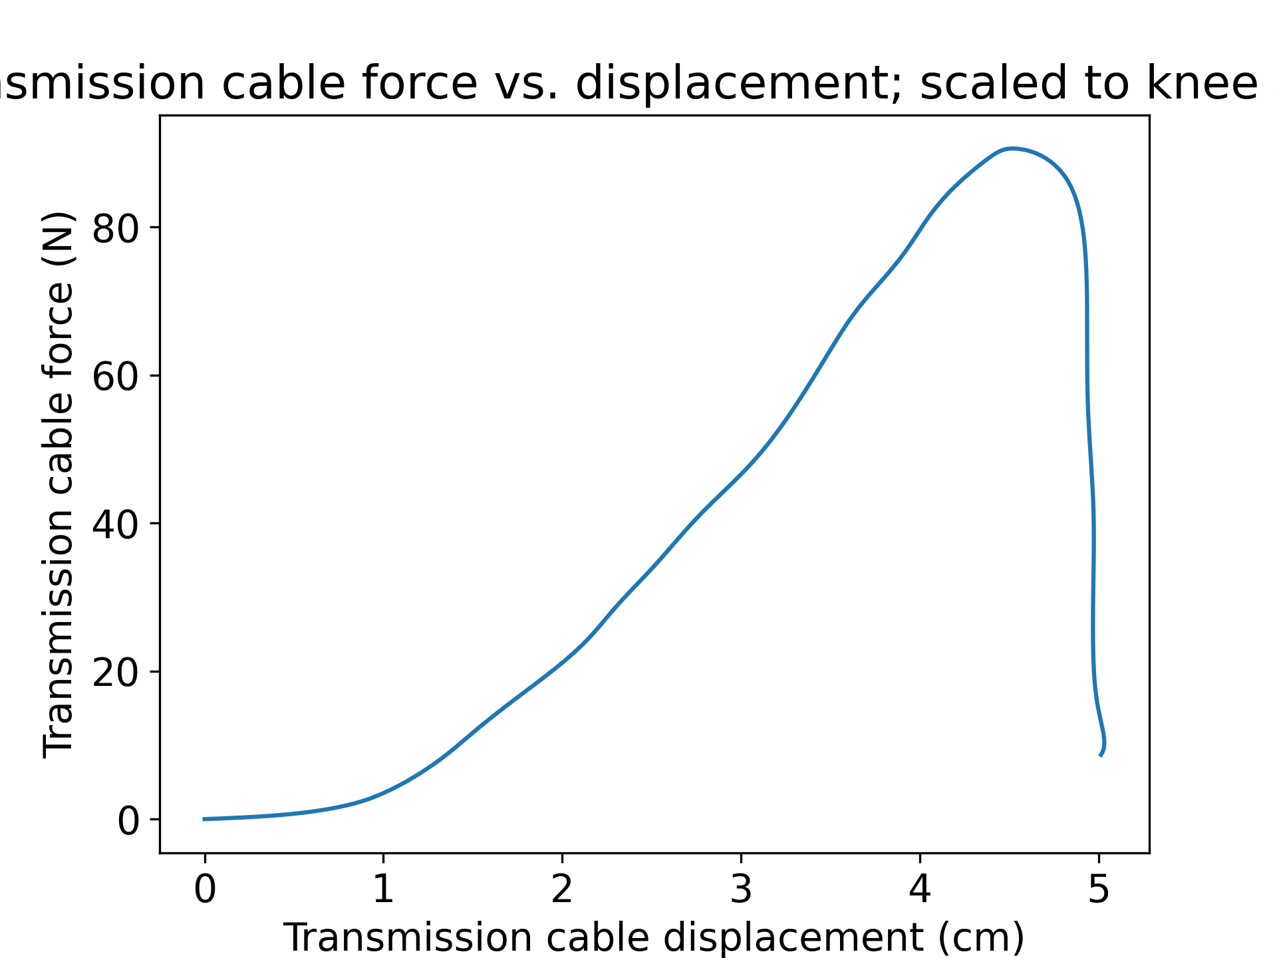
results/force_plots/force_plots_2026-02-06/force_plot_unscaled_17.png
