stephan-stansfield/cam-mech/results/force_plots/force_plots_2026-02-06/force_plot_unscaled_187.png

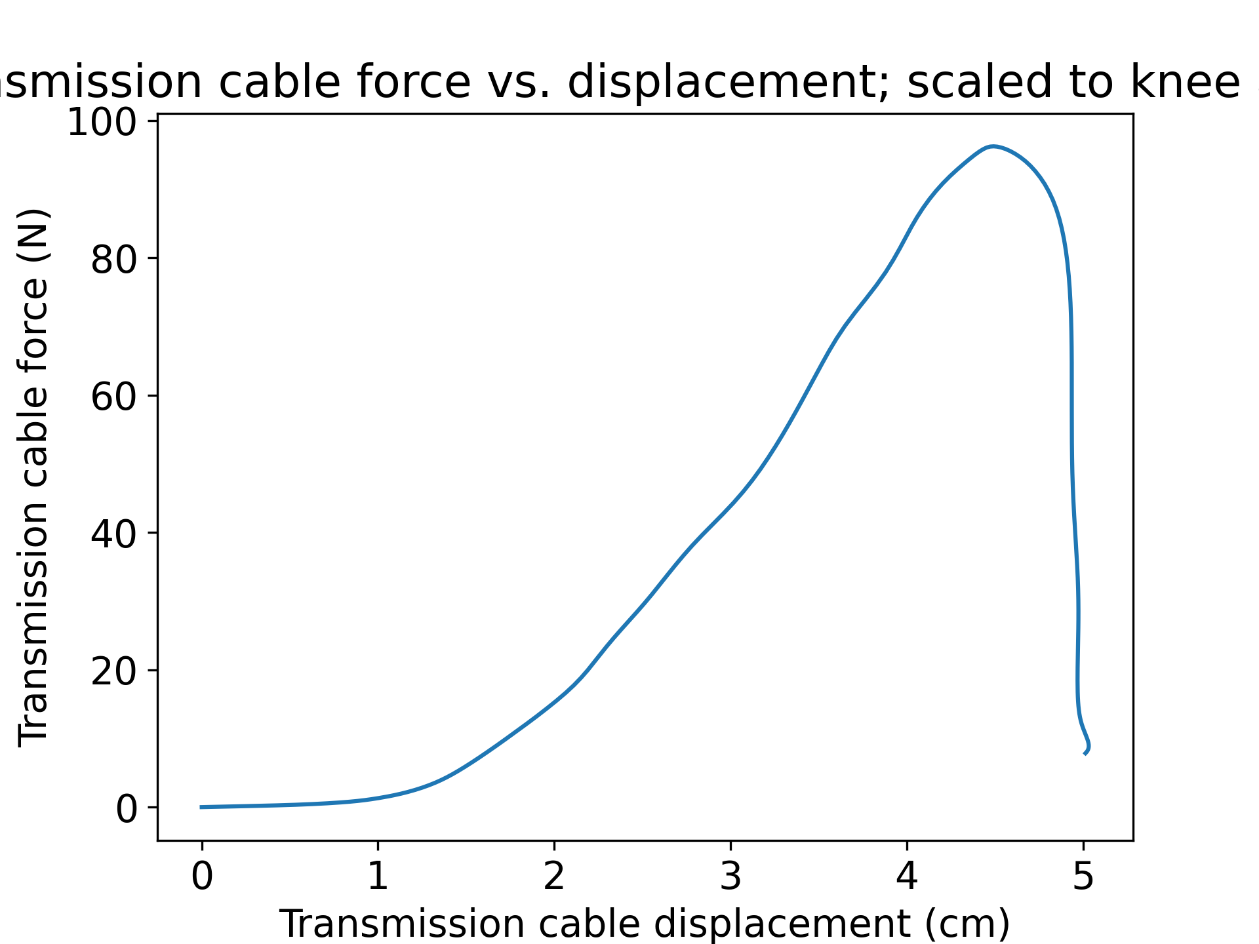
results/force_plots/force_plots_2026-02-06/force_plot_unscaled_187.png
