stephan-stansfield/cam-mech/results/force_plots/force_plots_2026-02-18/force_plot_unscaled_1.png

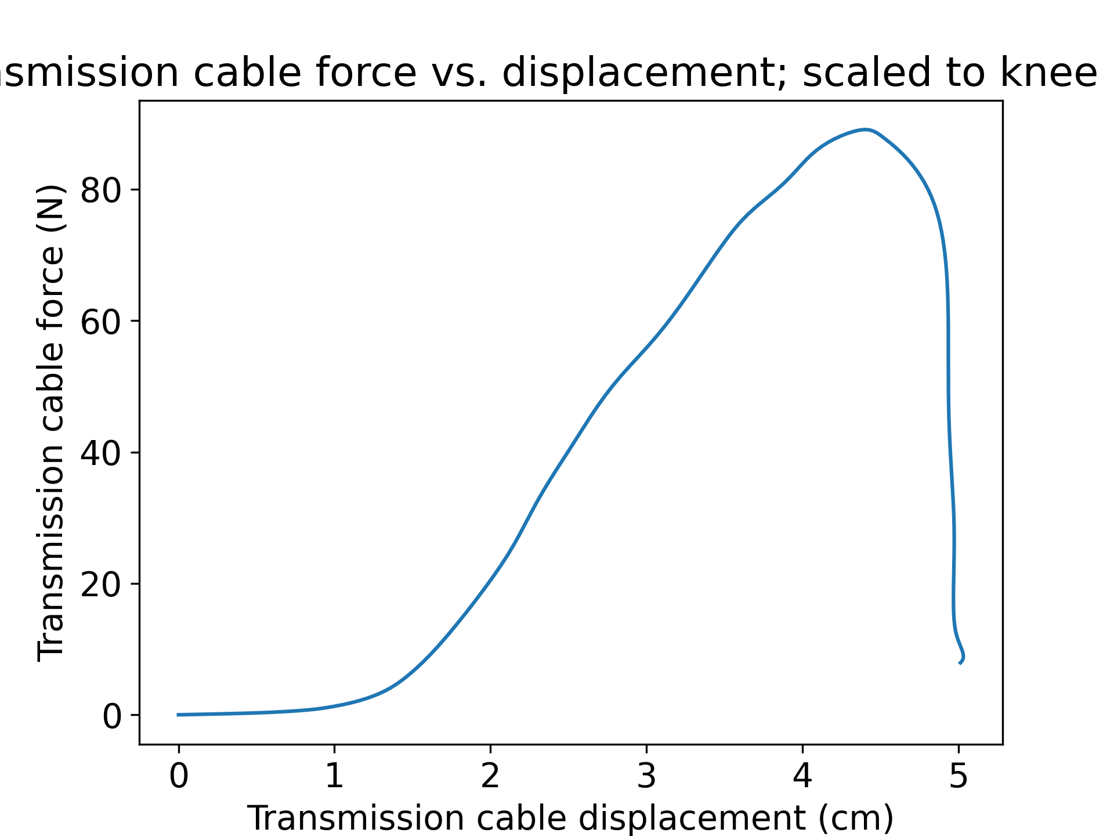
results/force_plots/force_plots_2026-02-18/force_plot_unscaled_1.png
