stephan-stansfield/cam-mech/results/forces/force_plots_2025-12-11_K=200, max F=100N/force_plot_155.png

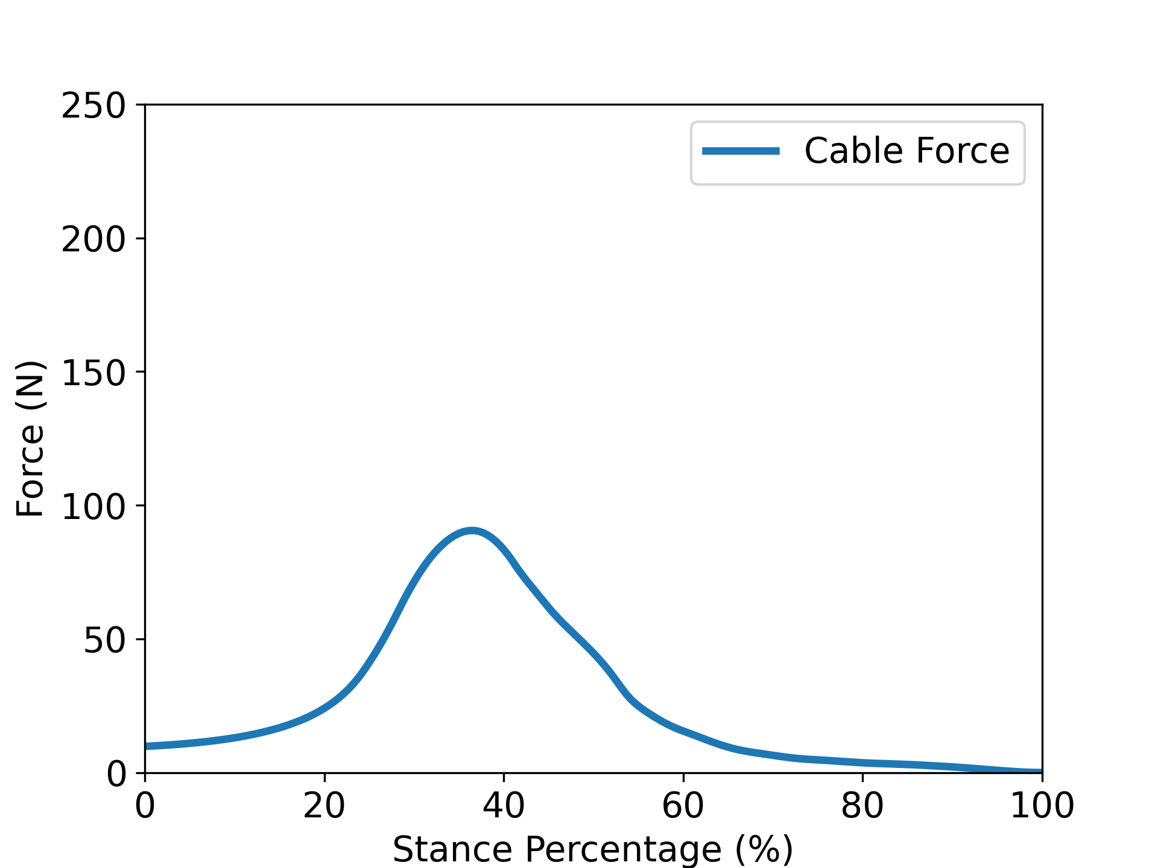
results/forces/force_plots_2025-12-11_K=200, max F=100N/force_plot_155.png
