stephan-stansfield/cam-mech/results/forces/force_plots_2026-08-27_F_range_12-5_perc_range_5_sit_max_12-5_targ_perc_40/cam_plot_42.png

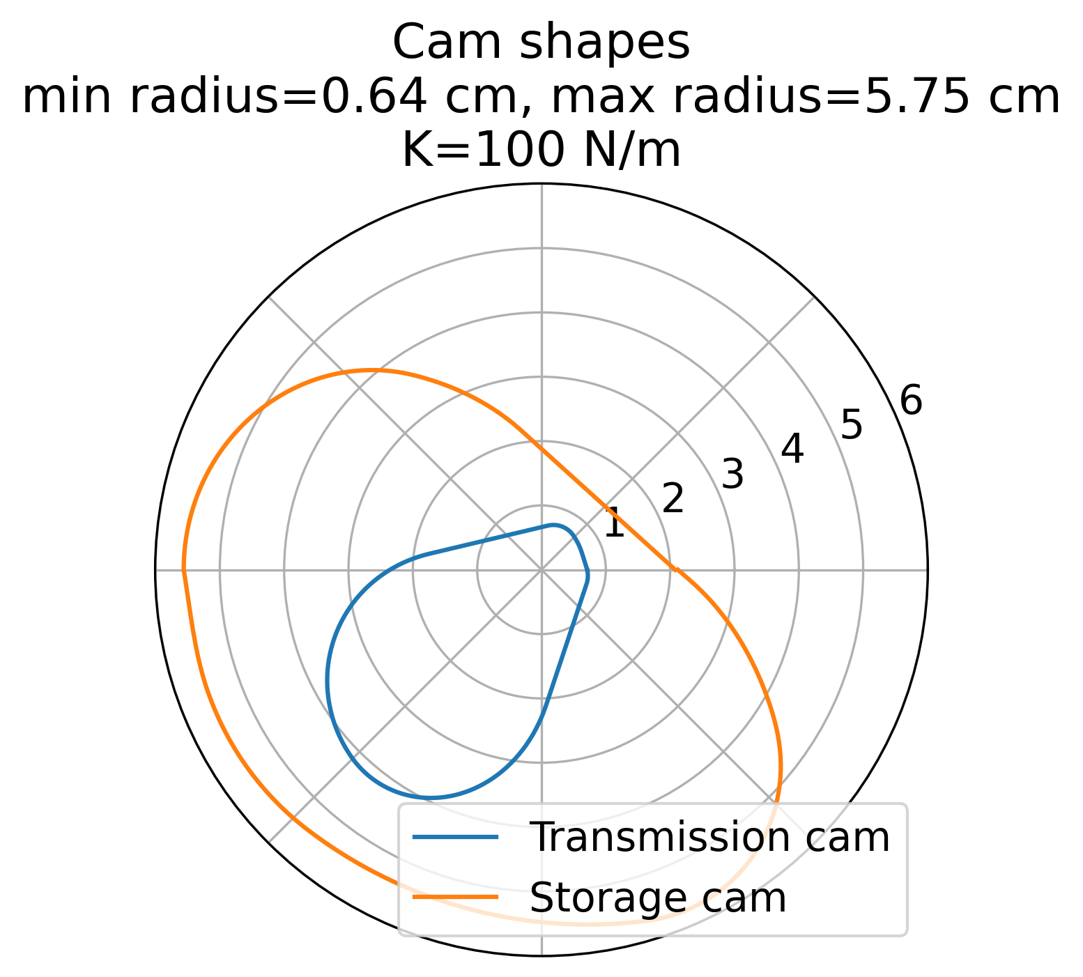
results/forces/force_plots_2026-08-27_F_range_12-5_perc_range_5_sit_max_12-5_targ_perc_40/cam_plot_42.png
