stephan-stansfield/cam-mech/results/forces/force_plots_2026-08-27_F_range_25_perc_range_25_sit_max_25/force_plot_119.png

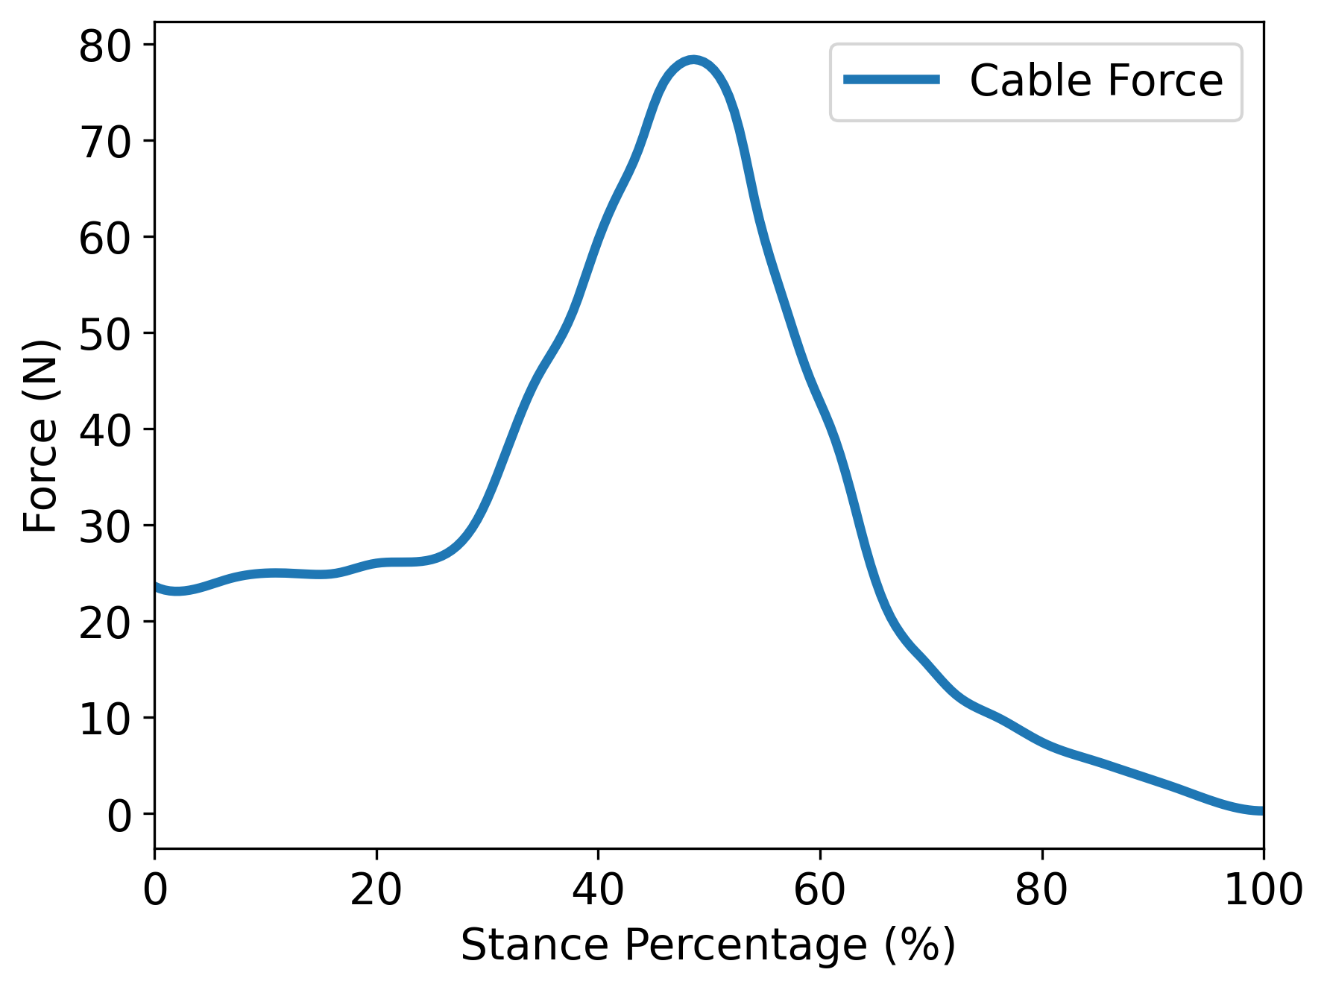
results/forces/force_plots_2026-08-27_F_range_25_perc_range_25_sit_max_25/force_plot_119.png
