stephan-stansfield/cam-mech/results/forces/force_plots_2026-09-01/force_plot_unscaled_72.png

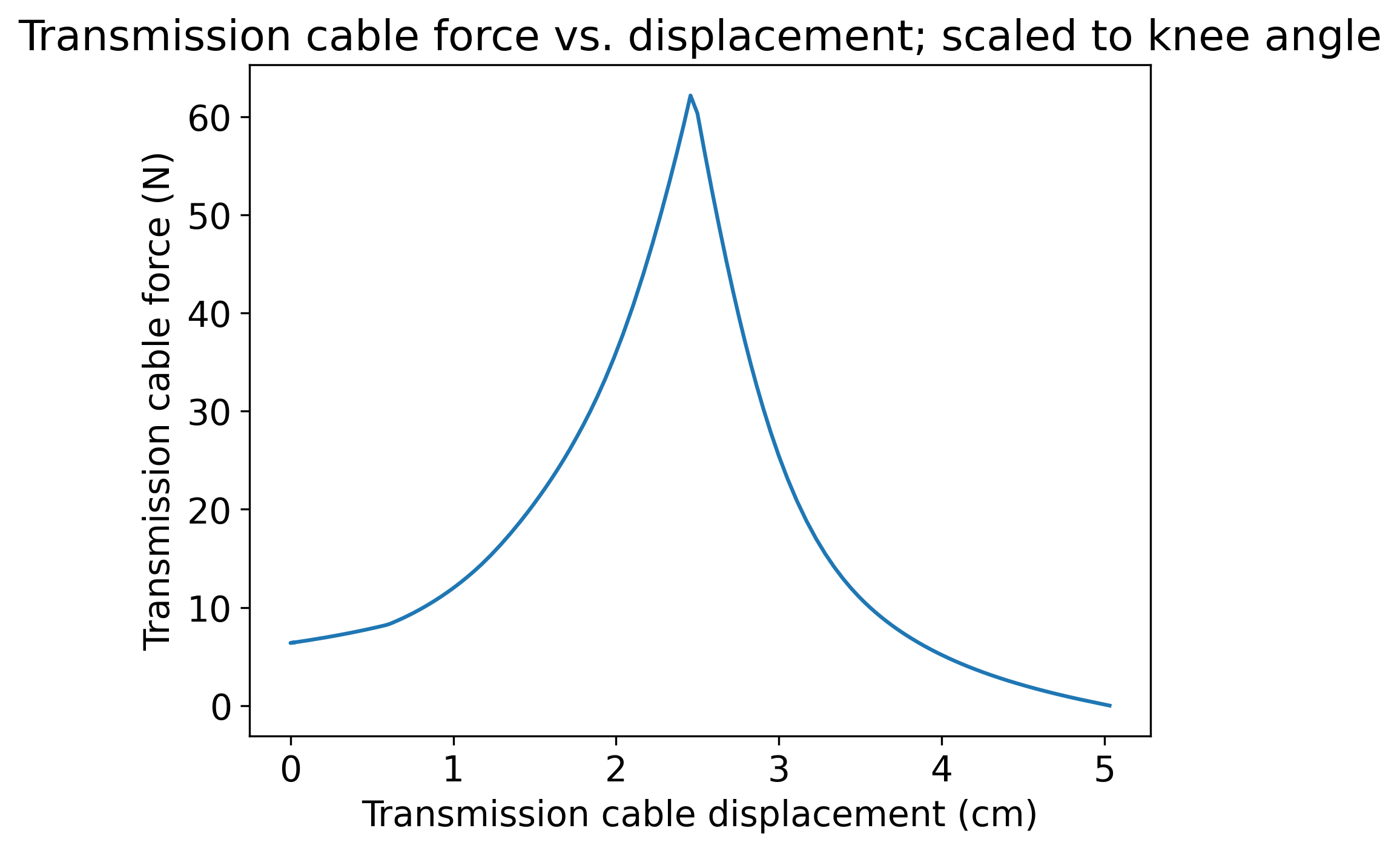
results/forces/force_plots_2026-09-01/force_plot_unscaled_72.png
