stephan-stansfield/cam-mech/results/forces/force_plots_2026-09-11/cam_plot_93.png

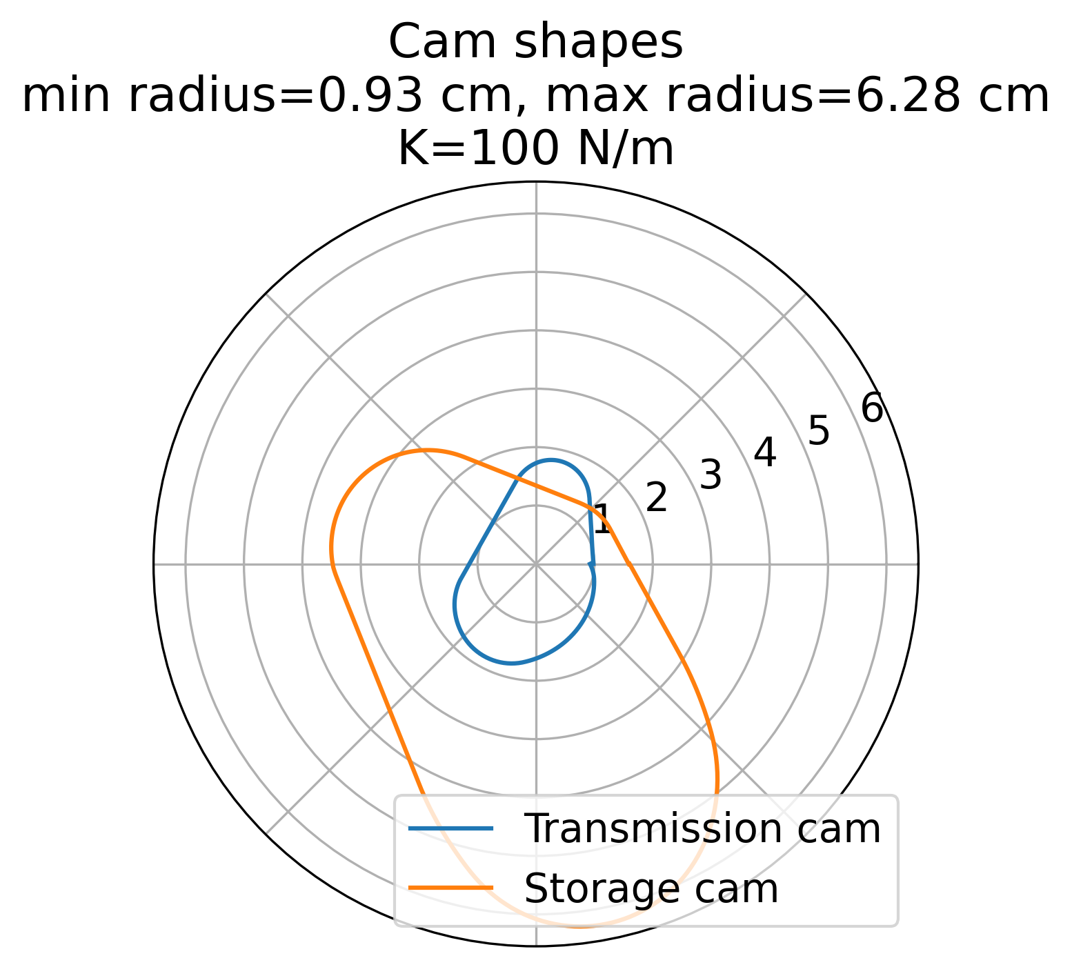
results/forces/force_plots_2026-09-11/cam_plot_93.png
