stephan-stansfield/cam-mech/results/forces/force_plots_2026-09-15/cam_plot_21.png

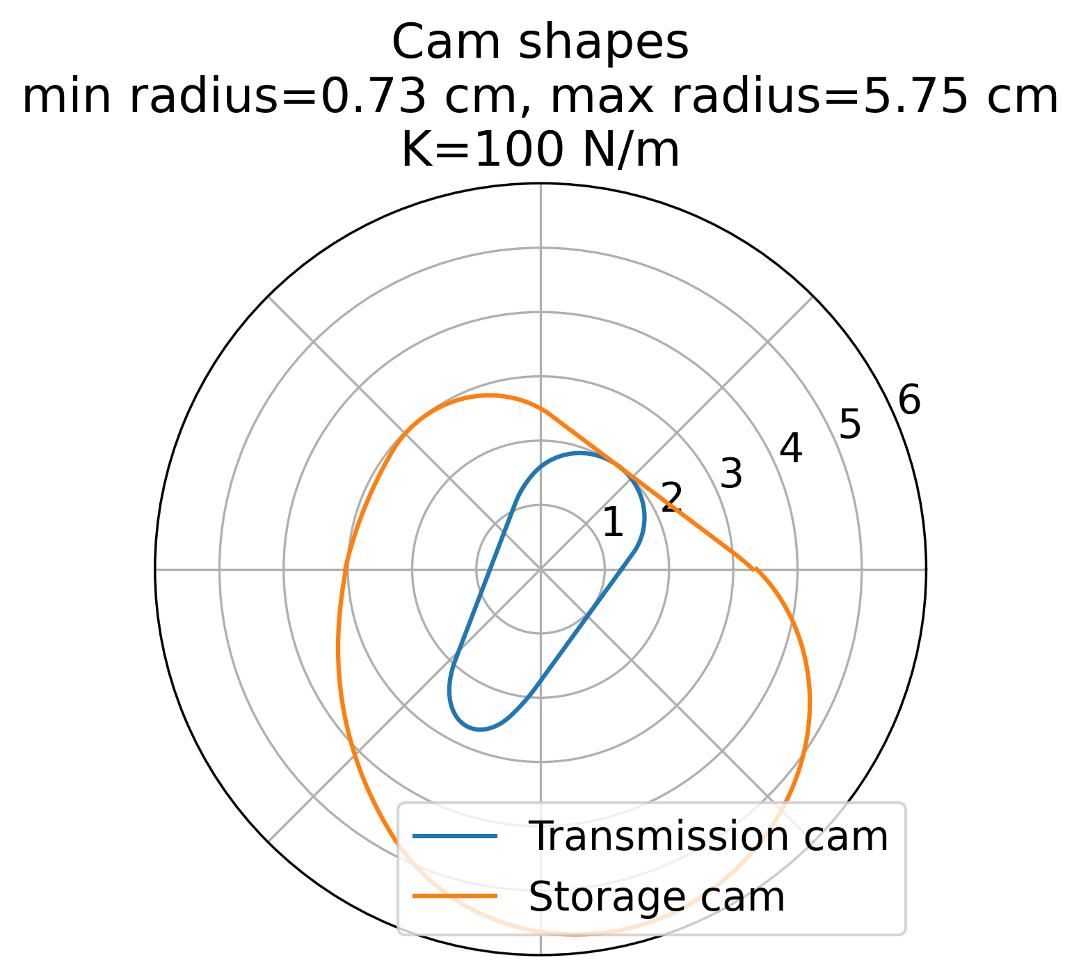
results/forces/force_plots_2026-09-15/cam_plot_21.png
