stephan-stansfield/cam-mech/results/forces/force_plots_2026-09-15/force_plot_99.png

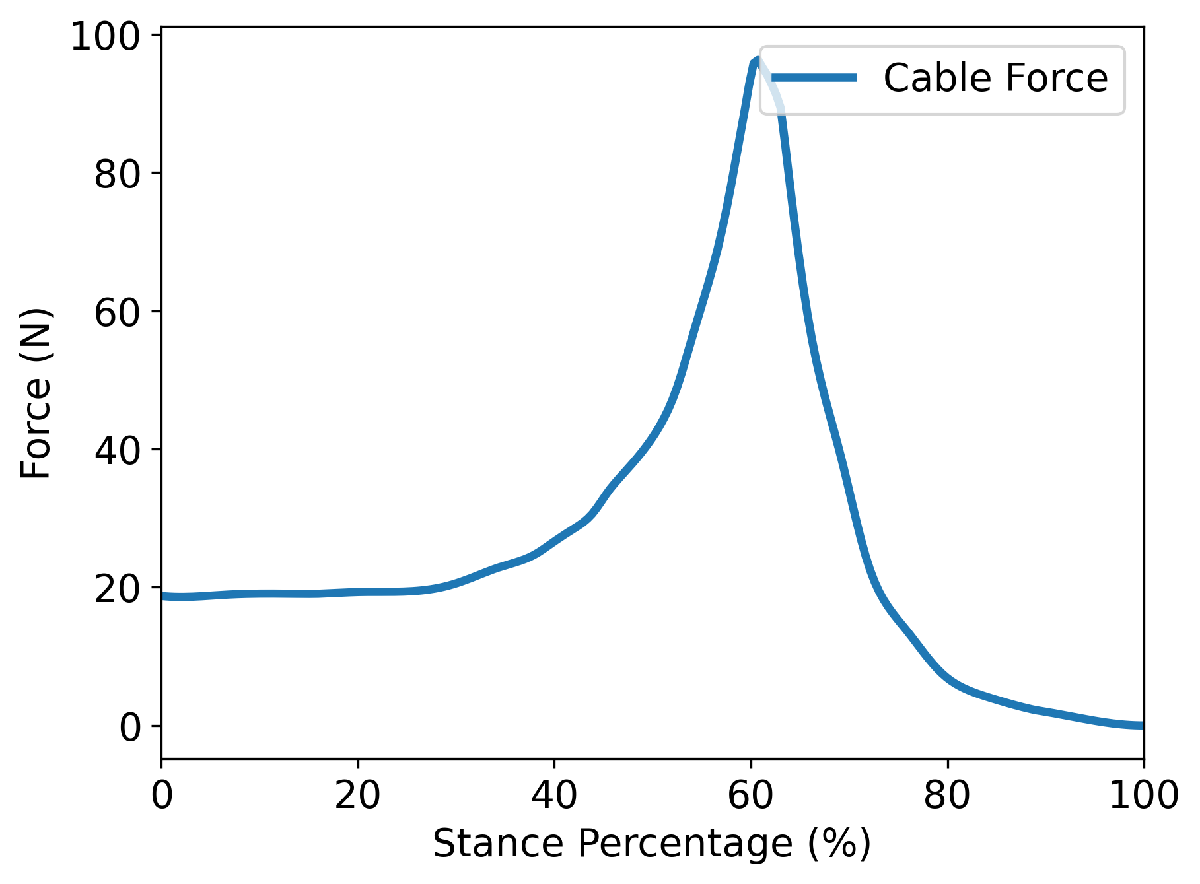
results/forces/force_plots_2026-09-15/force_plot_99.png
