stephan-stansfield/cam-mech/results/forces/forces_2026-09-15/cam_plot_63.png

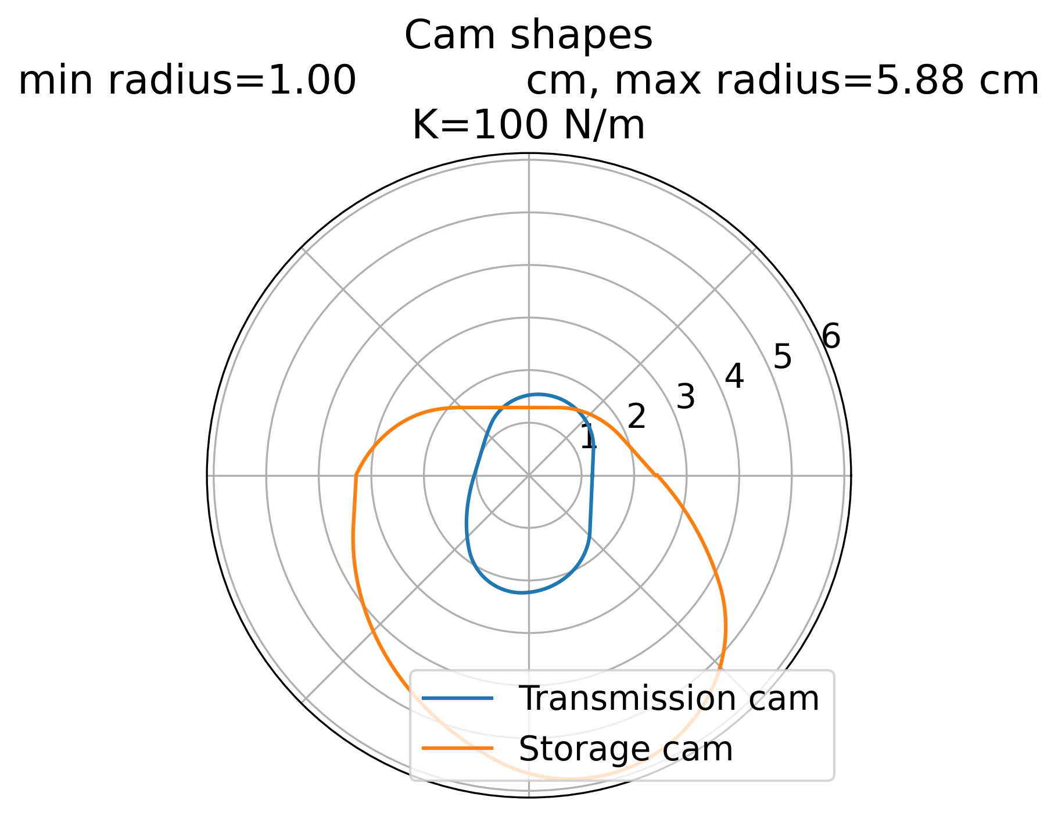
results/forces/forces_2026-09-15/cam_plot_63.png
