stephan-stansfield/cam-mech/results/forces/forces_2026-09-15/force_plot_16.png

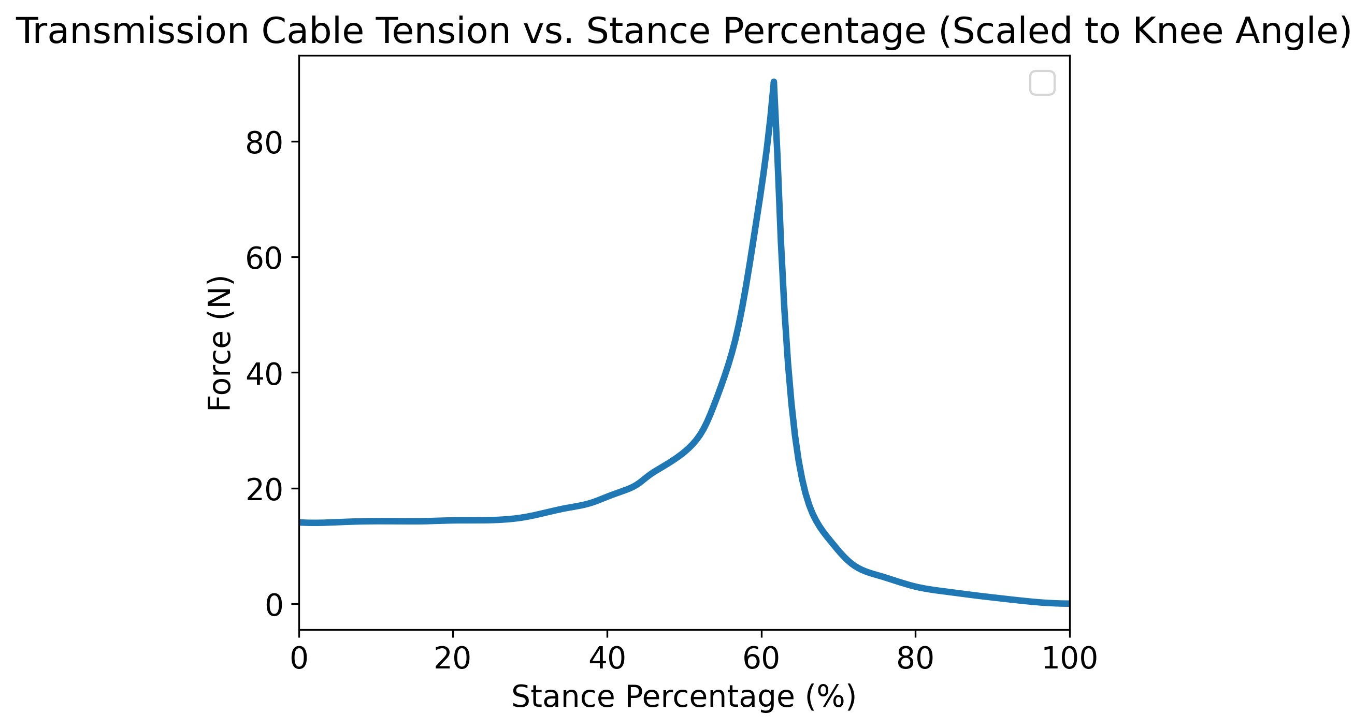
results/forces/forces_2026-09-15/force_plot_16.png
