stephan-stansfield/cam-mech/results/forces/forces_2026-09-15/force_plot_unscaled_24.png

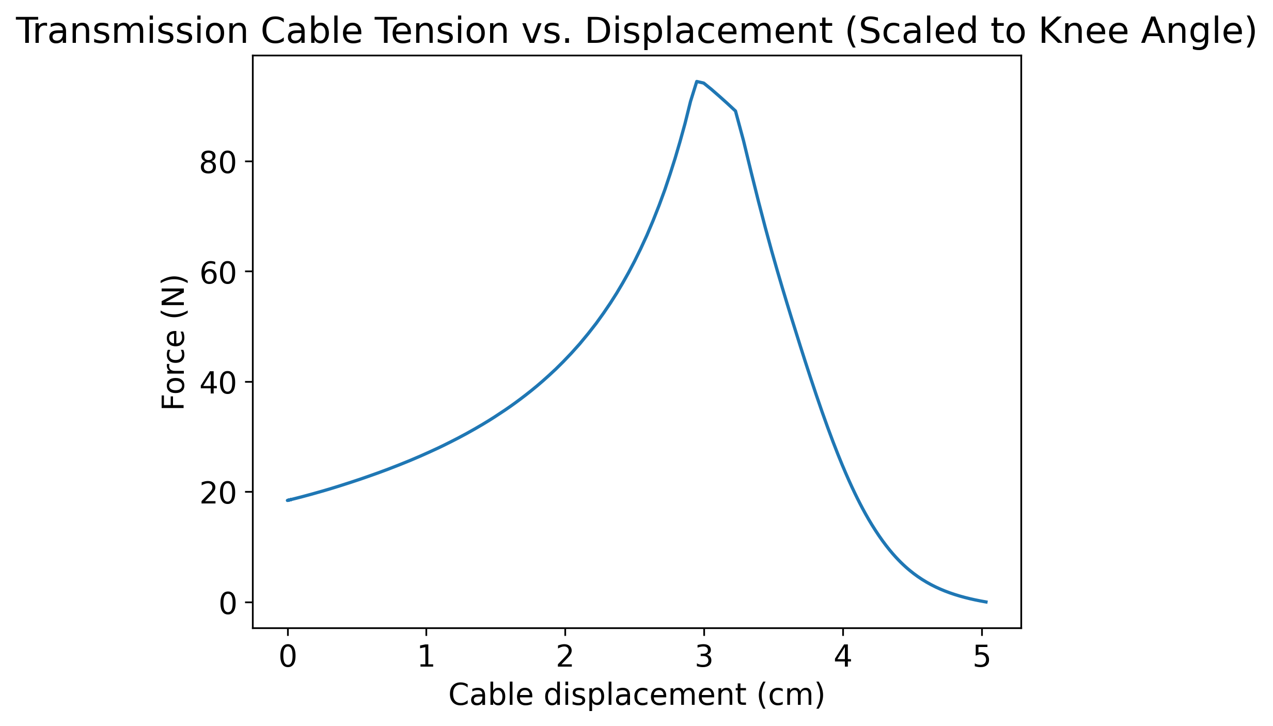
results/forces/forces_2026-09-15/force_plot_unscaled_24.png
