stephan-stansfield/cam-mech/results/forces/forces_2026-09-15/force_plot_unscaled_97.png

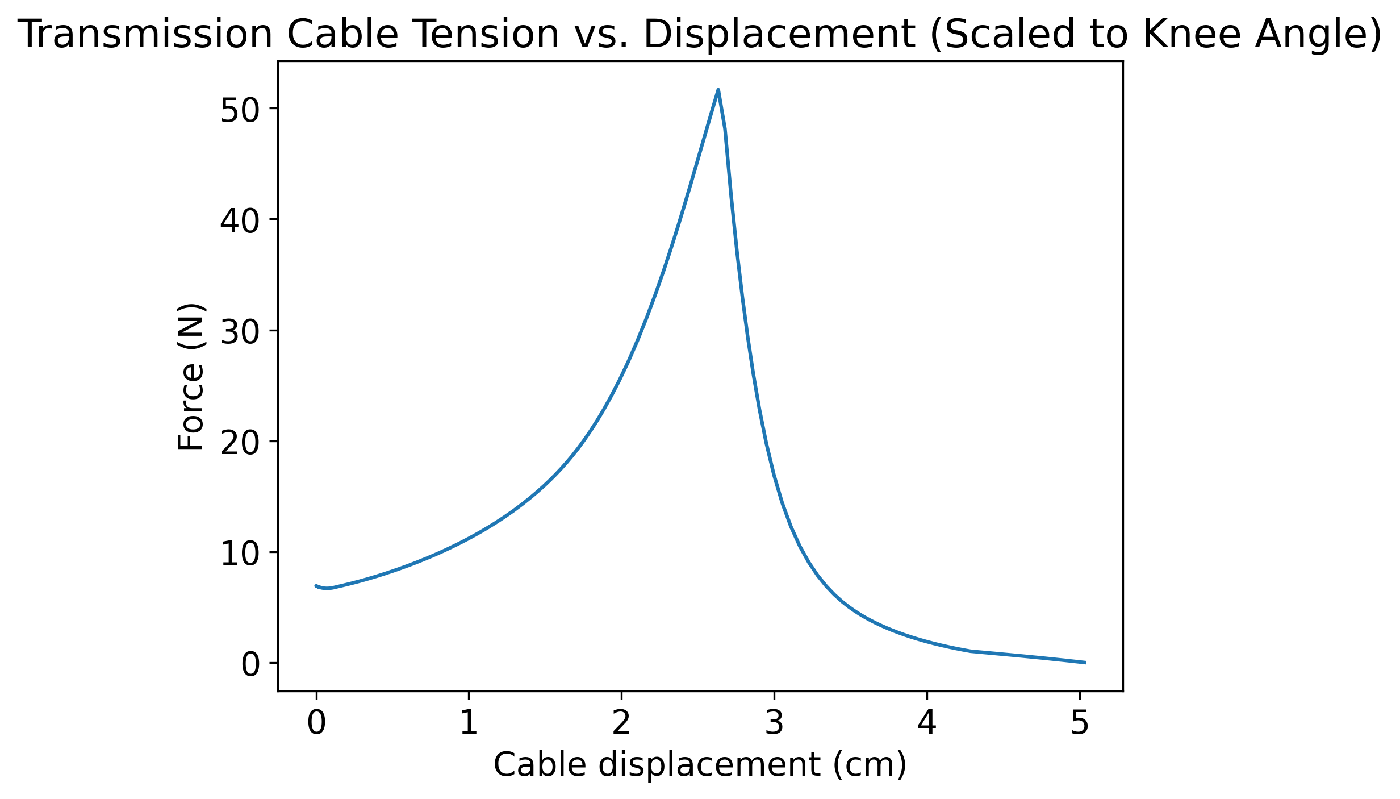
results/forces/forces_2026-09-15/force_plot_unscaled_97.png
