stephan-stansfield/cam-mech/results/forces/forces_2026-09-17/force_plot_unscaled_65.png

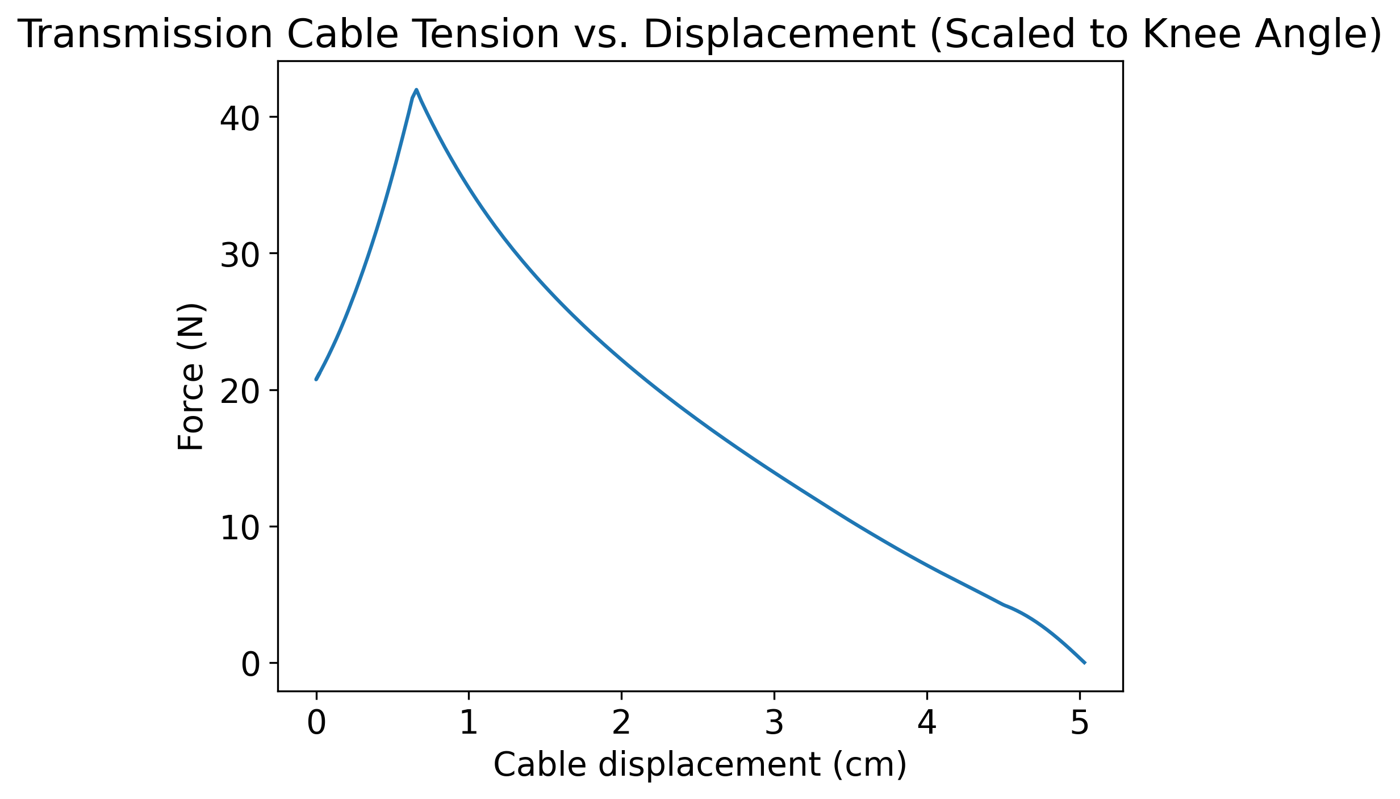
results/forces/forces_2026-09-17/force_plot_unscaled_65.png
