stephan-stansfield/cam-mech/CAD/benchtop-prototype/drawings/thrust-bearing-outer.pdf

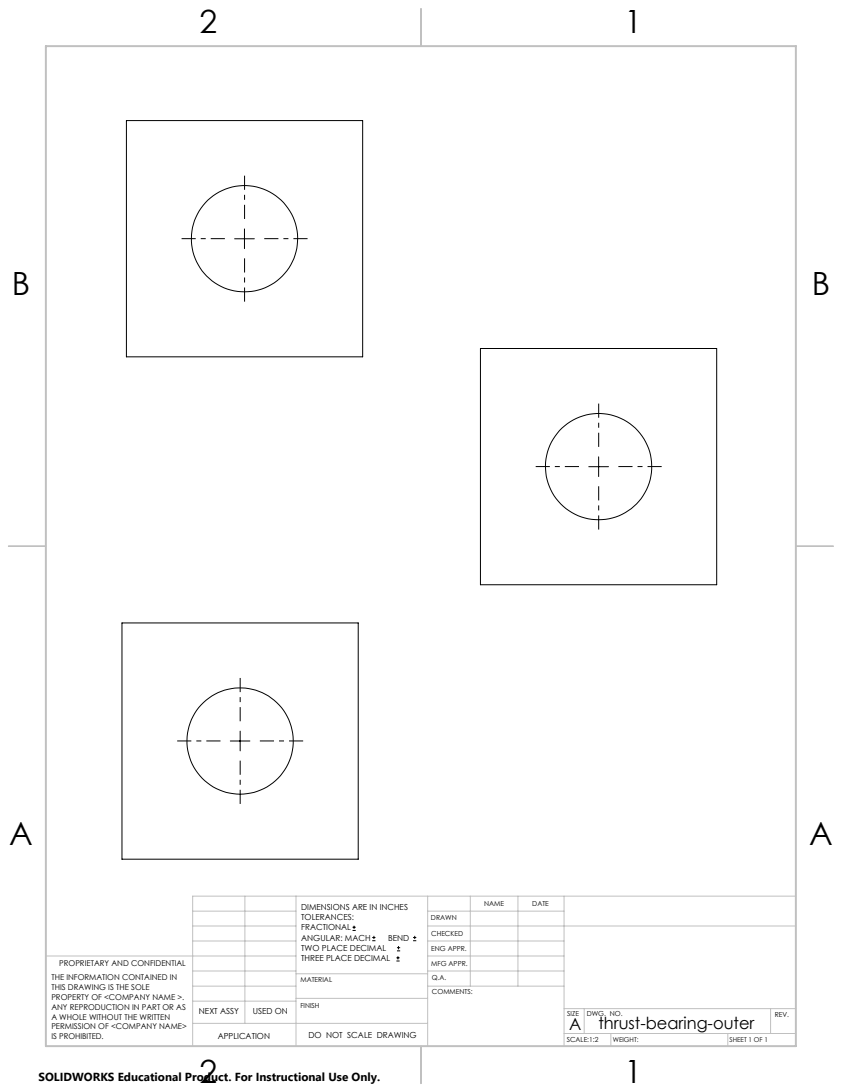
[picture p190: page 1]

TOLERANCES: FRACTIONAL ANGULAR: MACH BEND TWO PLACE DECIMAL THREE PLACE DECIMAL | | NAME | DATE DIMENSIONS ARE IN INCHES

DRAWN
CHECKED
ENG APPR.

PROPRIETARY AND CONFIDENTIAL THE INFORMATION CONTAINED IN THIS DRAWING IS THE SOLE PROPERTY OF <COMPANY NAME >. ANY REPRODUCTION IN PART OR AS A WHOLE WITHOUT THE WRITTEN PERMISSION OF <COMPANY NAME> IS PROHIBITED. | | | MFG APPR.

MATERIAL | Q.A.

NEXT ASSY | USED ON | FINISH

SIZE A | DWG. NO. thrust-bearing-outer | REV.

APPLICATION | | DO NOT SCALE DRAWING

SCALE:1:2 | WEIGHT: | SHEET 1 OF 1

SOLIDWORKS Educational Product. For Instructional Use Only.
