stephan-stansfield/cam-mech/CAD/benchtop-prototype/asm-benchtop-device-no-switching.pdf

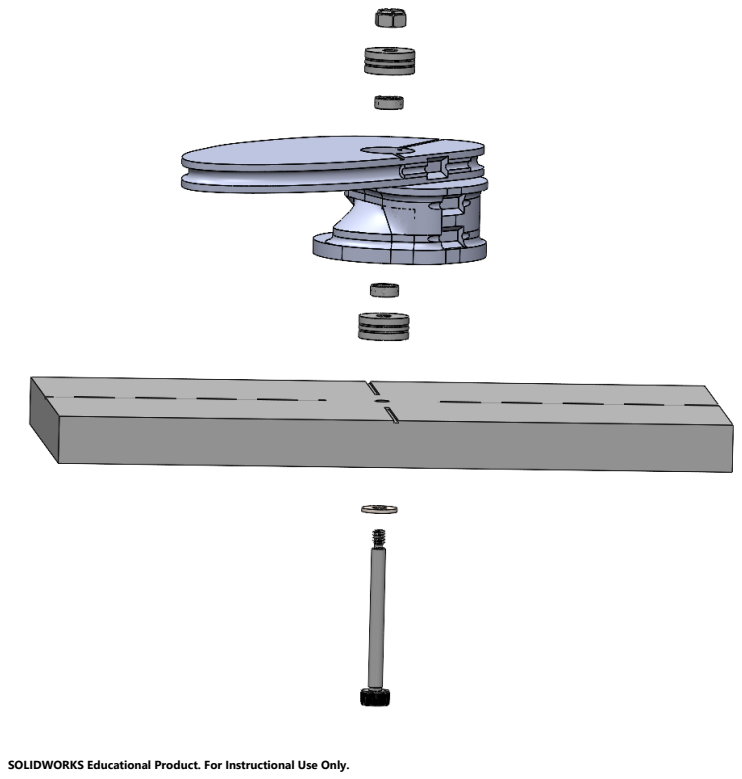
[picture p191: page 1]

SOLIDWORKS Educational Product. For Instructional Use Only.
