stephan-stansfield/cam-mech/CAD/Cam Mechanism CAD 12-2022/prototyping/Prototyping Profiles.pdf

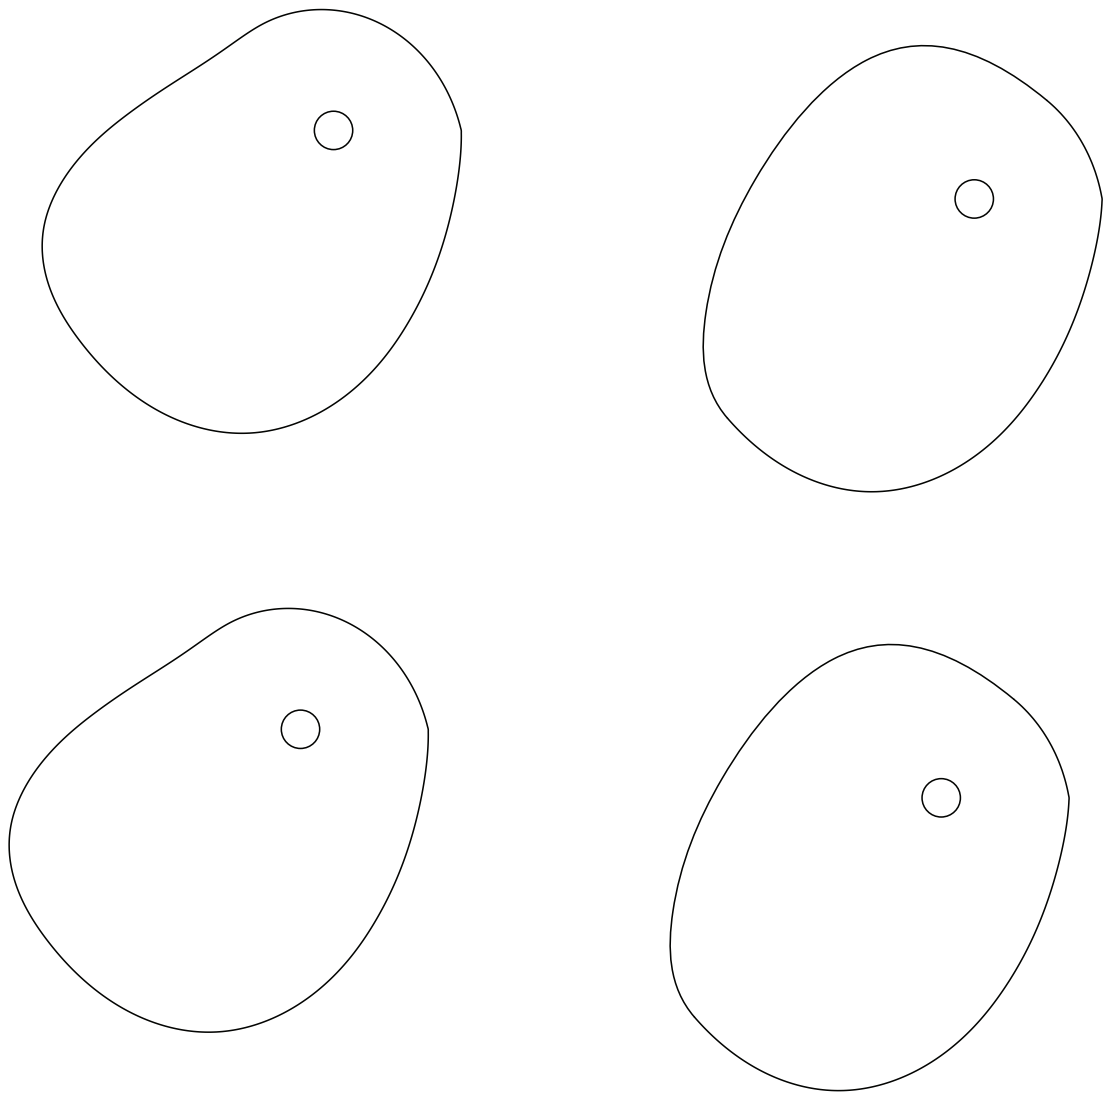
[picture p192: page 1]
