stephan-stansfield/cam-mech/(commit log)

2023-07-10 implement asymmetric cable force profile with peak force at 32.5% of stance
    [force_output.csv]
2023-07-26 add CAD folder
    [57155K323_Stainless Steel Ball Bearing.SLDPRT, 8632T139_D-Profile Rotary Shaft.SLDPRT, 9414T6_Set Screw Shaft Collar.SLDPRT, Mirrorinner_cam.SLDPRT, Mirrorinner_cam_cover.SLDPRT, Mirrorouter_cam.SLDPRT, Mirrorouter_cam_cover.SLDPRT, asm_expanding-pulley.SLDASM]
2023-07-31 add expanding pulley first working assembly proof of concept
    [asm_expanding-pulley.SLDASM, pulley-disc.SLDPRT, pulley-slider.SLDPRT, pulley-slot.SLDPRT]
2023-08-03 Add prototyping folder with inner cam profiles for foam prototyping. Add expanding pulley with one asymmetric slider.
    [57155K323_Stainless Steel Ball Bearing.SLDPRT, 8632T139_D-Profile Rotary Shaft.SLDPRT, 9414T6_Set Screw Shaft Collar.SLDPRT, Mirrorinner_cam.SLDPRT, Mirrorouter_cam.SLDPRT, asm_expanding-pulley-asymmetric.SLDASM, asm_expanding-pulley.SLDASM, cam_assembly_sandbox.SLDASM]
2023-09-01 update cam shapes
    [asm_expanding-pulley-asymmetric.SLDASM, assembly-check-2023-08-09.SLDASM, idler_pulley_blank.DXF, idler_pulley_blank.SLDPRT, inner_cam_profile.SLDPRT, inner_cam_profile_2.SLDPRT, inner_cam_profile_2023-08-09.DXF, inner_cam_profile_2023-08-09.SLDPRT]
2023-09-12 add bistable switch with clearance
    [asm_switch.SLDASM, body.stl, shaft.stl, step.stl, stepv2.stl, switch-base.SLDPRT, switch-base.STL, switch-hinge.SLDPRT]
2023-09-13 bistable switch with surfaced cam as of 9/13/23
    [asm_cam_switch.SLDASM, cam_bistable_proto.SLDPRT]
2023-11-07 remove two keypoints for simpler kinematics
2023-11-13 produce bistable mech kinematics that are feasible for prototyping
2023-11-13 update standalone bistable mechanism with dimensions from optimization
    [asm_cam_switch.SLDASM, asm_switch.SLDASM, cam_bistable_proto.SLDPRT, switch-base.SLDPRT, switch-base.STL, switch-hinge.SLDPRT, switch-hinge.STL, switch-toggle.SLDPRT]
2023-11-14 create derailleur and assembly (WIP)
    [asm_cam_switch.SLDASM, asm_derailleur-prototype.SLDASM, asm_switch.SLDASM, cam_bistable_proto.SLDPRT, derailleur.SLDPRT, switch-base.SLDPRT, switch-hinge.SLDPRT, switch-toggle.SLDPRT]
2023-11-14 add calc for input switch dx & dy
2023-11-16 combine bistable switch with sloped cam geometry (WIP)
    [asm_derailleur-prototype.SLDASM, cam_bistable_proto.SLDPRT, derailleur.SLDPRT, switch-base.SLDPRT, switch-toggle.SLDPRT]
2023-11-16 edit derailleur slopes to potential working shape
    [asm_cam_switch.SLDASM, asm_derailleur-prototype.SLDASM, asm_switch.SLDASM, cam_bistable_proto.SLDPRT, derailleur.SLDPRT, switch-hinge.SLDPRT, switch-toggle.SLDPRT]
2023-11-17 update CAD for assembly test print
    [asm_derailleur-prototype.SLDASM, cam_bistable_proto.SLDPRT, cam_bistable_proto.STL, derailleur.SLDPRT, derailleur.STL, switch-base.SLDPRT, switch-base.STL, switch-hinge.SLDPRT]
2023-12-01 WIP bistable switching design for first print attempt
    [asm_derailleur-prototype.SLDASM, cam_bistable_proto.SLDPRT, derailleur.SLDPRT, derailleur_1.STL, switch-hinge.SLDPRT, switch-hinge.STL, switch-hinge_1.STL, switch-toggle.STL]
2023-12-05 updates before prototype re-print 2023-12-05
    [asm_derailleur-prototype.SLDASM, cam_bistable_proto.SLDPRT, cam_bistable_proto.STL, switch-base.SLDPRT, switch-base.STL, switch-hinge.SLDPRT, switch-hinge.STL, switch-toggle.SLDPRT]
2024-01-17 modify for better manufacturability. add screws and nuts.
    [90480A003_Low-Strength Steel Hex Nut.SLDPRT, 91251A081_Black-Oxide Alloy Steel Socket Head Screw.SLDPRT, asm_cam-and-derailleur.SLDASM, asm_cam_switch.SLDASM, asm_derailleur-prototype.SLDASM, asm_switch.SLDASM, cam_bistable_proto.SLDPRT, derailleur.SLDPRT]
2024-01-18 update cam and switch base geometry before print. reorganize file structure.
    [57155K323_Stainless Steel Ball Bearing.SLDPRT, 8632T139_D-Profile Rotary Shaft.SLDPRT, 9414T6_Set Screw Shaft Collar.SLDPRT, Mirrorinner_cam.SLDPRT, Mirrorinner_cam_cover.SLDPRT, Mirrorouter_cam.SLDPRT, Mirrorouter_cam_cover.SLDPRT, asm_cam-and-derailleur.SLDASM]
2024-01-25 reversed direction of derailleur slopes
    [asm_cam-and-derailleur.SLDASM, cam_bistable_proto.SLDPRT, derailleur.SLDPRT]
2024-01-25 adjust height of inner track sloped surface
    [asm_cam-and-derailleur.SLDASM, derailleur.SLDPRT]
2024-01-30 adjust derailleur inner slope height. add chamfers and fillets to derailler edges
    [asm_cam-and-derailleur.SLDASM, asm_switch.SLDASM, cam_bistable_proto.SLDPRT, derailleur.SLDPRT]
2024-01-31 save copy of scaled model before scaling down to actual size
    [90480A003_Low-Strength Steel Hex Nut.SLDPRT, 91251A081_Black-Oxide Alloy Steel Socket Head Screw.SLDPRT, asm_cam-and-derailleur.SLDASM, asm_cam_switch.SLDASM, asm_derailleur-prototype.SLDASM, asm_switch.SLDASM, cam_bistable_proto.SLDPRT, cam_bistable_proto.STL]
2024-02-01 modified cable groove diameter. added sketch to dimension distance between grooves
    [asm_cam-and-derailleur.SLDASM, asm_switch.SLDASM, cam_bistable_proto.SLDPRT]
2024-02-01 modify bistable switch optimization for scaled down part and smaller EE x-travel.
2024-02-01 change dimensions in switch base and hinge according to optimization values from 2024-02-01 (WIP)
    [asm_cam-and-derailleur.SLDASM, asm_switch.SLDASM, switch-base.SLDPRT, switch-hinge.SLDPRT, switch-toggle.SLDPRT]
2024-02-05 scale down mechanism WIP
    [asm_cam-and-derailleur.SLDASM, asm_switch.SLDASM, cam_bistable_proto.SLDPRT, derailleur.SLDPRT, switch-base.SLDPRT, switch-hinge.SLDPRT, switch-toggle.SLDPRT]
2024-02-22 reorganize CAD files. initial commit single-piece flexure part
    [BistableSwitch.dxf, Bistable_Switch.STL, body.stl, shaft.stl, step.stl, stepv2.stl, switch-flexures.SLDPRT, switch.stl]
2024-02-22 first pass at single-piece compliant bistable switch (WIP)
    [switch-flexures.SLDPRT]
2024-02-23 make dimensions of single piece flexure switch more manufacturable. add cable groove and nut flat holder. WIP
    [switch-flexures.SLDPRT]
2024-02-23 add second configuration to single piece flexure switch. WIP
    [switch-flexures.SLDPRT]
2024-02-26 updated geometry before adding living hinges. WIP
    [switch-flexures.SLDPRT]
2024-02-26 rough geometry with living hinges. WIP
    [switch-flexures.SLDPRT]
2024-02-26 rearrange files. Refine geometry of single-piece switch. WIP
    [90480A003_Low-Strength Steel Hex Nut.SLDPRT, 91251A081_Black-Oxide Alloy Steel Socket Head Screw.SLDPRT, asm_cam-and-derailleur.SLDASM, asm_cam_switch.SLDASM, asm_derailleur-prototype.SLDASM, asm_switch.SLDASM, cam_bistable_proto.SLDPRT, derailleur.SLDPRT]
2024-02-27 integrate single-piece compliant switch with assembly. extend base footprint and add second slot and hole for fastening. WIP
    [90480A003_Low-Strength Steel Hex Nut.SLDPRT, asm_cam-and-derailleur.SLDASM, cam_bistable_proto.SLDPRT, derailleur.SLDPRT, switch-flexures.SLDPRT]
2024-02-29 draw compliant switch in up configuration. draw living hinges in slightly deformed shape. create .STL for trial 3D print. WIP
    [switch-flexures-down-config.SLDPRT, switch-flexures.SLDPRT, switch-flexures.STL]
2024-02-29 increase cable groove diameter
    [switch-flexures.SLDPRT]
2024-02-29 thicken arms to 1.5 mm. re-draw living hinges.
    [switch-flexures.SLDPRT]
2024-03-01 re-draw living hinges to be symmetric and centered about pin joints. thicken arms and base.
    [switch-flexures-down-config.SLDPRT, switch-flexures-down-config.STL, switch-flexures.SLDPRT, switch-flexures.STL]
2024-03-02 update inner cam geometry to line up with compliant switch (WIP)
    [asm_cam-and-derailleur.SLDASM, cam_bistable_proto.SLDPRT, cam_inner.SLDPRT, switch-flexures.SLDPRT]
2024-03-05 break convex hull cams into monotonically increasing arrays to allow interpolation. squash extant bugs. WIP.
    [force_output.csv]
2024-03-05 add screws to assembly
    [asm_cam-and-derailleur.SLDASM, cam_bistable_proto.SLDPRT, derailleur.SLDPRT, switch-flexures.SLDPRT]
2024-03-08 cam optimization running
    [force_output.csv]
2024-03-14 cam optimization running to end without timing out. resultant shapes still not ideal. WIP
    [force_output.csv]
2024-03-14 clean up code; decision variables only based on gear ratios
    [force_output.csv]
2024-03-21 let stance percentages vary as decision variables in optimization
    [force_output.csv]
2024-03-22 add inequality constraints and change population and generation size. results are a large batch of feasible solutions.
    [force_output.csv]
2024-03-29 refactor code for readability and accuracy. WIP
    [force_output.csv, input_array.csv, results_array.csv]
2024-04-19 resolve several bugs from refactoring and change interpolation type of initial points. WIP.
    [force_output.csv, input_array.csv, results_array.csv]
2024-05-03 debug cam_class_optimization.py code after refactor
    [force_output.csv]
2024-05-30 fix sit angle and cable offset issues. successfully save plots to dated subfolder
    [force_output.csv, input_array.csv, results_array.csv]
2024-05-31 save cam point clouds to text files in sub-folder
    [force_output.csv, input_array.csv, results_array.csv]
2024-06-05 produce updated plots after updating stroke code
    [force_output.csv, input_array.csv, results_array.csv]
2024-06-05 run with stroke derived from average older adult height
    [force_output.csv, input_array.csv, results_array.csv]
2024-06-13 fix elastic element offset angle implementation. improve readability of cam plots.
    [force_output.csv, force_plots_2024-06-12force_output.csv, force_plots_2024-06-12results_array.csv, force_plots_2024-06-13force_output.csv, force_plots_2024-06-13results_array.csv, input_array.csv, results_array.csv]
2024-06-13 update results
    [_force_output.csv, _input_array.csv, _results_array.csv]
2024-06-13 update to output both inner and outer cam point clouds
    [_force_output.csv, _input_array.csv, _results_array.csv]
2024-06-14 import cam point clouds to SolidWorks
    [cam_storage.SLDPRT, cam_transmission.SLDPRT]
2024-06-14 clean up unused files and outdated results
    [_force_output.csv, _input_array.csv, _results_array.csv]
2024-07-03 interim results from code development
    [_force_output.csv]
2024-07-09 change objective function for stand-to-sit cam to be based on minimizing max. force
    [_force_output.csv]
2024-07-11 update stand-to-sit cam generation to be convex and obey end constraints
    [_force_output.csv]
2024-07-12 import cam point clouds to Solidworks as curves. fix typos in results file and folder names
    [cam_curve_transmission.SLDPRT, cam_curve_transmission_si2st.SLDPRT, cam_curve_transmission_st2si.SLDPRT, cam_transmission_si2st.SLDPRT, cam_transmission_st2si.SLDPRT]
2024-07-15 initial commit. create transmission cam CAD part (WIP)
    [cam_transmission.SLDPRT]
2024-07-15 update bistable switch optimization for new cam shapes. change images folder to solutions. clean up some comments
2024-07-15 work on updated cam CAD (WIP)
    [asm_benchtop-device.SLDASM, cam_bistable_proto.SLDPRT, cam_transmission.SLDPRT, cam_transmission_si2st.SLDPRT, cam_transmission_st2si.SLDPRT, switch-flexures.SLDPRT, switch-flexures_scaled-ref.SLDPRT]
2024-07-16 add global variables to cam CAD (WIP)
    [cam_transmission.SLDPRT]
2024-07-16 add first-pass cam slope surface (WIP)
    [cam_transmission.SLDPRT]
2024-07-16 create two slopes (WIP)
    [cam_transmission.SLDPRT]
2024-07-17 make both slopes smooth (WIP)
    [cam_transmission.SLDPRT]
2024-07-17 adjust slope up lower boundary
    [cam_transmission.SLDPRT]
2024-07-18 smooth all slopes and add small fillets (WIP)
    [cam_transmission.SLDPRT]
2024-07-22 make lip of top groove for down slope continuous (WIP)
    [cam_transmission.SLDPRT]
2024-07-22 adjust bistable switch input dimensions. save new results.
2024-07-22 debug outputs of sit-to-stand cam generation (WIP)
    [_force_output.csv, _input_array.csv, _results_array.csv]
2024-07-29 alter groove profiles to be more continuous (WIP)
    [cam_transmission.SLDPRT]
2024-07-29 fix groove profiles. pre-slope (WIP)
    [cam_transmission.SLDPRT]
2024-07-30 finish sloped surfaces with half-open cable grooves. create STEP file to 3D print
    [cam_transmission.SLDPRT, cam_transmission.STEP]
2024-08-01 update bistable switch optimization dimensions
2024-08-01 update flexure dimensions. test 3D print
    [cam_transmission.SLDPRT, cam_transmission.STEP, switch-flexures.SLDPRT, switch-flexures.STEP]
2024-08-01 update switch CAD after test 3D print to avoid collision with EE arm
    [cam_transmission.STEP, switch-flexures.SLDPRT, switch-flexures.STEP, switch-flexures_rev1.STEP]
2024-08-02 begin to alter cam geometry to allow integration of bistable switch (WIP)
    [asm_benchtop-device.SLDASM, cam_transmission.SLDPRT, cam_transmission_recover.SLDPRT, switch-flexures.SLDPRT]
2024-09-23 continue to update cam transmission geometry (WIP)
    [cam_transmission.SLDPRT]
2024-09-23 add one sloped surface to updated transmission cam geometry (WIP)
    [cam_transmission.SLDPRT]
2024-09-25 alter slope boundary definition to create solid slope from knit (WIP)
    [cam_transmission.SLDPRT, cam_transmission_boundary-test.STL]
2024-09-25 remove zero-thickness geometry
    [cam_transmission.SLDPRT, cam_transmission_boundary-test.STL]
2024-09-25 create new cam transmission part that uses reference sketches for cam shapes
    [cam_transmission.SLDPRT, cam_transmission_altered_curves.SLDPRT]
2024-09-25 adding features to new transmission cam part
    [cam_transmission_altered_curves.SLDPRT]
2024-09-25 create both cable grooves (WIP)
    [cam_transmission.SLDPRT, cam_transmission_altered_curves.SLDPRT]
2024-09-26 extend stand-to-sit groove cut fully
    [cam_transmission_altered_curves.SLDPRT]
2024-09-26 extend sit-to-stand groove cut fully
    [cam_transmission_altered_curves.SLDPRT]
2024-09-26 create both sloped surfaces
    [cam_transmission_altered_curves.SLDPRT]
2024-09-26 replace cam_transmission.SLDPRT with new transmission cam with altered geometry. delete outdated files
    [asm_benchtop-device.SLDASM, cam_transmission.SLDPRT, cam_transmission_altered_curves.SLDPRT, cam_transmission_boundary-test.STL, cam_transmission_recover.SLDPRT]
2024-09-26 rename files for clarity
    [cam_transmission_curve_si2st.SLDPRT, cam_transmission_curve_st2si.SLDPRT, cam_transmission_curves.SLDPRT]
2024-09-26 fix one of the slope boundaries (WIP)
    [asm_benchtop_device.SLDASM, cam_transmission.SLDPRT, switch-flexures.SLDPRT]
2024-09-26 fix both sloped surfaces
    [cam_transmission.SLDPRT]
2024-09-26 add cutout to transmission cam. add bistable switch to assembly (WIP)
    [asm_benchtop_device.SLDASM, cam_transmission.SLDPRT, switch-flexures.SLDPRT]
2024-09-27 integrating bistable switch and derailleur geometry (WIP)
    [asm_benchtop_device.SLDASM, asm_cam-and-derailleur.SLDASM, cam_bistable_proto.SLDPRT, cam_transmission.SLDPRT, derailleur.SLDPRT, derailleur_ref.SLDPRT, switch-flexures.SLDPRT, switch-flexures_no-toggles.SLDPRT]
2024-10-10 begin to update derailleur CAD to actual-size dimensions (WIP)
    [asm_benchtop_device.SLDASM, cam_transmission.SLDPRT, derailleur.SLDPRT, switch-flexures.SLDPRT]
2024-10-10 update derailleur ramps and bistable up-to-down switching surface geometry (WIP)
    [asm_benchtop_device.SLDASM, derailleur.SLDPRT, switch-flexures.SLDPRT]
2024-10-28 make changes to derailleur slopes, working toward integration with new cam geometry (WIP)
    [asm_benchtop_device.SLDASM, derailleur.SLDPRT]
2024-10-28 alter derailleur slopes and bistable switch to avoid interference. merge cam and switch parts to test 3D print (WIP)
    [NewPart^asm_benchtop_device.3mf, NewPart^asm_benchtop_device.STEP, NewPart^asm_benchtop_device.STL, asm_benchtop_device.SLDASM, cam_transmission.SLDPRT, derailleur.SLDPRT, switch-flexures.SLDPRT]
2024-11-01 edit shapes for better 3D printing
    [asm_benchtop_device.SLDASM, cam_transmission.SLDPRT, derailleur.STEP, switch-flexures.SLDPRT]
2024-11-01 update parts for 3D printing
    [NewPart^asm_benchtop_device.STEP, asm_benchtop_device.SLDASM, cam_transmission.SLDPRT, switch-flexures.SLDPRT, switch-flexures.STEP]
2024-11-07 made edits following 3D print test. lower up-to-down deraileur height. increase diameter of down-to-up derailleur and increase cantilever length.
    [NewPart^asm_benchtop_device.STEP, asm_benchtop_device.SLDASM, cam_transmission.SLDPRT, derailleur.SLDPRT, derailleur.STEP, switch-flexures.SLDPRT, switch-flexures.STEP]
2024-11-08 make small changes after failed print. remove lip at edge of switch cavity and fillet corners. label some switch-flexures tree items.
    [asm_benchtop_device.SLDASM, cam_transmission.SLDPRT, switch-flexures.SLDPRT]
2024-11-12 modify for test 3D print with filaments aligned across living hinges
    [NewPart^asm_benchtop_device.STEP, asm_benchtop_device.SLDASM, switch-flexures.SLDPRT, switch-flexures.STEP]
2024-11-15 add boss to flexure switch for better standalone testing. create two switches with different flexure widths. file cleanup.
    [asm_benchtop_device.SLDASM, cam_transmission.SLDPRT, cam_transmission_curve_si2st.SLDPRT, cam_transmission_curve_st2si.SLDPRT, cam_transmission_curves.SLDPRT, derailleur.SLDPRT, derailleur_ref.SLDPRT, switch-flexures.SLDPRT]
2024-11-15 create 3 different flexure widths from 0.65 mm to 0.85 mm to test print bistable switch
    [switch-flexures_0-125in-thick_0-50mm-flex.STEP, switch-flexures_0-125in-thick_0-60mm-flex.SLDPRT, switch-flexures_0-125in-thick_0-60mm-flex.STEP, switch-flexures_0-125in-thick_0-65mm-flex.SLDPRT, switch-flexures_0-125in-thick_0-65mm-flex.STEP, switch-flexures_0-125in-thick_0-75mm-flex.STEP, switch-flexures_0-125in-thick_0-85mm-flex.SLDPRT, switch-flexures_0-125in-thick_0-85mm-flex.STEP]
2024-11-20 add sketch showing switch angle
    [cam_transmission.SLDPRT]
2024-11-21 reinforce switch cantilever
    [asm_benchtop_device.SLDASM, switch-flexures.SLDPRT]
2024-11-22 reinforce cantilever. reinforce side mounts. create test prints with three switch thicknesses from 1/8 in to 1/4 in.
    [asm_benchtop_device.SLDASM, switch-flexures.SLDPRT, switch-flexures_0-125in-thick_0-50mm-flex.SLDPRT, switch-flexures_0-125in-thick_0-60mm-flex.SLDPRT, switch-flexures_0-125in-thick_0-65mm-flex.SLDPRT, switch-flexures_0-125in-thick_0-65mm-flex.STEP, switch-flexures_0-125in-thick_0-75mm-flex.SLDPRT, switch-flexures_0-125in-thick_0-85mm-flex.SLDPRT]
2024-11-22 change switch cantilever angle. create 3 new test switches to 3D print.
    [asm_benchtop_device.SLDASM, switch-flexures.SLDPRT, switch-flexures_0-125in-thick_0-65mm-flex.SLDPRT, switch-flexures_0-125in-thick_0-65mm-flex.STEP, switch-flexures_0-1875in-thick_0-65mm-flex.SLDPRT, switch-flexures_0-1875in-thick_0-65mm-flex.STEP, switch-flexures_0-25in-thick_0-65mm-flex.SLDPRT, switch-flexures_0-25in-thick_0-65mm-flex.STEP]
2025-09-30 save before update to make assembly with separate cam and switch pieces
    [asm_benchtop_device.SLDASM, cam_transmission.SLDPRT, derailleur.SLDPRT, switch-flexures.SLDPRT, switch-flexures_.SLDPRT, switch-flexures_0-1875in-thick_0-65mm-flex.SLDPRT, switch-flexures_standalone.SLDPRT, switch-flexures_standalone.STEP]
2025-10-01 make switch and cam separate parts, connectable by screws. first rough pass for feasibility
    [asm_benchtop_device.SLDASM, asm_switch.SLDASM, cam_transmission.SLDPRT, cam_transmission.STEP, derailleur.SLDPRT, derailleur.STEP, switch-base.SLDPRT, switch-flexures-separate.SLDPRT]
2025-10-03 update geometry for separate cam and switch after first test print. move slot away from axle hole, increase screw size to M2, add diagonal supports to flange
    [asm_benchtop_device.SLDASM, cam_transmission.SLDPRT, cam_transmission.STEP, derailleur.SLDPRT, derailleur.STEP, switch-flexures-separate.SLDPRT, switch-flexures-separate.STEP]
2025-10-06 "add contraints to optimization to produce bistable switch with better cantilever orientation"
2025-10-06 update CAD for new bistable switch geometry (WIP)
    [switch-flexures-separate-v2.SLDPRT, switch-flexures-separate.SLDPRT, switch-flexures.SLDPRT, switch-flexures_.SLDPRT, switch-flexures_0-125in-thick_0-65mm-flex.SLDPRT, switch-flexures_0-1875in-thick_0-65mm-flex.SLDPRT, switch-flexures_0-25in-thick_0-65mm-flex.SLDPRT, switch-flexures_wall.SLDPRT]
2025-10-07 add geometry around new bistable switch skeleton (WIP)
    [asm-benchtop-device_v1.SLDASM, asm-benchtop-device_v2.SLDASM, asm_benchtop_device.SLDASM, cam-transmission_v1.SLDPRT, cam-transmission_v2.SLDPRT, cam_transmission.SLDPRT, derailleur.SLDPRT, derailleur_v1.SLDPRT]
2025-10-09 adjust cantilevers and ramps after first print (WIP)
    [asm-benchtop-device_v2.SLDASM, cam-transmission_v2.SLDPRT, cam-transmission_v2.STEP, derailleur_v2.SLDPRT, derailleur_v2.STEP, switch-flexures-separate_v2.SLDPRT, switch-flexures-separate_v2.STEP]
2025-10-14 update new bistable switch geometry. create new standalone one-piece version for debugging compliant mechanism (WIP)
    [asm-benchtop-device_v2.SLDASM, cam-transmission_v2.SLDPRT, cam-transmission_v2.STEP, derailleur_v2.STEP, switch-flexures-separate_v2.SLDPRT, switch-flexures-separate_v2.STEP, switch-flexures-separate_v2_one-piece.SLDPRT, switch-flexures-separate_v2_one-piece.STEP]
2025-10-14 modify one-piece flexure to orient living hinges halfway between the two link angles of the stable equilibrium positions
    [switch-flexures-separate_v2_one-piece.SLDPRT, switch-flexures-separate_v2_one-piece.STEP]
2025-10-14 add spring-like element to one of the links to aid in bistability snapping (WIP)
    [switch-flexures-separate_v2_one-piece-spring-link.SLDPRT, switch-flexures-separate_v2_one-piece-spring-link.STEP, switch-flexures-separate_v2_one-piece.SLDPRT]
2025-10-15 add link with compliant section (spring) to bistable switch (WIP)
2025-10-17 add off-the-shelf bearings to assembly
    [57155K346_Stainless Steel Ball Bearing.SLDPRT, 98410A111_External Retaining Ring.SLDPRT, asm-benchtop-device_v2.SLDASM, cam-transmission_v2.SLDPRT, derailleur_v2.SLDPRT, switch-flexures-separate_v2.SLDPRT, switch-flexures-separate_v2_one-piece-spring-link.SLDPRT, switch-flexures-separate_v2_one-piece-spring-link.STEP]
2025-10-17 update python environment. run optimization with Fmax=100N, K=100 N/m and K=200 N/m.
    [_force_output.csv, _force_output.xlsx, _force_output0.csv, _force_output1.csv, _force_output10.csv, _force_output100.csv, _force_output101.csv, _force_output102.csv]
2025-10-17 revert to switch with all living hinges
    [switch-flexures-separate_v2_one-piece-spring-link.SLDPRT]
2025-10-17 integrate updated switch geometry with transmission cam (WIP)
    [asm-benchtop-device_v2-ref101725.SLDASM, asm-benchtop-device_v2.SLDASM, cam-transmission_v2.SLDPRT, cam-transmission_v2.STEP, switch-flexures-separate_v2.SLDPRT, switch-flexures-separate_v2_one-piece-spring-link.SLDPRT, switch-flexures-separate_v2_one-piece-spring-link.STEP]
2025-10-18 update CAD after printing new switch geometry with flanges. Change flanges to be connected by a solid piece in the middle. Widen ejection holes. (WIP)
    [asm-benchtop-device_v2.SLDASM, cam-transmission_v2.SLDPRT, derailleur_v2.SLDPRT, switch-flexures-separate_v2_one-piece-spring-link.SLDPRT]
2025-10-18 clean up working directory and file names. further minor updates to geometry before 3D printing (WIP)
    [asm-benchtop-device.SLDASM, asm-benchtop-device_v1.SLDASM, asm-benchtop-device_v2-ref101725.SLDASM, asm-benchtop-device_v2.SLDASM, cam-transmission.SLDPRT, cam-transmission.STEP, cam-transmission_v1.SLDPRT, cam-transmission_v2.SLDPRT]
2025-10-19 integrate storae cam with transmission cam (WIP)
    [asm-benchtop-device.SLDASM, asm-cams.SLDASM, asm-cams.STEP, cam-transmission.SLDPRT, cam_storage.SLDPRT, cams-joined^asm-cams.STEP, derailleur.SLDPRT, switch.SLDPRT]
2025-10-20 Move position of up-to-down cantilever to enable more travel of hook link in transition. Change hook geometry to leave room for cable wrapping when in down groove. Update derailleur ramp geometry to 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
    [asm-benchtop-device.SLDASM, asm-cams.SLDASM, cam-transmission.SLDPRT, cam-transmission.STEP, cam_storage.SLDPRT, cams-joined^asm-cams.STEP, derailleur.SLDPRT, derailleur.STEP]
2025-10-21 minor show/hide updates
    [asm-benchtop-device.SLDASM, switch.SLDPRT]
2025-10-21 add cable stops (1st attempt)
    [3926T43_Wire Rope Stops-Not for Lifting.SLDPRT, asm-benchtop-device.SLDASM, asm-cams.SLDASM, cam-storage.SLDPRT, cam-transmission.SLDPRT, derailleur.SLDPRT, switch.SLDPRT]
2025-10-21 incorporate cable stops (2nd attempt). Remove material from switch wall that lines up with living hinges
    [asm-benchtop-device.SLDASM, asm-cams.SLDASM, asm-cams.STEP, cam-storage.SLDPRT, cam-transmission.SLDPRT, cams-joined^asm-cams.STEP, switch.SLDPRT, switch.STEP]
2025-10-22 create storage cable jig and add to experimental setup assembly (WIP)
    [3013T45_Steel Eyebolt without Shoulder - for Lifting.SLDPRT, 3926T43_Wire Rope Stops-Not for Lifting.SLDPRT, asm-benchtop-device.SLDASM, asm-cams.SLDASM, cam-storage.SLDPRT, cam-transmission.SLDPRT, cams-compound.SLDPRT, derailleur-jig.SLDPRT]
2025-10-22 extend derailleur axle height and add cutout for retaining ring.
    [asm-cams.SLDASM, cam-storage.SLDPRT, cam-transmission.SLDPRT, derailleur-jig.SLDPRT, switch.SLDPRT]
2025-10-22 alter switch geometry: change compliant link to be at a 15-degree angle from horizontal in the 'up' position to encourage more poppy behavior from up to down
    [asm-cams.SLDASM, cam-storage.SLDPRT, cam-transmission.SLDPRT, derailleur.SLDPRT, switch.SLDPRT, switch.STEP]
2025-10-23 create first iteration of KUKA LBR iiwa end effector to connect cable loop to
    [base_gripper.SLDPRT, kuka-end-effector.SLDPRT, kuka-end-effector.STEP]
2025-10-23 create switches with various number of living hinges angled to test effect on snap between stable equilibrium positions
    [asm-cams.STEP, cams-joined^asm-cams.STEP, switch-one-hinge-angled.SLDPRT, switch-one-hinge-angled.STEP, switch-three-hinges-angled.SLDPRT, switch-three-hinges-angled.STEP, switch-two-hinges-angled.SLDPRT, switch-two-hinges-angled.STEP]
2025-10-24 updated kuka end effector hook geometry
    [3018T14_Galvanized Steel Eyebolt with Nut and with Shoulder.SLDPRT, asm-cams.SLDASM, cam-storage.SLDPRT, cam-transmission.SLDPRT, derailleur-jig.SLDPRT, kuka-end-effector.SLDPRT, storage-cable-jig.SLDDRW, storage-cable-jig.SLDPRT]
2025-10-24 chamfer bearing holes. update benchtop storage cable jig.
    [asm-benchtop-device.SLDASM, asm-cams.SLDASM, cable-sleeve-test.SLDPRT, cable-sleeve-test.STEP, cam-storage.SLDPRT, cam-transmission.SLDPRT, cam_storage.SLDPRT, derailleur-jig.SLDPRT]
2025-10-25 rotate storage cam 180 degrees so that cables leave cam in both directions. update cable sleeve tester part and apply best fit sleeve insert to cams.
    [asm-cams.SLDASM, cable-sleeve-test.SLDPRT, cable-sleeve-test.STEP, cam-storage.SLDPRT, cam-transmission.SLDPRT, cams-joined^asm-cams.STEP, derailleur-jig.SLDPRT, derailleur-jig.STEP]
2025-10-25 update switch geometry to place root of up-to-down cantilever closer to joint (unsuccessful attempt). increase height of up-to-down derailleur ramp
    [asm-benchtop-device.SLDASM, cam-transmission.SLDPRT, derailleur.SLDPRT, derailleur.STEP, switch.SLDPRT, switch.STEP]
2025-10-26 update switch to move cantilever force application point closer to the hinge (WIP)
    [asm-benchtop-device.SLDASM, asm-cams.SLDASM, cam-transmission.SLDPRT, derailleur-jig.SLDPRT, derailleur.SLDPRT, derailleur.STEP, switch-one-hinge-angled.SLDPRT, switch-one-hinge-angled.STEP]
2025-10-26 try moving cantilever to far end of switch, enabling taller derailleur ramp to be used due to clearance with rest of switch
    [asm-benchtop-device.SLDASM, asm-cams.SLDASM, cam-transmission.SLDPRT, cam-transmission.STEP, derailleur-wide.SLDPRT, derailleur-wide.STEP, derailleur.SLDPRT, switch-one-hinge-up-one-down.SLDPRT]
2025-10-26 increase up-to-down derailleur ramp height to 7.5 mm
    [asm-benchtop-device.SLDASM, derailleur-wide.SLDPRT]
2025-10-26 increase size of section at end of rightmost living hinge
    [asm-benchtop-device.SLDASM, cam-transmission.SLDPRT, derailleur-wide-7_5mm.STEP, switch-wide-cantilever-long-hinge.SLDPRT, switch-wide-cantilever-long-hinge.STEP, switch-wide-cantilever.SLDPRT, switch-wide-cantilever.STEP]
2025-10-26 add 'tail' to cantilever to increase contact time with derailleru ramp
    [asm-benchtop-device.SLDASM, cam-transmission.SLDPRT, derailleur-wide.SLDPRT, derailleur-wide.STEP, switch-one-hinge-up-one-down.SLDPRT, switch-three-hinges-angled.SLDPRT, switch-two-hinges-angled.SLDPRT, switch-wide-cantilever.SLDPRT]
2025-10-26 aligned rightmost hinge center with linkage skeleton
    [switch-wide-cantilever.SLDPRT]
2025-10-26 try a few switch geometry modifications to make down postion a more stable equilibrium position
    [switch-compliant-link-lowered.SLDPRT, switch-compliant-link-lowered.STEP, switch-thin-compliant-link.SLDPRT, switch-thin-compliant-link.STEP, switch-thin-hinges.SLDPRT, switch-thin-hinges.STEP, switch-wide-cantilever.SLDPRT]
2025-10-27 thickened hook arm on test switches back to 3mm (previous commit had too thin a linkage, became compliant)
    [asm-benchtop-device.SLDASM, cam-transmission.SLDPRT, switch-compliant-link-lowered.SLDPRT, switch-compliant-link-lowered.STEP, switch-thin-compliant-link.SLDPRT, switch-thin-compliant-link.STEP, switch-thin-hinges.SLDPRT, switch-thin-hinges.STEP]
2025-10-27 create switch version combining three previous test switches: thin compliant link, lowered compliant link, and thin (0.5mm) living hinges
    [asm-benchtop-device.SLDASM, cam-transmission.SLDPRT, cam-transmission.STEP, switch-low-thin-compliant-link-thin-hinges.SLDPRT, switch-low-thin-compliant-link-thin-hinges.STEP]
2025-10-27 create test switch with thin and lowered compliant link (thicker hinges, 0.65 mm each)
    [switch-low-thin-compliant-link.SLDPRT, switch-low-thin-compliant-link.STEP]
2025-10-27 create test switch with longer compliant link, similar to the standalone switch from 10/15/25
    [asm-benchtop-device.SLDASM, asm-cams.SLDASM, cam-transmission.SLDPRT, cams-joined^asm-cams.STEP, derailleur-wide.SLDPRT, derailleur-wide.STEP, switch-compliant-link-staight-lengthened.SLDPRT, switch-compliant-link-staight-lengthened.STEP]
2025-10-27 incorporate switch geometry from successful standalone print on Oct. 15th to switch with wall that integrates with cam (WIP)
    [asm-benchtop-device.SLDASM, cam-transmission.SLDPRT, cam-transmission.STEP, switch-flexures-separate_v2_one-piece-spring-link-oct-15.SLDPRT, switch-oct-15-plus-wall.SLDPRT, switch-oct-15-plus-wall.STEP]
2025-11-03 create derailleur version that uses shoulder screw for axle (WIP)
    [6655K11_Thrust Ball Bearing.SLDPRT, 91831A005_18-8 Stainless Steel Nylon-Insert Locknut.SLDPRT, 97832A190_18-8 Stainless Steel Shoulder Screw.SLDPRT, 97832A191_18-8 Stainless Steel Shoulder Screw.SLDPRT, asm-benchtop-device.SLDASM, asm-cams.SLDASM, cam-storage.SLDPRT, cam-transmission.SLDPRT]
2025-11-05 adjust dimensions of derailleur jig to use a normal screw with a plastic sleeve as an axle (WIP)
    [asm-benchtop-device.SLDASM, asm-cams.SLDASM, cam-storage.SLDPRT, cam-transmission.SLDPRT, derailleur-jig-no-axle.SLDPRT, derailleur-jig-no-axle.STEP, derailleur-wide.SLDPRT, sleeve-hole-no-hole.SLDPRT]
2025-11-05 add axle sleeve to assembly
    [asm-benchtop-device.SLDASM, derailleur-wide.SLDPRT, switch-oct-15-plus-wall.SLDPRT]
2025-11-05 create version of oct. 15th switch with wall and same connection as 1-angled-hinge switch to test effect of connection
    [derailleur-jig-no-axle.STEP, sleeve-hole-no-hole.SLDPRT, sleeve-hole.STEP, sleeve-no-hole.STEP, switch-oct-15-plus-wall-thin-connection.SLDPRT, switch-oct-15-plus-wall-thin-connection.STEP, switch-oct-15-plus-wall.STEP, switch-one-hinge-angled.SLDPRT]
2025-11-06 create version of switch with length of links in central hinge increased by 1mm
    [switch-one-hinge-angled-increase-angle.SLDPRT, switch-one-hinge-angled-increase-angle.STEP, switch-one-hinge-angled.STEP]
2025-11-06 fix error in switch with increased angle that was cutting through cantilever
    [switch-one-hinge-angled-increase-angle.SLDPRT, switch-one-hinge-angled-increase-angle.STEP]
2025-11-07 alter geometry of switch with increased angle to align hinges with links; make central hinge designed to buckle through unstable point
    [switch-one-hinge-angled-increase-angle.SLDPRT]
2025-11-10 small edits to prepare buckled hinge swtich for 3D printing
    [switch-one-hinge-angled-increase-angle.SLDPRT, switch-one-hinge-angled-increase-angle.STEP]
2025-11-10 change end effector link length to get desired dy in buckled hinge switch
    [switch-one-hinge-angled-increase-angle.SLDPRT, switch-one-hinge-angled-increase-angle.STEP]
2025-11-11 clean up file directory
    [sleeve-hole.SLDPRT, sleeve-no-hole.SLDPRT, switch-compliant-link-lowered.SLDPRT, switch-compliant-link-staight-lengthened.SLDPRT, switch-flexures-separate_v2_one-piece-spring-link-oct-15.SLDPRT, switch-low-thin-compliant-link-thin-hinges.SLDPRT, switch-low-thin-compliant-link.SLDPRT, switch-oct-15-plus-wall-thin-connection.SLDPRT]
2025-11-11 integrate buckled-hinge switch into assembly (WIP)
    [asm-benchtop-device.SLDASM, cam-transmission.SLDPRT, cam-transmission.STEP, derailleur-wide.SLDPRT, switch-one-hinge-angled-increase-angle.SLDPRT, switch-one-hinge-angled-increase-angle.STEP]
2025-11-11 remove compliant link and replace with solid material. add material at rear of switch to fill up gap in cam
    [asm-benchtop-device.SLDASM, cam-transmission.SLDPRT, switch-one-hinge-angled-increase-angle.SLDPRT, switch-one-hinge-angled-increase-angle.STEP]
2025-11-12 3d print
    [cam-transmission.STEP, switch-one-hinge-angled-increase-angle.STEP]
2025-11-12 create switch to test having thick supports on either side of compliant mechanism
    [switch-one-hinge-angled-increase-angle-support-test.SLDPRT, switch-one-hinge-angled-increase-angle-support-test.STEP]
2025-11-13 create first version of buckled hinge switch with mechanism extended out horizontally (checkpoint, WIP)
    [asm-benchtop-device.SLDASM, cam-transmission.SLDPRT, switch-extended-mechanism.SLDPRT, switch-one-hinge-angled-increase-angle-0_5-mm.SLDPRT]
2025-11-13 make further changes to extended switch -- ready to test print (WIP)
    [asm-benchtop-device.SLDASM, cam-transmission.SLDPRT, switch-extended-mechanism.SLDPRT, switch-extended-mechanism.STEP]
2025-11-14 increase length of buckled hinge sides from 1 mm to 1.5 mm. adust size of up-to-down cantilever. remove material from wall behind mechanism. integrate updated geometry with cam
    [asm-benchtop-device.SLDASM, cam-transmission.SLDPRT, cam-transmission.STEP, switch-extended-mechanism.SLDPRT, switch-extended-mechanism.STEP]
2025-11-16 create switches with buckled hinge lengths that correspond to high and low stiffness range (1.0-1.5 mm)
    [switch-extended-mechanism-1_0mm.SLDPRT, switch-extended-mechanism-1_0mm.STEP, switch-extended-mechanism-1_1mm.SLDPRT, switch-extended-mechanism-1_1mm.STEP, switch-extended-mechanism-1_2mm.SLDPRT, switch-extended-mechanism-1_2mm.STEP, switch-extended-mechanism-1_3mm.SLDPRT, switch-extended-mechanism-1_3mm.STEP]
2025-11-17 integrate buckled hinge switch with cam and derailleur (WIP)
    [asm-benchtop-device.SLDASM, cam-transmission.SLDPRT, cam-transmission.STEP, derailleur-wide.SLDPRT, derailleur.SLDPRT, derailleur.STEP, derailleur_v3.SLDPRT, switch-extended-mechanism-1_0mm.SLDPRT]
2025-11-17 increase height of derailleur ramp to 7 mm. fix screw hole and unintended slot issues with cam transmission
    [asm-benchtop-device.SLDASM, cam-transmission.SLDPRT, cam-transmission.STEP, derailleur.SLDPRT, derailleur.STEP, switch-extended-mechanism-1_0mm.SLDPRT, switch-extended-mechanism-1_0mm.STEP]
2025-11-18 add slight clearance to working switch for tall derailleur ramp. adjust derailleur ramp angles for continuous cycling performance.
    [asm-benchtop-device.SLDASM, asm-cams.SLDASM, cam-storage.SLDPRT, cam-transmission.SLDPRT, derailleur-jig-no-axle.SLDPRT, derailleur-jig-no-axle.STEP, derailleur.SLDPRT, derailleur.STEP]
2025-11-18 add combined cam assembly to print
    [asm-cams.STEP]
2025-11-19 decrease diameter of up-to-down derailleur ramp by 0.5 mm. adjust switch to add needed clearance.
    [asm-benchtop-device.SLDASM, cam-transmission.SLDPRT, derailleur.SLDPRT, derailleur.STEP, switch-extended-mechanism-1_0mm.SLDPRT, switch-extended-mechanism-1_0mm.STEP]
2025-11-19 remove some material from cam derailleur slot that switch cantilever was getting caught on during transition
    [asm-benchtop-device.SLDASM, asm-cams.SLDASM, asm-cams.STEP, cam-storage.SLDPRT, cam-transmission.SLDPRT, cam-transmission.STEP, derailleur.STEP, switch-extended-mechanism-1_0mm.STEP]
2025-11-19 add features to increase stiffness of switch body
    [asm-benchtop-device.SLDASM, cam-transmission.SLDPRT, switch-extended-mechanism-1_0mm.SLDPRT, switch-extended-mechanism-1_0mm.STEP]
2025-11-19 remove more material from derailleur slot for switch clearance during transition
    [asm-cams.SLDASM, cam-transmission.SLDPRT]
2025-11-20 increase up-to-down derailleur height to 8mm from 7mm. adjust switch and cam to make room
    [asm-benchtop-device.SLDASM, asm-cams.SLDASM, asm-cams.STEP, cam-storage.SLDPRT, cam-transmission.SLDPRT, derailleur-jig-no-axle.SLDPRT, derailleur.SLDPRT, derailleur.STEP]
2025-11-20 apply altered derailleur ramp geometry to derailleur jig for benchtop test
    [derailleur-jig-no-axle.SLDPRT, derailleur-jig-no-axle.STEP, derailleur.SLDPRT]
2025-12-03 make derailleur and jig two separate parts to allow for modularity and faster manufacturing of different derailleur designs
    [asm-benchtop-device.SLDASM, asm-derailleur-jig.SLDASM, derailleur-jig-separate.SLDPRT, derailleur-separate.SLDPRT, thrust-bearing-outer.SLDPRT]
2025-12-03 strengthen derailleur ramp geometry
    [asm-cams.SLDASM, asm-derailleur-jig.SLDASM, cam-storage.SLDPRT, cam-transmission.SLDPRT, derailleur-jig-separate.SLDPRT, derailleur-separate.SLDPRT, switch-extended-mechanism-1_0mm.SLDPRT]
2025-12-04 rotate derailleur ramps relative to cams. lengthen down-to-up ramp to 3/16 of a rotation and increase nominal height to 2.25 mm
    [asm-cams.SLDASM, asm-derailleur-jig.SLDASM, cam-storage.SLDPRT, cam-transmission.SLDPRT, derailleur-jig-separate.SLDPRT, derailleur-separate.SLDPRT, switch-extended-mechanism-1_0mm.SLDPRT]
2025-12-04 prepare 3D print files
    [asm-derailleur-jig.SLDASM, derailleur-jig-separate.STEP, derailleur-separate.SLDPRT, derailleur-separate.STEP, switch-extended-mechanism-1_0mm.STEP]
2025-12-10 create alignment sketch and different configurations for sitting and standing angles. begin adjusting derailleur angles (WIP)
    [asm-cams.SLDASM, asm-derailleur-jig.SLDASM, cam-storage.SLDPRT, cam-transmission.SLDPRT, derailleur-jig-separate.SLDPRT, derailleur-separate.SLDPRT, derailleur.SLDPRT, switch-extended-mechanism-1_0mm.SLDPRT]
2025-12-10 alter derailleur angles (WIP)
    [asm-benchtop-device.SLDASM, asm-cams.SLDASM, asm-derailleur-jig.SLDASM, cam-storage.SLDPRT, cam-transmission.SLDPRT, derailleur-jig-separate.SLDPRT, derailleur-separate.SLDPRT, derailleur.SLDPRT]
2025-12-10 first draft of altered derailleur angles. up-to-down switch now occurs at end of stand-to-sit. down-to-up switch now occurs at beginning of stand-to-sit. derailleur ramp sweeps are based on spline 3D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
    [asm-benchtop-device.SLDASM, asm-cams.SLDASM, asm-derailleur-jig.SLDASM, cam-storage.SLDPRT, cam-transmission.SLDPRT, derailleur-jig-separate.SLDPRT, derailleur-jig-separate.STEP, derailleur-separate.SLDPRT]
2025-12-11 increase down-to-up derailleur height to 3mm from 2.25 mm
    [derailleur-separate.SLDPRT, derailleur-separate.STEP]
2025-12-12 increase height of up-to-down derailleur ramp by 0.75 mm to 8.75 mm total
    [asm-derailleur-jig.SLDASM, derailleur-jig-separate.SLDPRT, derailleur-separate.SLDPRT, derailleur-separate.STEP]
2025-12-13 make changes to up-to-down derailleur ramp: rotate start location counter-clockwise. spread ramp out to cover 120 degrees. make symmetric. change profile to a circle
    [asm-derailleur-jig.SLDASM, derailleur-jig-separate.SLDPRT, derailleur-separate.SLDPRT, derailleur-separate.STEP]
2025-12-13 update folder organization to reflect actual printing dates
    [derailleur-separate.STEP]
2025-12-14 move transmission cable anchor to align with stand-to-sit groove
    [asm-cams.SLDASM, cam-transmission.SLDPRT]
2025-12-14 create file for 3D printing
    [asm-cams.SLDASM, asm-cams.STEP, cam-storage.SLDPRT, cam-transmission.SLDPRT]
2025-12-18 add assembly exploded view
    [asm-benchtop-device.SLDASM, asm-cams.SLDASM, asm-derailleur-jig.SLDASM, cam-transmission.SLDPRT, derailleur-jig-separate.SLDPRT, derailleur-separate.SLDPRT, derailleur.SLDPRT, switch-extended-mechanism-1_0mm.SLDPRT]
2025-12-18 produce cams with different stiffness and maximum force parameters
    [_force_output0.csv, _force_output1.csv, _force_output10.csv, _force_output100.csv, _force_output101.csv, _force_output102.csv, _force_output103.csv, _force_output104.csv]
2026-01-08 create knee_angle_to_stance function for better modularity with export of F vs stance percentage data
    [force_plot_63_extracted.csv]
2026-01-08 create derailleur insert without cam ramps for low-friction test device
    [derailleur-separate-no-ramps.SLDPRT, derailleur-separate-no-ramps.STEP]
2026-01-13 update saved variable names. add flag to switch between si-st and st-si.
    [si2st_force_plot_63_extracted.csv, st2si_force_plot_extracted.csv]
2026-01-13 create versions of parts without switch and derailleurs
    [asm-cams-no-switching.SLDASM, asm-cams.SLDASM, cam-storage.SLDPRT, cam-transmission-no-switching.SLDPRT, cams-joined^asm-cams-no-switching.SLDPRT, derailleur-jig-no-switching.SLDPRT, derailleur-jig-separate.SLDPRT, derailleur-separate-no-ramps.SLDPRT]
2026-05-18 Modify cam geometry to accommodate ball thrust bearing. Make 2 transmission cam cable anchors, each aligned with one groove. Add indicator lines aligned with 0 and 220 degrees (standing and sitting).
    [Part1^asm-cams-no-switching.STEP, asm-cams-no-switching.SLDASM, asm-cams.SLDASM, cam-storage.SLDPRT, cam-transmission-no-switching.SLDPRT, cams-joined^asm-cams-no-switching.SLDPRT, derailleur-jig-no-switching.SLDPRT, derailleur-jig-no-switching.STEP]
2026-06-06 create version of cam assembly with ball thrust bearings. begin tracking points for point cloud export of implemented cam shape (augmented between 220 and 360 degrees)
    [cam-transmission-point-cloud-export.SLDPRT]
2026-06-06 add code to calculate actual effective radii for gear ratio at each point
    [_force_output0.csv, _force_output1.csv, _force_output10.csv, _force_output100.csv, _force_output101.csv, _force_output102.csv, _force_output103.csv, _force_output104.csv]
2026-06-06 export points from augmented sit-to-stand cam shape
    [cam_transmission_curve_si2st_augmented.SLDPRT, si2st_augmented_points.csv]
2026-06-06 analyze stroke length. add exploded view with new bearings.
    [cam_transmission_curve_si2st_augmented.SLDPRT]
2026-06-06 add exploded view with thrust ball bearings
2026-06-06 revert cam stroke length calculation to arc segments from spline segments
    [si2st_augmented_points.csv]
2026-07-23 create assembly for manual cable endpoint switching
    [8381K29_Miniature Ball Bearing Carriage and Guide Rail.SLDPRT]
2026-07-23 integrate linear rail with cam assembly (WIP)
    [8381K29_Miniature Ball Bearing Carriage and Guide Rail.SLDPRT, 97832A192_18-8 Stainless Steel Shoulder Screw.SLDPRT, asm-cams-manual-switching.SLDASM, cam-storage.SLDPRT, cam-transmission-manual-switching.SLDPRT, carriage-cable-adapter.SLDPRT, derailleur-jig-no-switching.SLDPRT]
2026-07-26 add features for linear slider and prepare first article 3D print files
    [57155K346_Stainless Steel Ball Bearing.SLDPRT, 6655K11_Thrust Ball Bearing.SLDPRT, 8381K29_Miniature Ball Bearing Carriage and Guide Rail.SLDPRT, 97832A190_18-8 Stainless Steel Shoulder Screw.SLDPRT, Part1^asm-cams-manual-switching.STEP, asm-benchtop-device-manual-switching.SLDASM, asm-cams-manual-switching.SLDASM, asm-cams.SLDASM]
2026-07-27 update parts after first article inspection. add detachable block for linear rail attachment. create parts for second article 3D print
    [91800A057_18-8 Stainless Steel Cheese Head Slotted Screw.SLDPRT, Part1^asm-cams-manual-switching.STEP, asm-benchtop-device-manual-switching.SLDASM, asm-cams-manual-switching.SLDASM, cam-transmission-manual-switching.SLDPRT, carriage-cable-adapter.SLDPRT, carriage-cable-adapter.STEP, linear-rail-assembly.SLDASM]
2026-07-27 increase size of carriage adapter cable pass-through hole. add adapter screws to assembly
    [91430A155_18-8 Stainless Steel Slotted Flat Head Screw.SLDPRT, Part1^asm-cams-manual-switching.STEP, asm-benchtop-device-manual-switching.SLDASM, asm-cams-manual-switching.SLDASM, carriage-cable-adapter.SLDPRT, carriage-cable-adapter.STEP, linear-rail-assembly.SLDASM, linear-rail-attachment-block.STEP]
2026-08-28 Correct knee angle scaling calculation in calc_forces function. Fix bugs in calling notebooks for working with refactored class_cam_generation.py. Update target stance percentage for peak force to 40%
    [_force_output0.csv, _force_output1.csv, _force_output10.csv, _force_output100.csv, _force_output101.csv, _force_output102.csv, _force_output103.csv, _force_output104.csv]
2026-09-01 Update cable force modeling to use more accurate estimate of cable moment arm by considering all projected moment arms in vicinity of each cam point (in get_moment_arms function). Refactor calc_force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
    [_force_output0.csv, _force_output1.csv, _force_output10.csv, _force_output100.csv, _force_output101.csv, _force_output102.csv, _force_output103.csv, _force_output104.csv]
2026-09-08 Clean up comments and "dead code" for improved readability.
    [_force_output63.csv]
2026-09-15 Clean up code for readability. Re-name sub-folders in results/ for clarity.
    [_force_output.csv, _force_output.xlsx, _force_output0.csv, _force_output1.csv, _force_output10.csv, _force_output100.csv, _force_output101.csv, _force_output102.csv]
2026-09-16 Clean up output plot formatting.
    [_force_output0.csv, _force_output1.csv, _force_output10.csv, _force_output100.csv, _force_output101.csv, _force_output102.csv, _force_output103.csv, _force_output104.csv]
2026-09-17 Set a constant axis limit to cam shape plot.
    [_force_output0.csv, _force_output1.csv, _force_output10.csv, _force_output100.csv, _force_output101.csv, _force_output102.csv, _force_output103.csv, _force_output104.csv]
2026-09-21 add exploded view to linear rail assembly
2026-10-09 create jig to test press-fit ball-nose spring plunger detents with linear slider
2026-10-13 add detent recesses to switch handle and move press fit holes to align
2026-10-13 update detent recess size and spacing to allow enough buffer space for 3D printing filament layer
2026-10-19 Alter detent holes for two different adjustable detent sizes. Begin adding detents to cams (WIP)
